phong1990/fufo-innovation/Document/04.Design/FUFO_VP/PCInterface.png

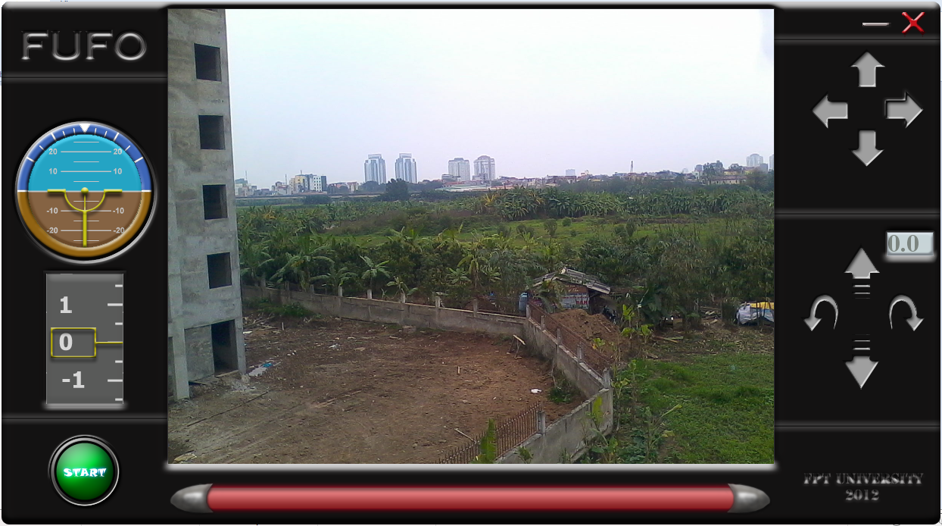
Document/04.Design/FUFO_VP/PCInterface.png
