phong1990/fufo-innovation/SourceCode/VP/AOC/pic/1009.jpg

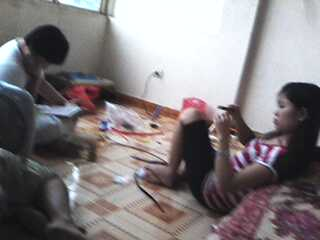
SourceCode/VP/AOC/pic/1009.jpg
