phong1990/fufo-innovation/Document/00.Other/Final_Report.pptx

## FUFO overview

Confidential document

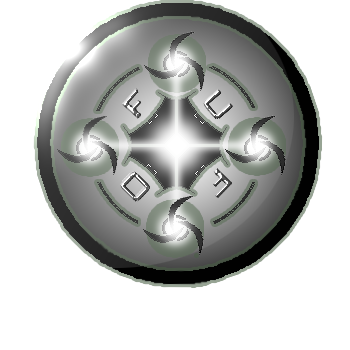
[picture p3: figure]

## Contents

1

Introduction

2

Hardware & Software

3

Algorithms

Experiments and results

4

5

Conclusion

## History

- Definition:
  - A Vertical Take-Off and Landing aircraft.
  - Has 4 rotors.

Introduction

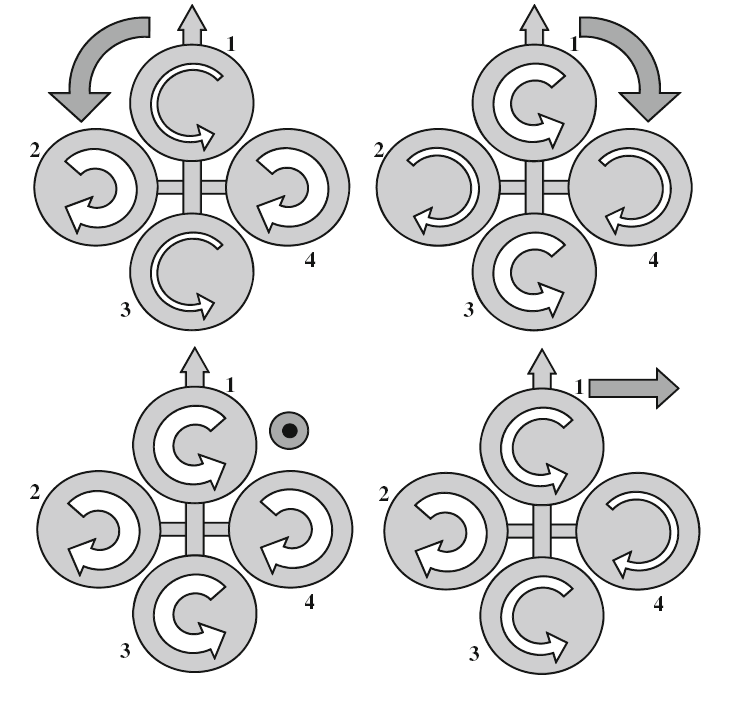
[picture p4: figure]

## History

- The first Quadrocopter was developed in 1920.
- No commercialized Quadrocopter because: Limitation of technology and science at that time.

Introduction

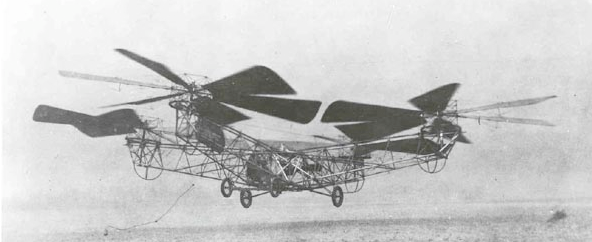
[picture p5: figure]

## History

Introduction

- 8 years before 2012, many institutes and companies began to research on this platform as a small UAV.

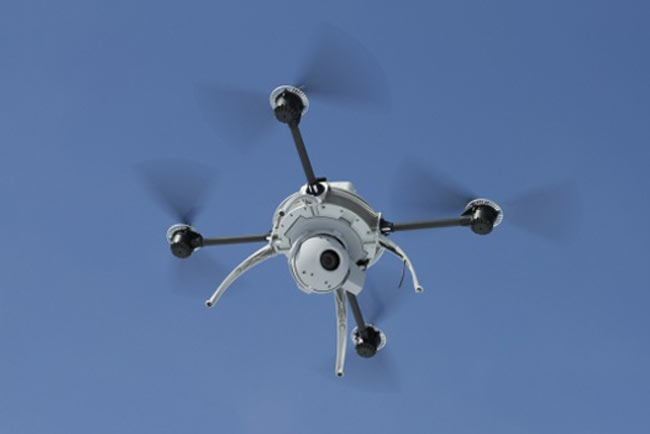
[picture p6: figure]
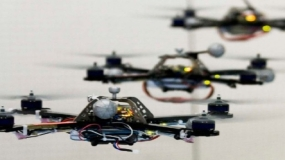
[picture p7: figure]

## Commercialized product

Introduction

- Airbot X600-BKPP (€ 34,500)
  - Radio control unit (2.4 GHz)
  - Live video stream
  - GPS waypoint navigation
- CyberQuad Maxi ($ 36,000)
  - Radio control unit
  - GPS waypoint navigation
  - Live video stream

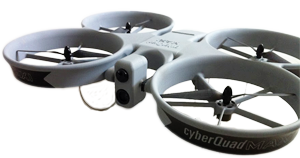
[picture p8: figure]

## Idea

Introduction

  - Develop a Quadrocopter for observation purpose.

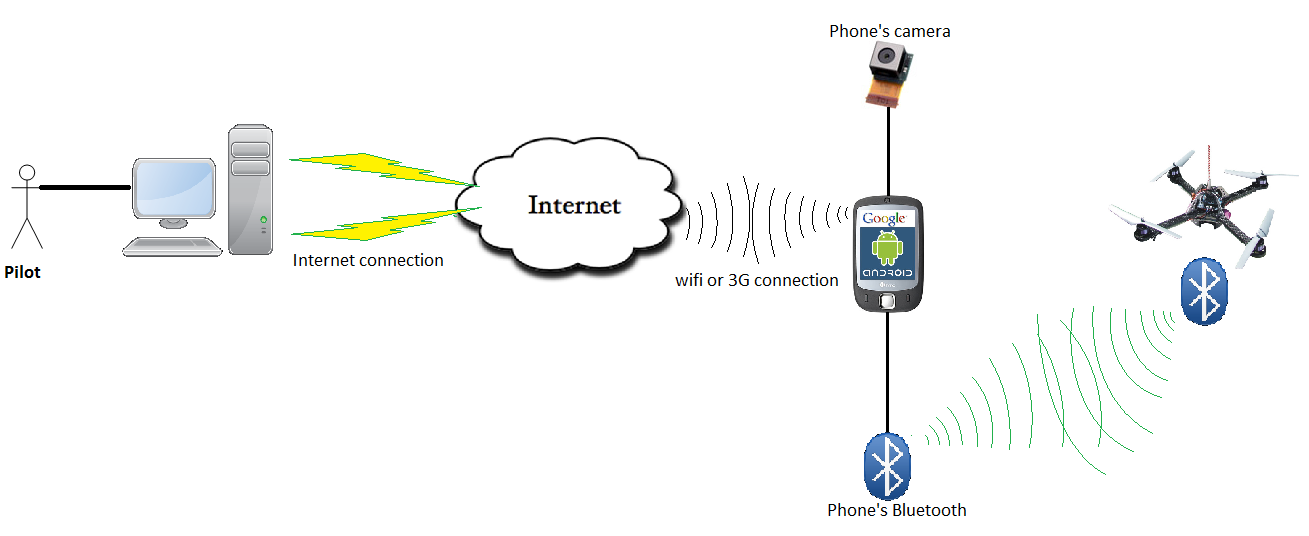
[picture p9: figure]

## Idea

Introduction

Why choosing Quadrocopter platform?

| Quadrocopter | Helicopter | Fixed-Wing aircraft
Aerodynamics mechanical design | No | Yes | Yes
Control method | Medium | Medium | Complicated
Runway | No | No | Yes

→ Quadrocopter is more suitable for embedded Engineering students who are not familiar with aerospace issue and mechanical design.

## Idea

Introduction

Why choosing Android Phone?

| Android phone | In-circuit designs
Software development | Android SDK | Linux, C30…
Evaluation of controlling by phone/tablet via Bluetooth? | Yes | No
Risk and complexity in hardware design | Low | High
Cost | Low | High

Has built-in camera, Wi-Fi, 3G module

Phone is still usable after this Capstone project

## Idea

Introduction

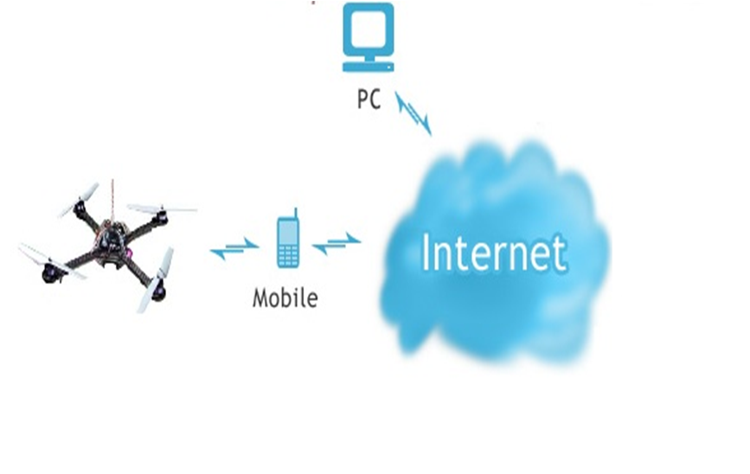
[picture p10: figure]

Command

Sensor data

Bluetooth

## Idea

Introduction

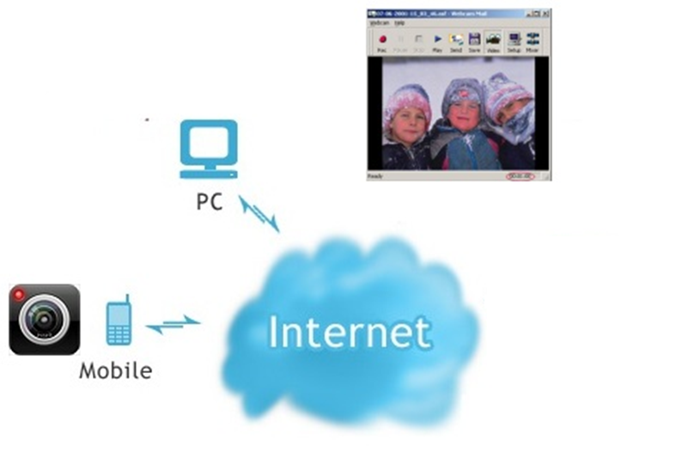
[picture p11: figure]

Picture

Picture

JPEG

JPEG

## Idea

Introduction

Control Mode

Autonomous(Dynamic Stabilization)

Manual

## Idea

Introduction

Wind

Manual mode

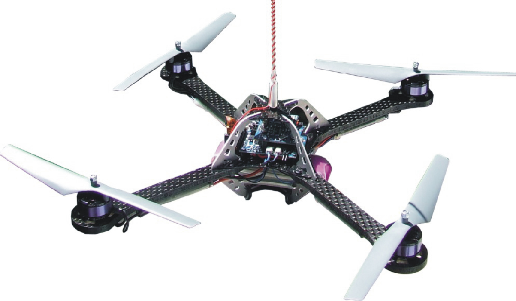
[picture p12: figure]

## Idea

Introduction

Dynamic stabilization

Wind

Dynamic Stablization

SAFE

Go to 1m

## Hardware study

Hard & Soft

No. | Components | Quantity | Description
1 | dsPIC30f4012 | 1 | Microcontroller
2 | HC-06 | 1 | Bluetooth module
3 | BMP085 | 1 | Barometer
4 | L3G4200D | 1 | Gyroscope
5 | ADXL345 | 1 | Accelerometer
6 | HW 30A ESC | 4 | Electronic speed Controller
7 | Himodel 2212 1400kv | 4 | Brushless motor
8 | Turnigy 3000mAh 11.1v 3s | 2 | Li-Po battery pack.
9 | HTC HD2 | 1 | Android 2.3 phone

## Hardware study

Hard & Soft

- dsPIC30f4012 Microcontroller
  - Max speed: 30 MIPS
  - 16x16 bit working arrays
  - 5 timers, 3 PWM generators
  - Programmable by C30.

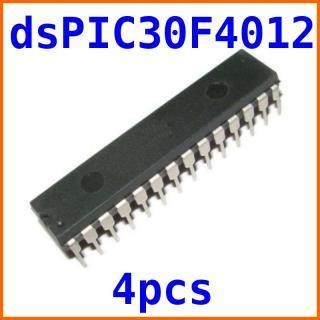
[picture p13: figure]
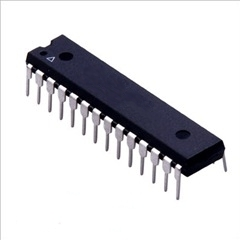
[picture p14: figure]

## Hardware study

Hard & Soft

- BMP085 + ADX345 + L3G4200D
  - All-in-one module:
    - 3-axis accelerometer.
    - 3-axis gyroscope.
    - -300m to 9000m altimeter.

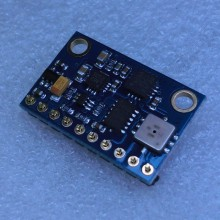
[picture p15: figure]
T1gdiIXh0bXXX2ojQ0_035736__90155_std

## Hardware study

Hard & Soft

- Turnigy 3000mAh battery pack
  - 3000mAh x 2
  - 253 grams x 2
  - 11.1v
  - Discharge rate: 20C

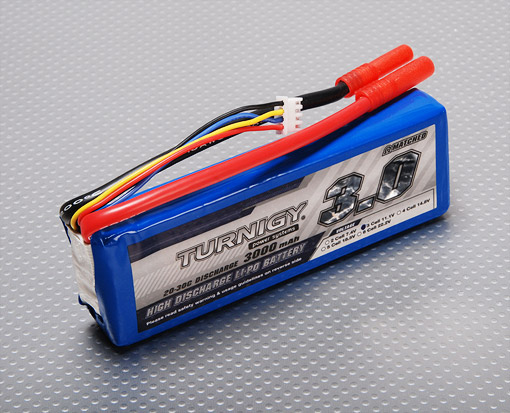
[picture p16: figure]
Turnigy 3000mAh 3S 20C Lipo Pack (USA Warehouse)

## Hardware study

Hard & Soft

- Motor and ESC
  - 1400kv Brushless motors
  - 8x4” propellers
  - ESC PWM range: 1ms – 2ms

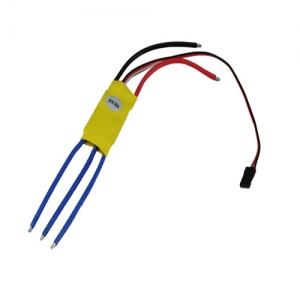
[picture p17: figure]
Brushless Motor Speed Controller
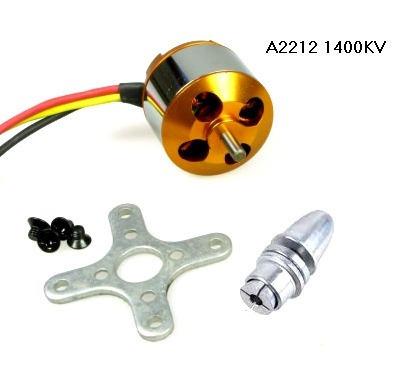
[picture p18: figure]

## Hardware study

Hard & Soft

- HTC HD2 Android 2.3
  - 320x240 camera.
  - Has Bluetooth and Wi-Fi connection
  - Run on Android 2.3

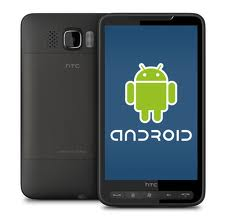
[picture p19: figure]

## Hardware design

Hard & Soft

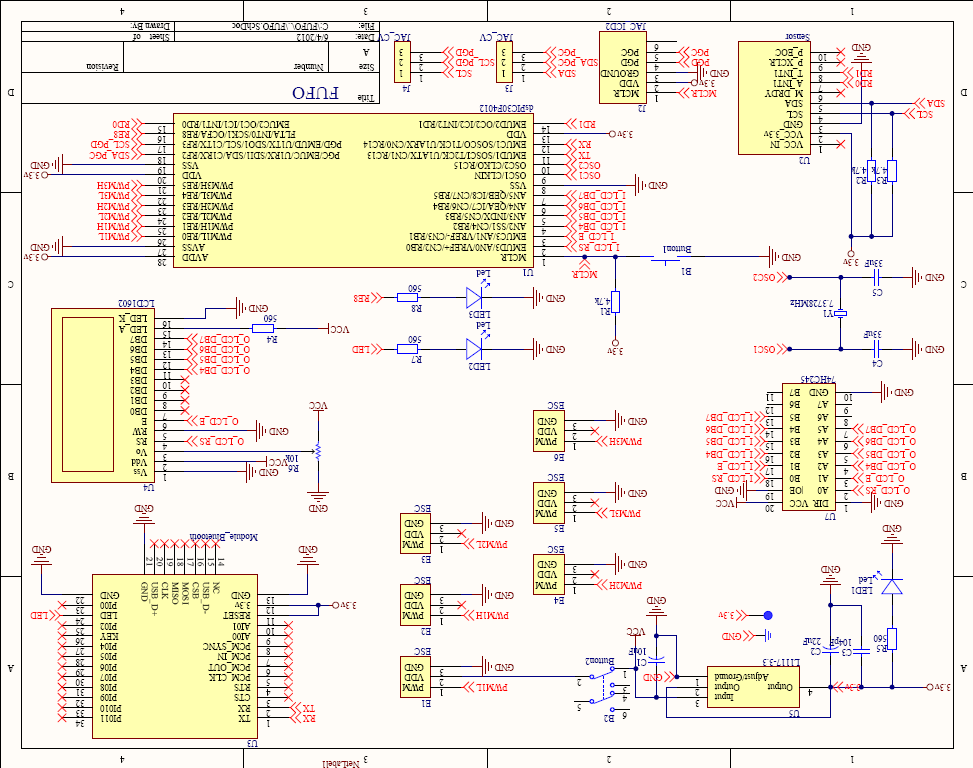
[picture p20: figure]

## Hardware design

Hard & Soft

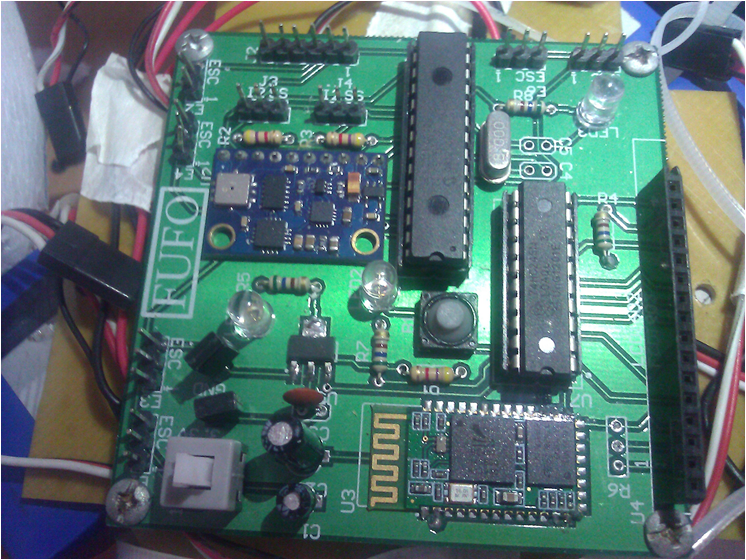
[picture p21: figure]

## Frame design

Hard & Soft

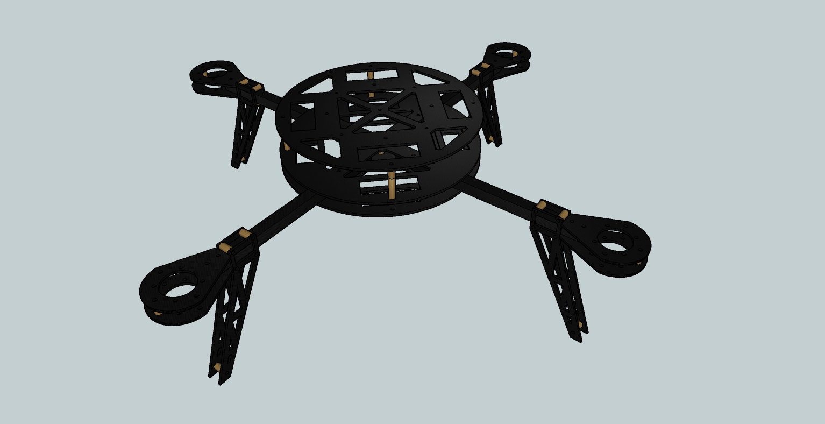
[picture p22: figure]

Circuit mount

Motor mount

440 mm

Fiber Glass & Fiber Carbon

## Software study

Hard & Soft

- Turnigy 3000mAh battery pack
  - 3000mAh x 2
  - 253 grams x 2
  - 11.1v
  - Discharge rate: 20C

## Software study

Hard & Soft

## Slide 26

www.themegallery.com

Thank You !

Confidential document

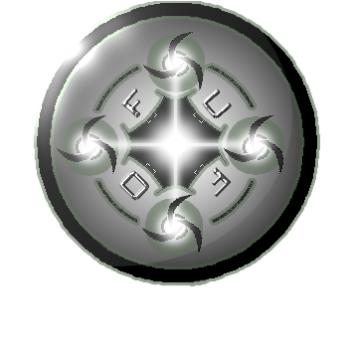
[picture p23: figure]
