phong1990/fufo-innovation/Anh/IMG_3640.JPG

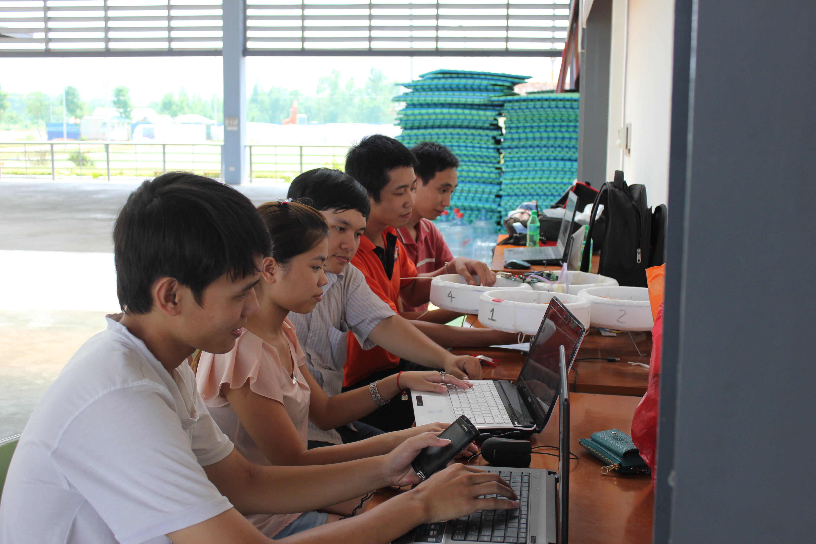
Anh/IMG_3640.JPG
