phong1990/fufo-innovation/Anh/IMG_3641.JPG

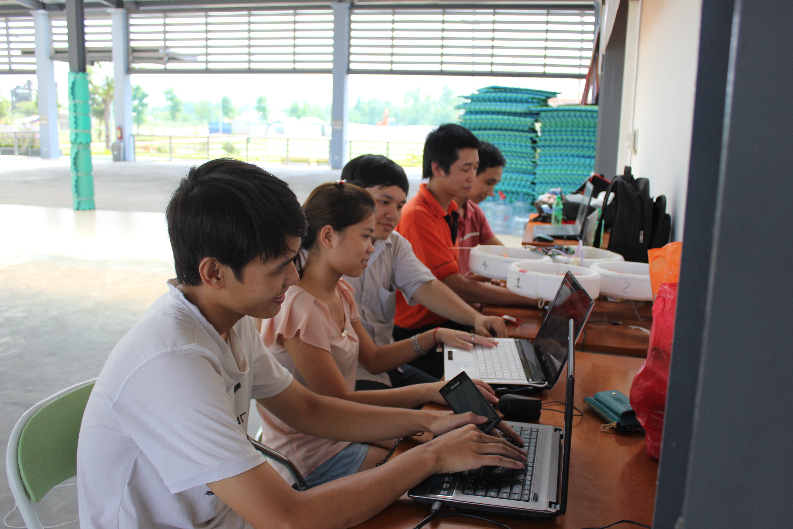
Anh/IMG_3641.JPG
