phong1990/fufo-innovation/Anh/IMG_3642.JPG

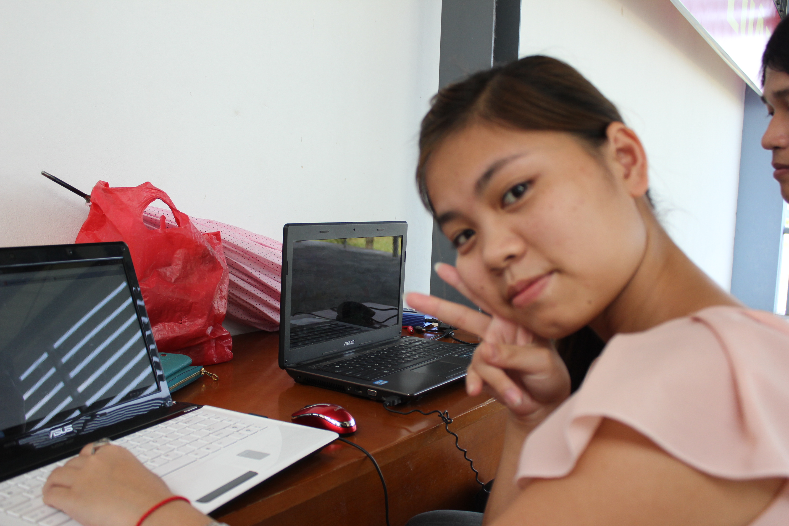
Anh/IMG_3642.JPG
