phong1990/fufo-innovation/Anh/IMG_3645.JPG

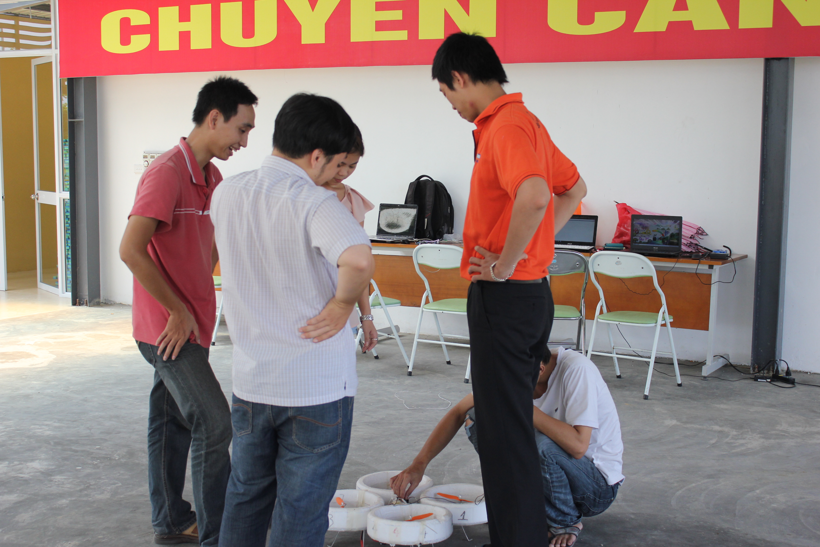
Anh/IMG_3645.JPG
