phong1990/fufo-innovation/Anh/IMG_3652.JPG

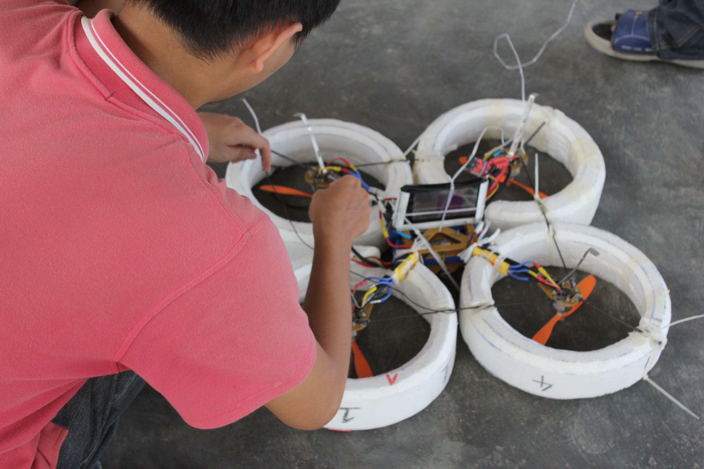
Anh/IMG_3652.JPG
