phong1990/fufo-innovation/Anh/IMG_3666.JPG

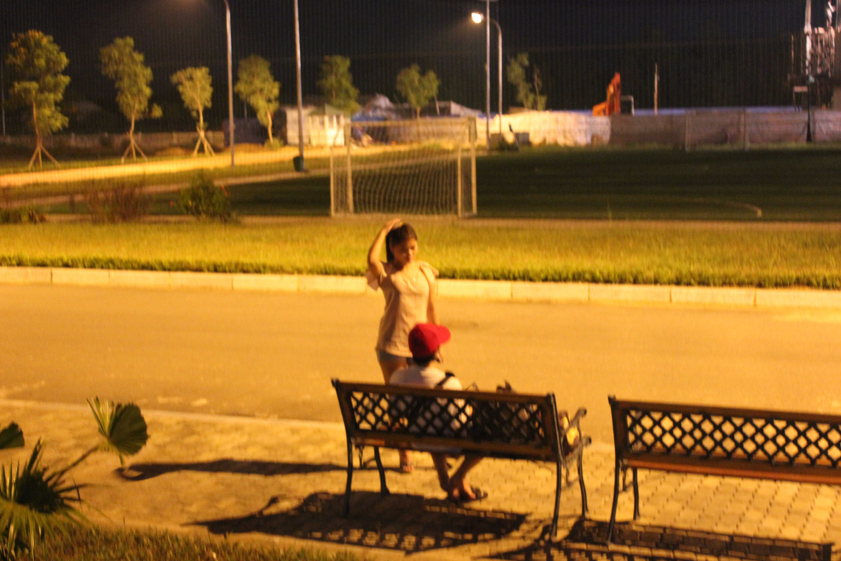
Anh/IMG_3666.JPG
