phong1990/fufo-innovation/Anh/IMG_3668.JPG

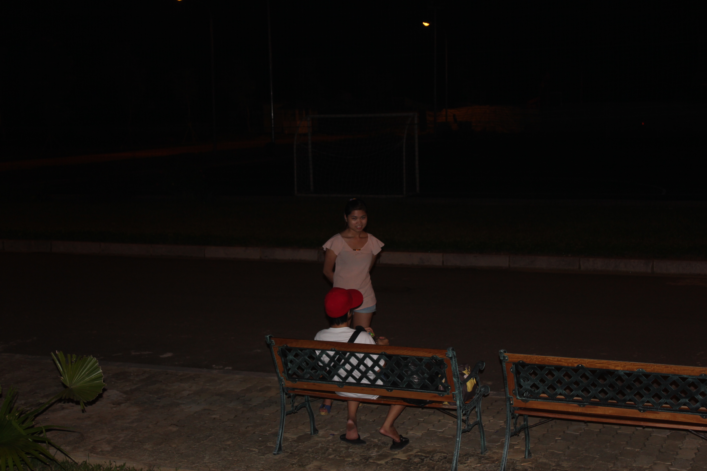
Anh/IMG_3668.JPG
