phong1990/fufo-innovation/Anh/IMG_3669.JPG

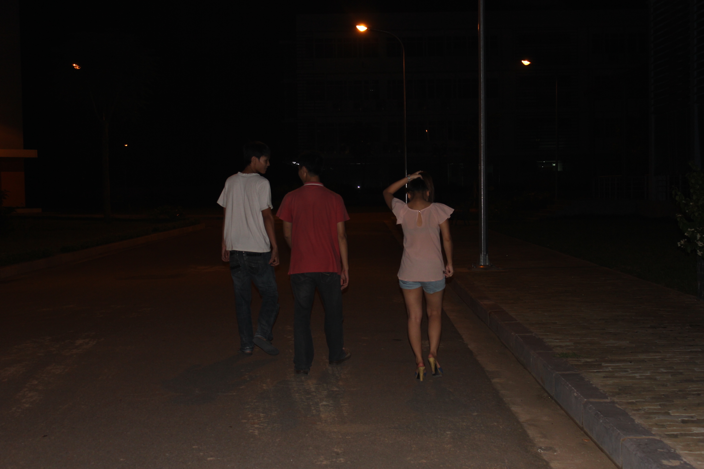
Anh/IMG_3669.JPG
