phong1990/fufo-innovation/Anh/IMG_3670.JPG

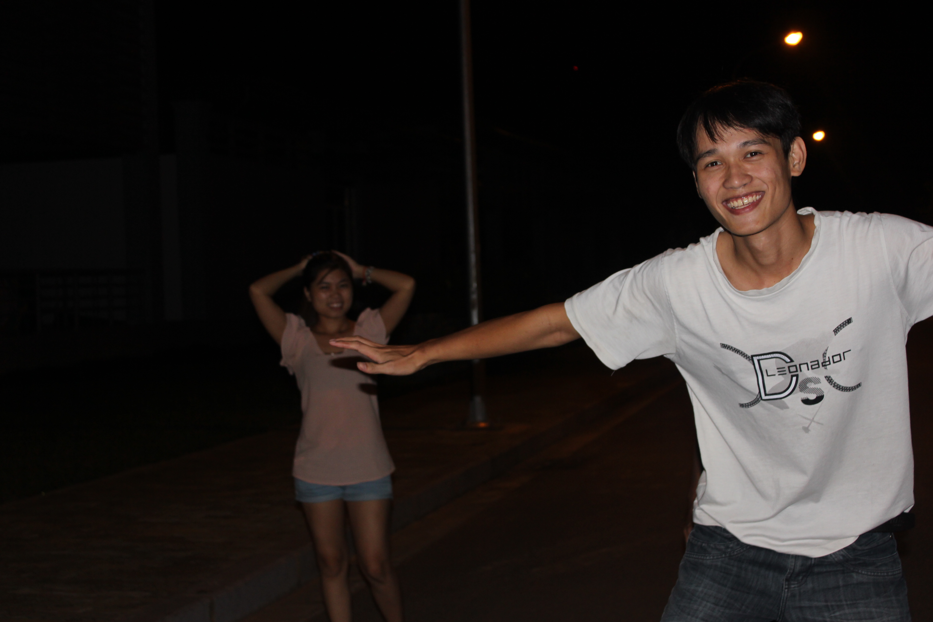
Anh/IMG_3670.JPG
