phong1990/fufo-innovation/Anh/IMG_3671.JPG

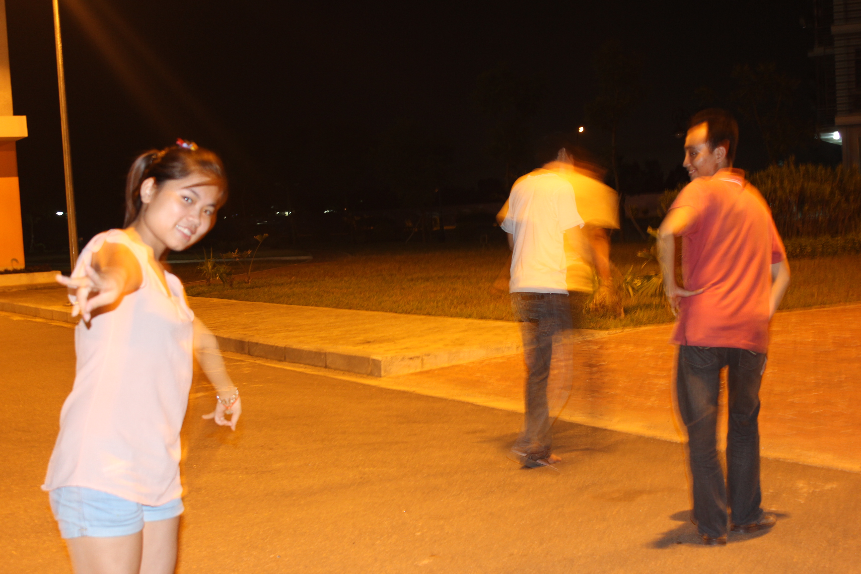
Anh/IMG_3671.JPG
