phong1990/fufo-innovation/Anh/IMG_3672.JPG

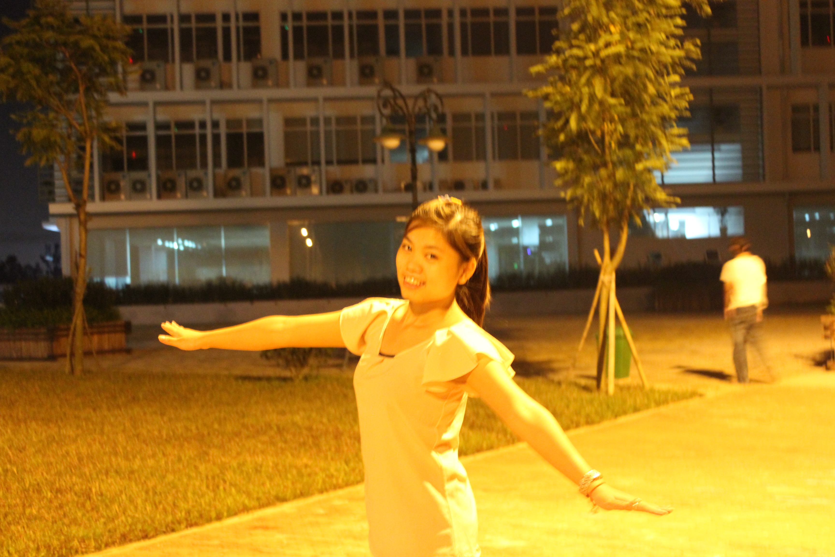
Anh/IMG_3672.JPG
