phong1990/fufo-innovation/Anh/IMG_3673.JPG

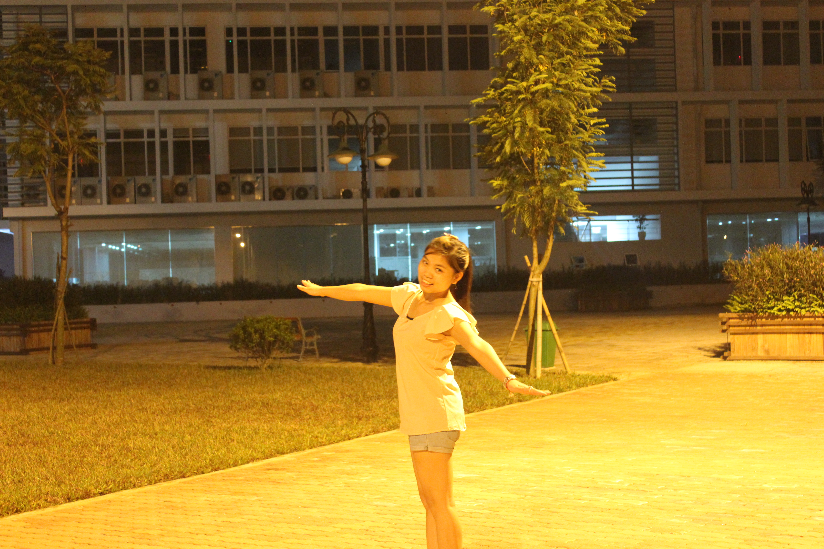
Anh/IMG_3673.JPG
