phong1990/fufo-innovation/Anh/IMG_3679.JPG

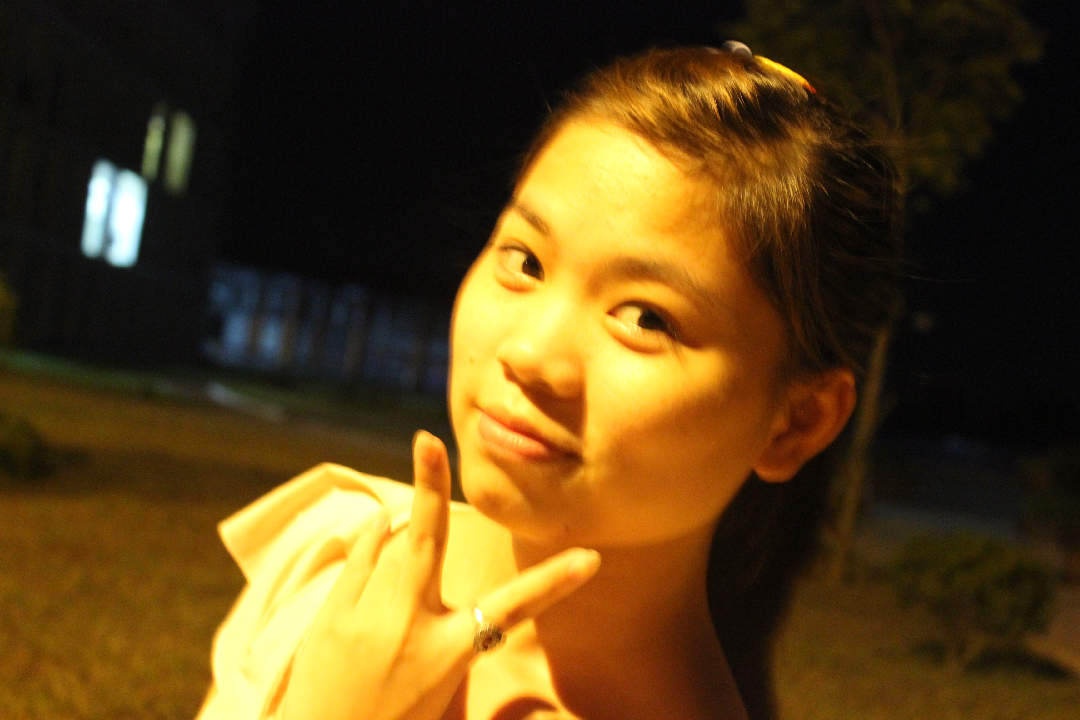
Anh/IMG_3679.JPG
