phong1990/fufo-innovation/Anh/IMG_3681.JPG

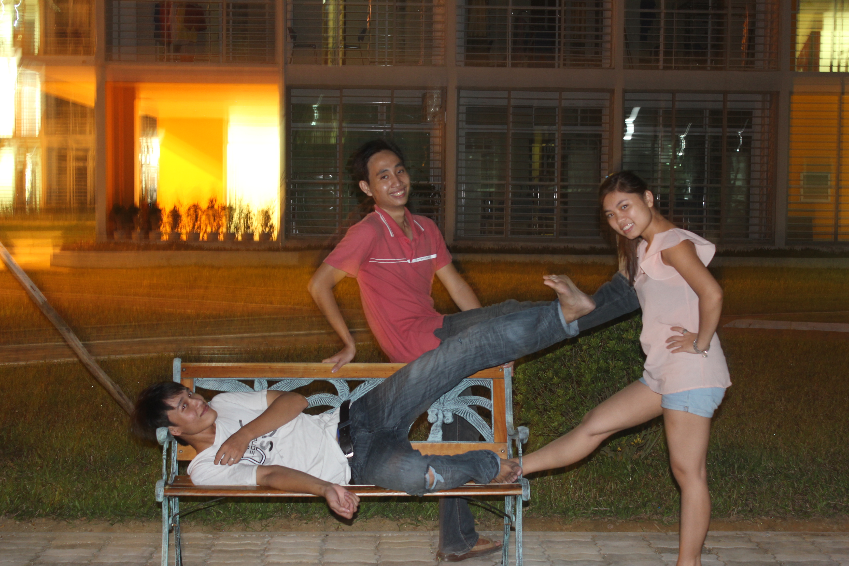
Anh/IMG_3681.JPG
