phong1990/fufo-innovation/Anh/IMG_3682.JPG

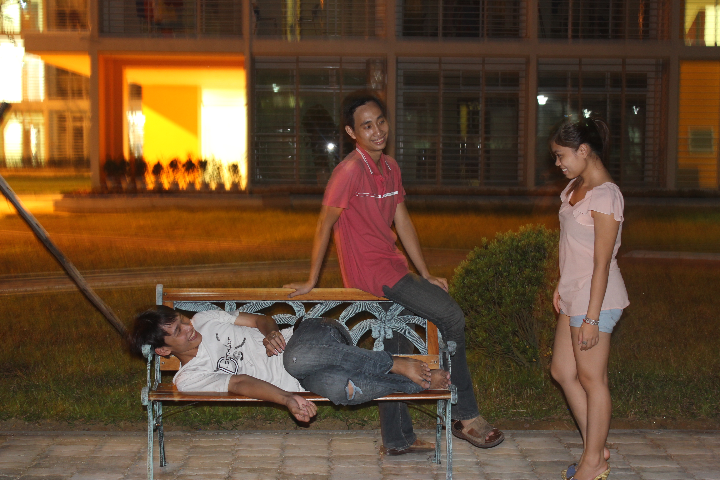
Anh/IMG_3682.JPG
