phong1990/fufo-innovation/Anh/IMG_3683.JPG

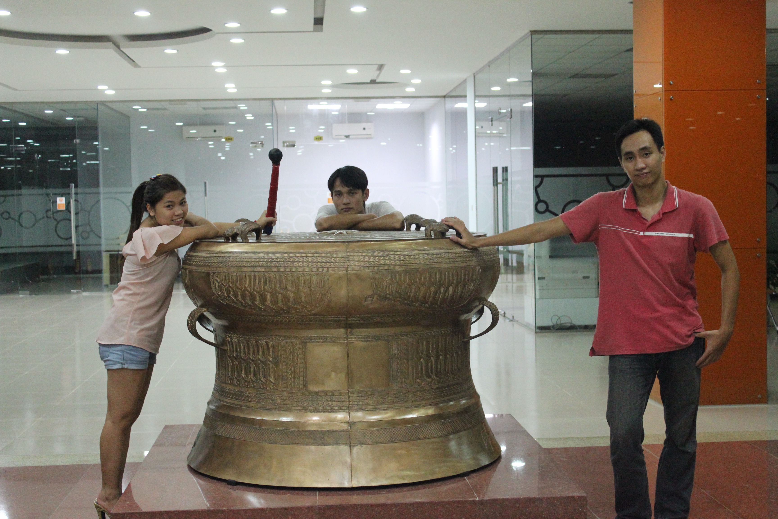
Anh/IMG_3683.JPG
