phong1990/fufo-innovation/Anh/IMG_3686.JPG

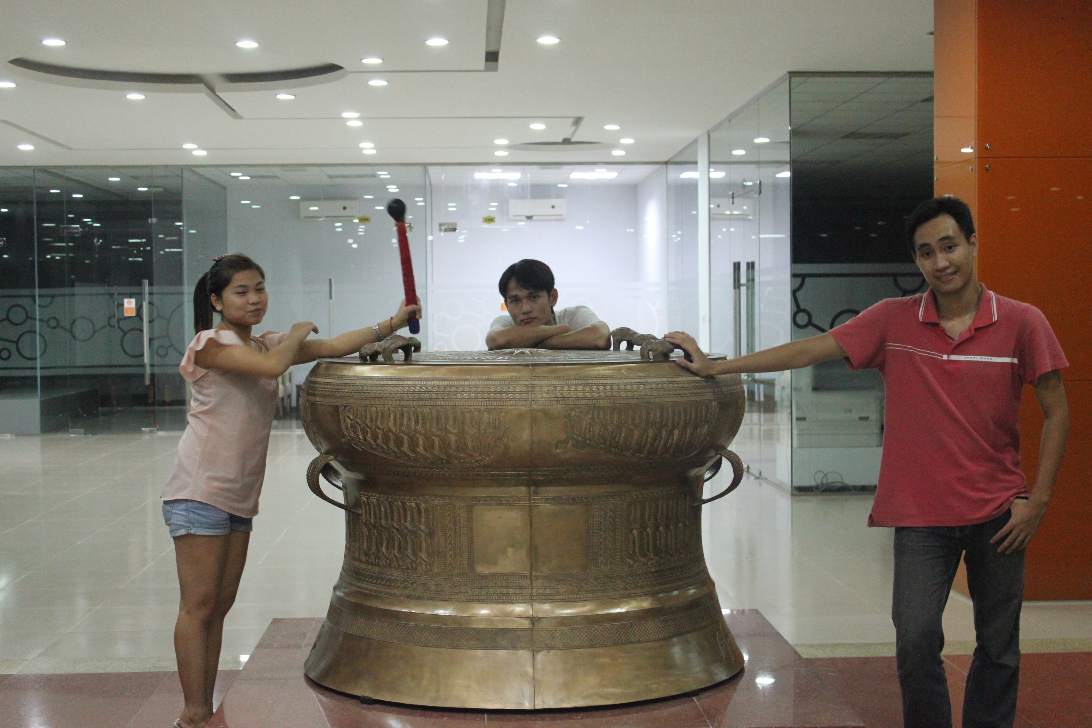
Anh/IMG_3686.JPG
