phong1990/fufo-innovation/Anh/IMG_3689.JPG

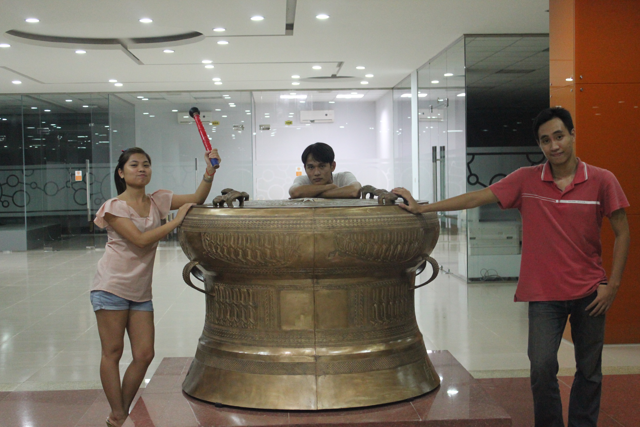
Anh/IMG_3689.JPG
