phong1990/fufo-innovation/Anh/IMG_3690.JPG

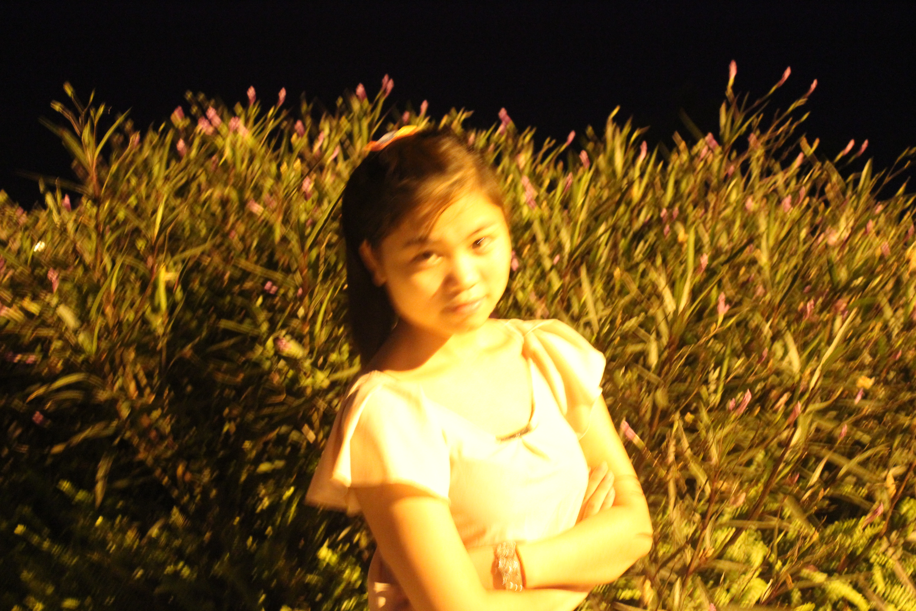
Anh/IMG_3690.JPG
