phong1990/fufo-innovation/Anh/IMG_3693.JPG

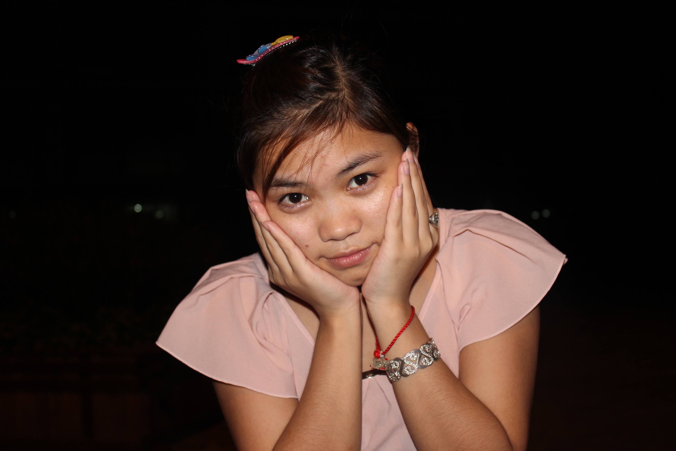
Anh/IMG_3693.JPG
