phong1990/fufo-innovation/Anh/IMG_3694.JPG

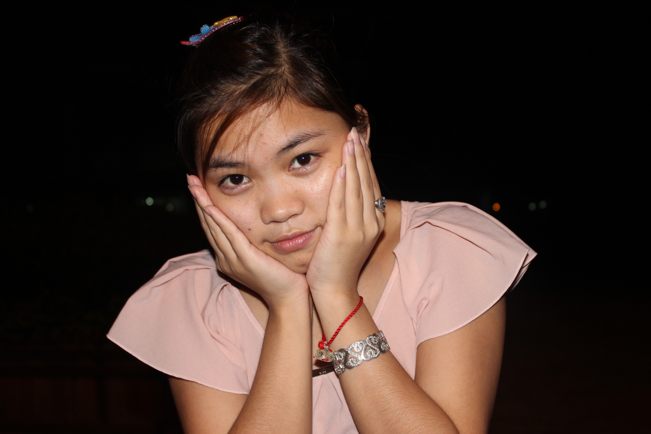
Anh/IMG_3694.JPG
