phong1990/fufo-innovation/Anh/IMG_3695.JPG

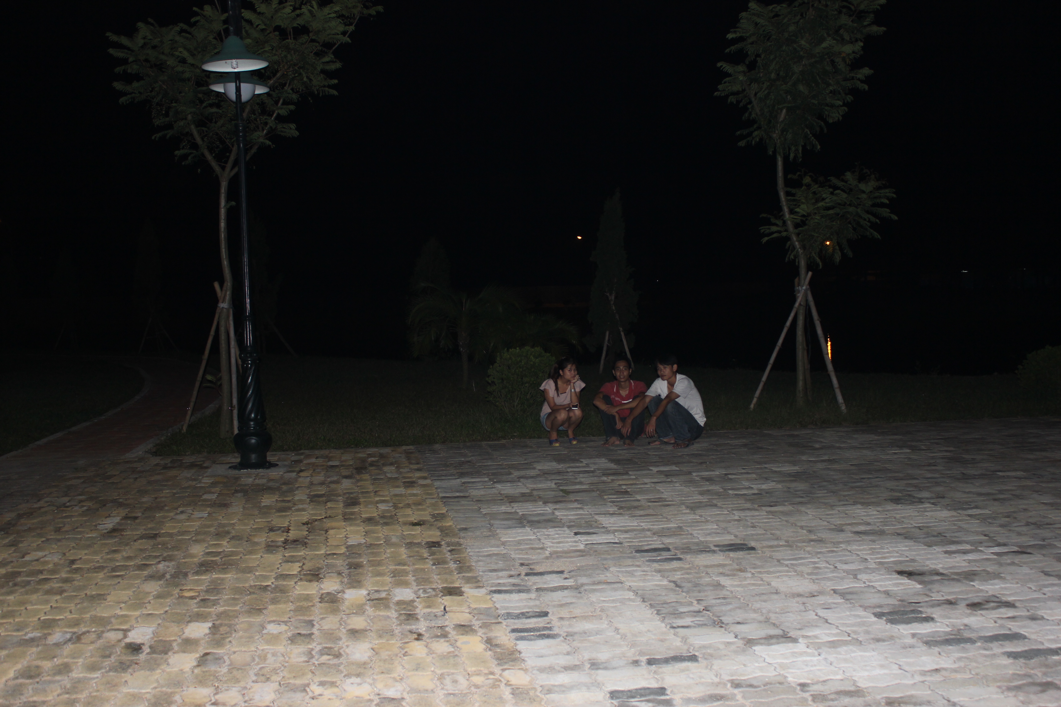
Anh/IMG_3695.JPG
