phong1990/fufo-innovation/Anh/IMG_3696.JPG

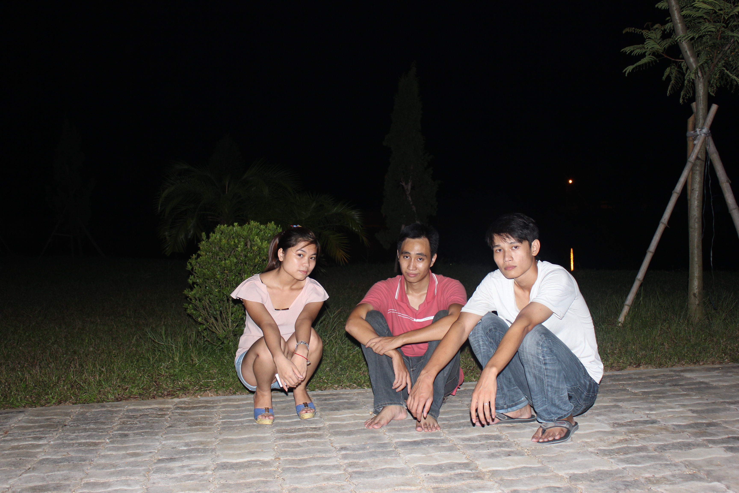
Anh/IMG_3696.JPG
