phong1990/fufo-innovation/Anh/IMG_3697.JPG

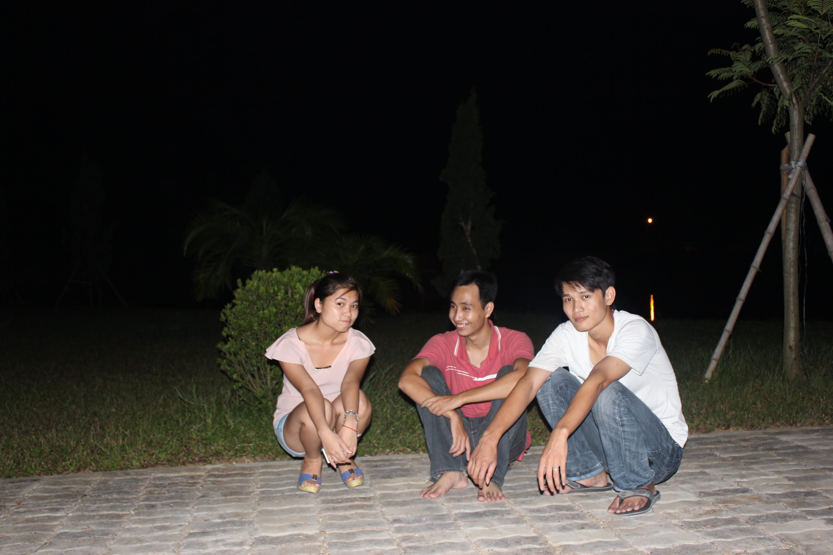
Anh/IMG_3697.JPG
