phong1990/fufo-innovation/Anh/IMG_3698.JPG

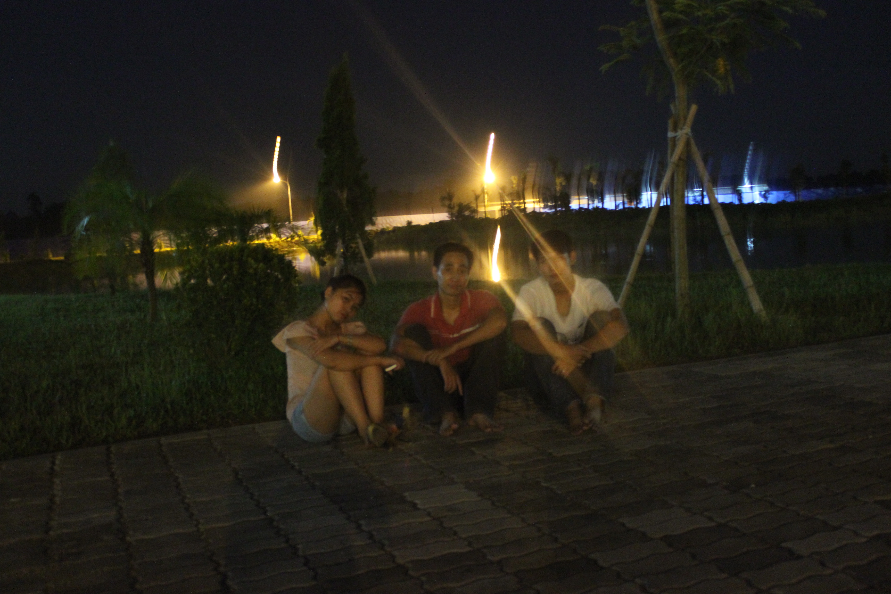
Anh/IMG_3698.JPG
