phong1990/fufo-innovation/Anh/IMG_3699.JPG

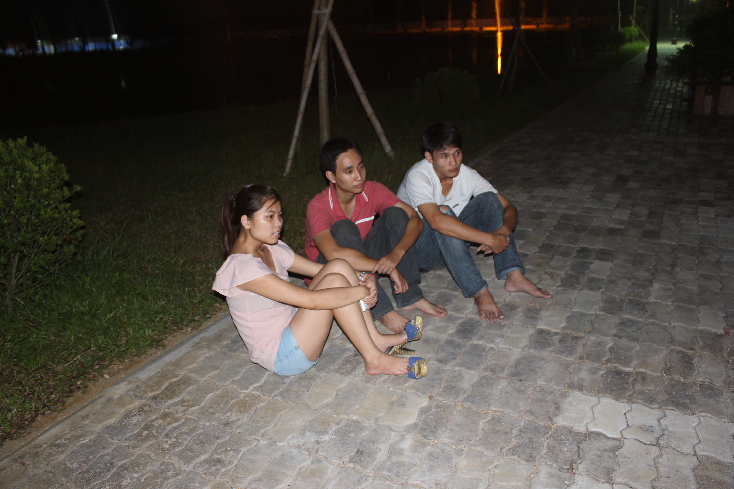
Anh/IMG_3699.JPG
