phong1990/fufo-innovation/Anh/IMG_3700.JPG

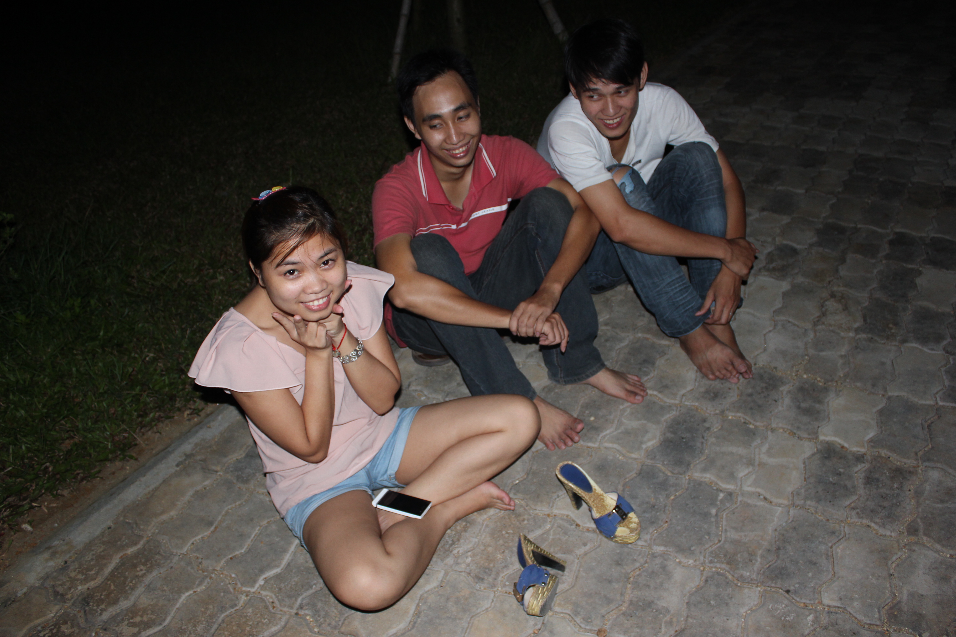
Anh/IMG_3700.JPG
