phong1990/fufo-innovation/Anh/IMG_3701.JPG

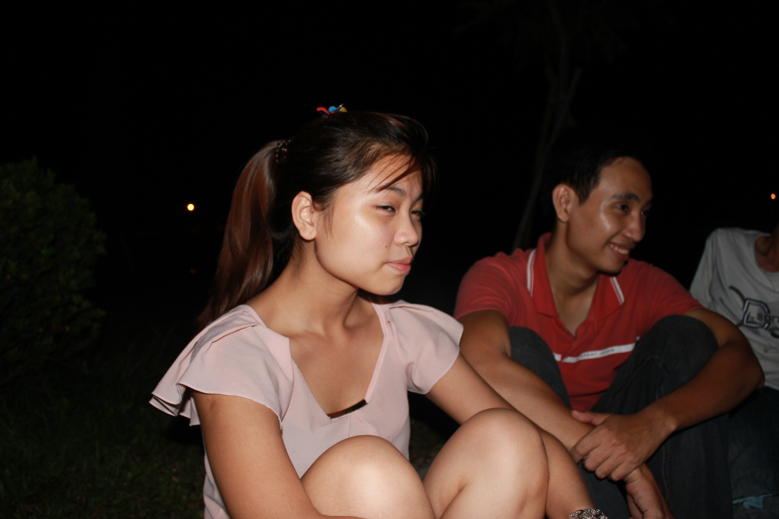
Anh/IMG_3701.JPG
