phong1990/fufo-innovation/Anh/IMG_3702.JPG

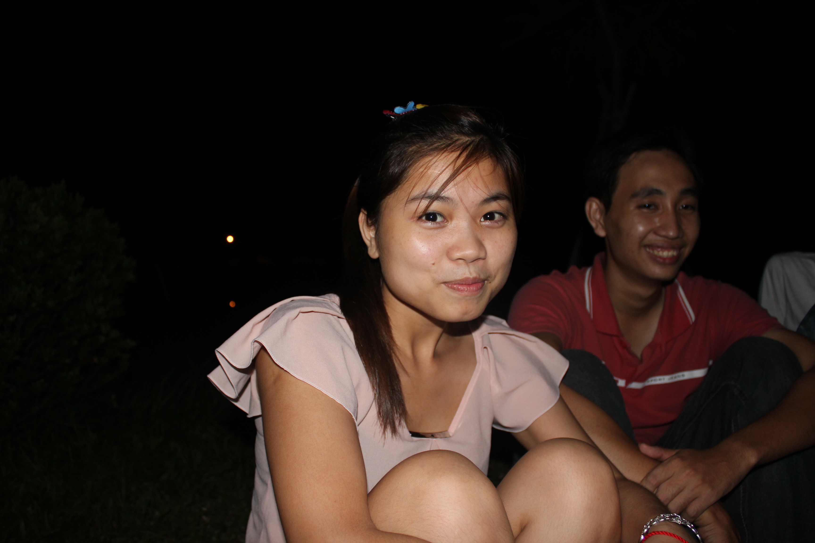
Anh/IMG_3702.JPG
