phong1990/fufo-innovation/Anh/IMG_3703.JPG

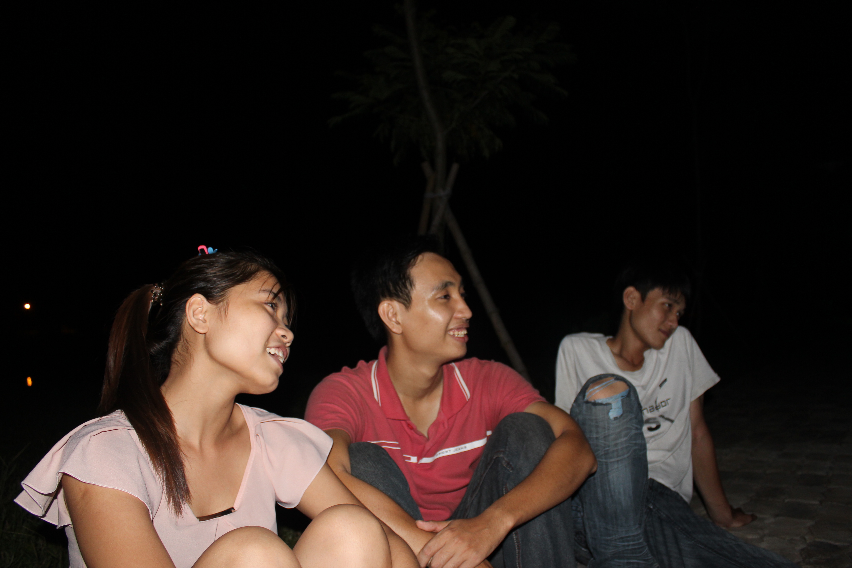
Anh/IMG_3703.JPG
