phong1990/fufo-innovation/Anh/IMG_3704.JPG

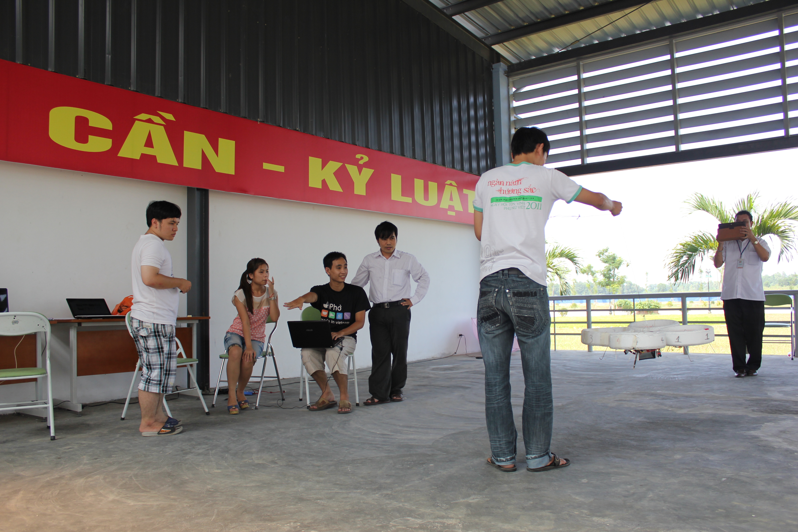
Anh/IMG_3704.JPG
