phong1990/fufo-innovation/Anh/IMG_3705.JPG

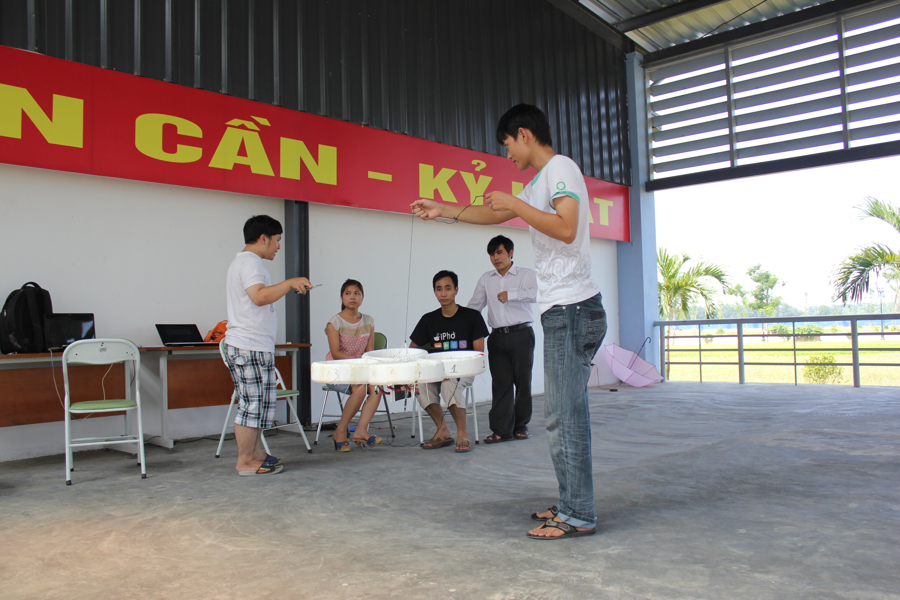
Anh/IMG_3705.JPG
