phong1990/fufo-innovation/Anh/IMG_3707.JPG

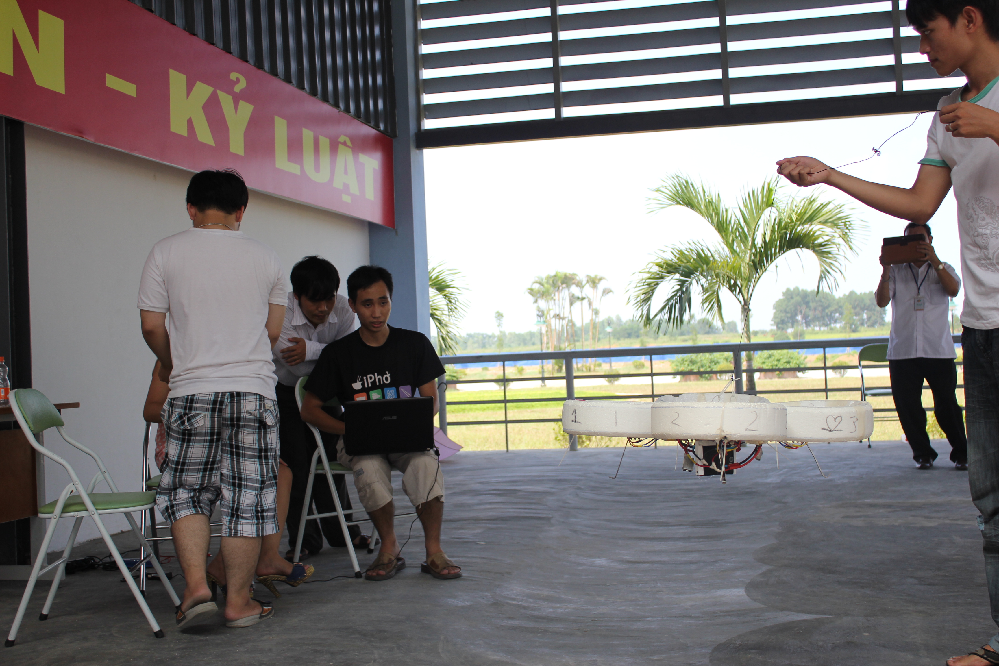
Anh/IMG_3707.JPG
