phong1990/fufo-innovation/Anh/IMG_3708.JPG

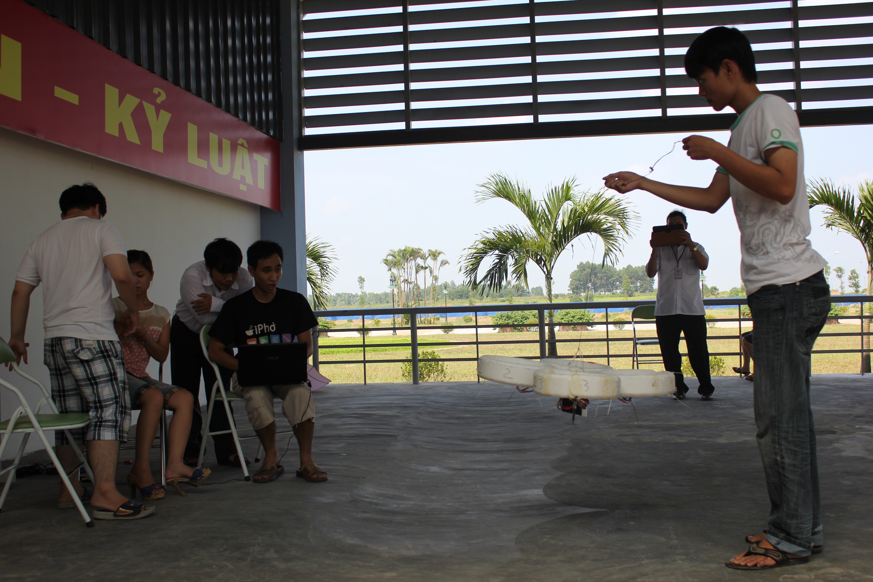
Anh/IMG_3708.JPG
