phong1990/fufo-innovation/Anh/IMG_3709.JPG

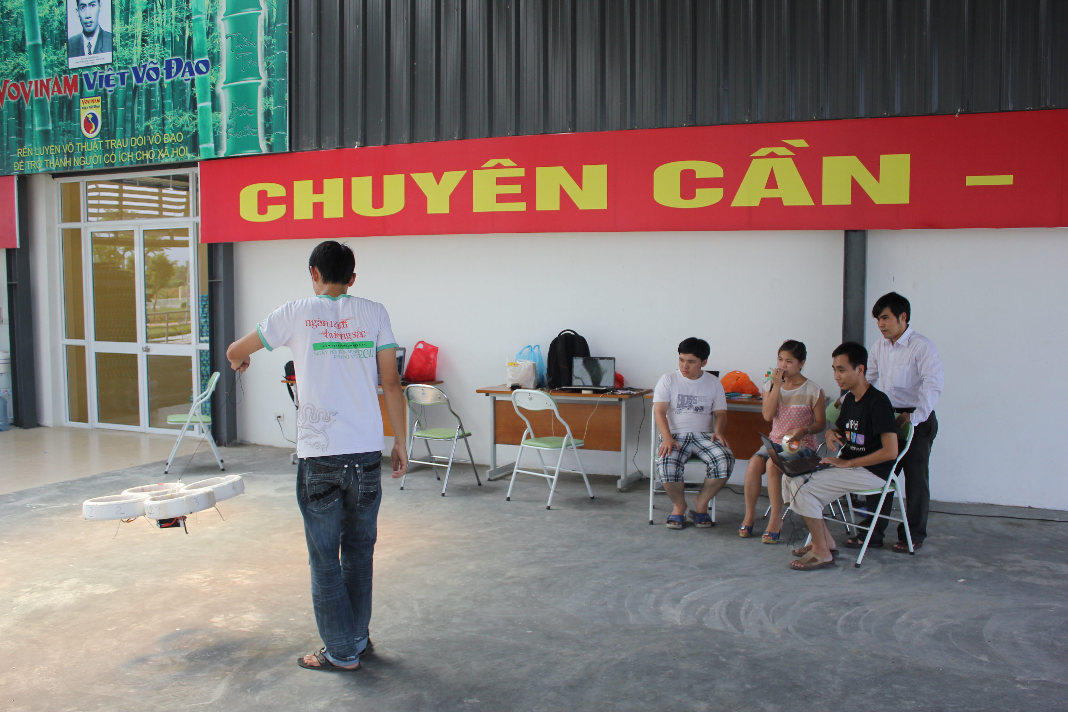
Anh/IMG_3709.JPG
