phong1990/fufo-innovation/Anh/IMG_3711.JPG

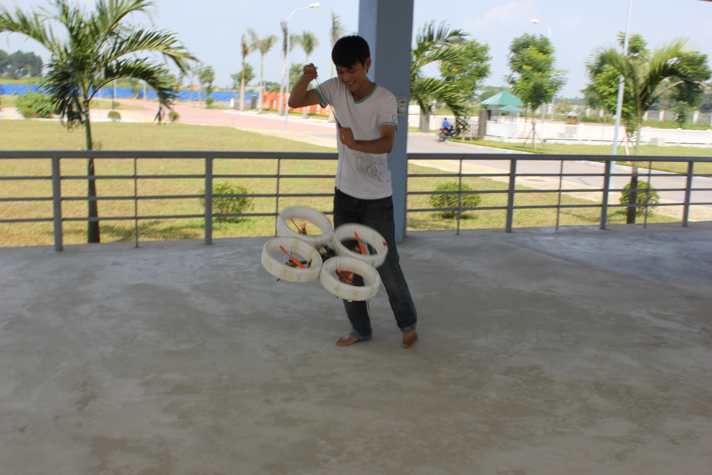
Anh/IMG_3711.JPG
