phong1990/fufo-innovation/Anh/IMG_3713.JPG

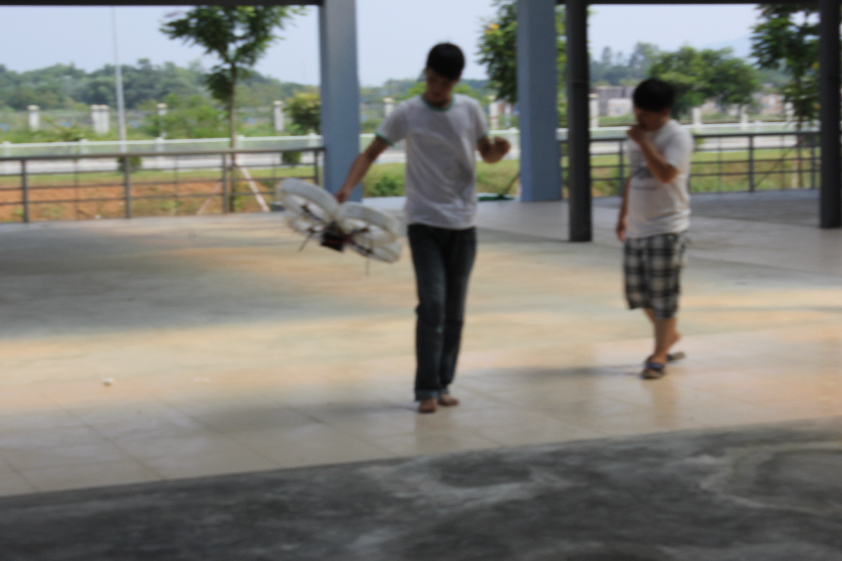
Anh/IMG_3713.JPG
