phong1990/fufo-innovation/Anh/IMG_3715.JPG

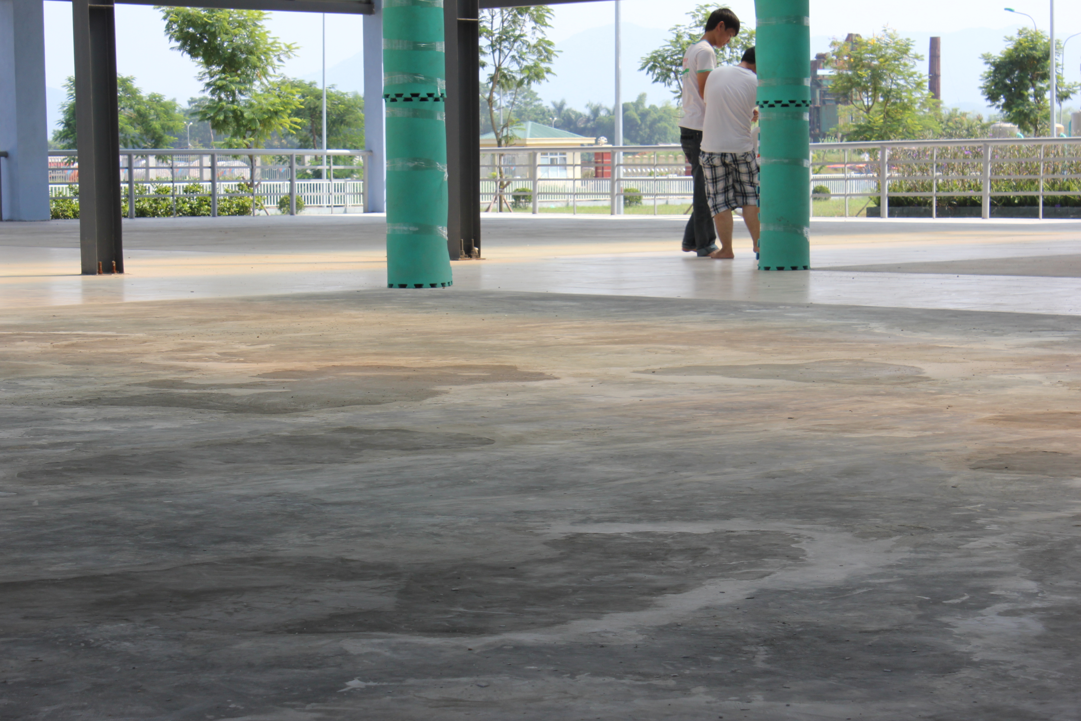
Anh/IMG_3715.JPG
