phong1990/fufo-innovation/Anh/IMG_3717.JPG

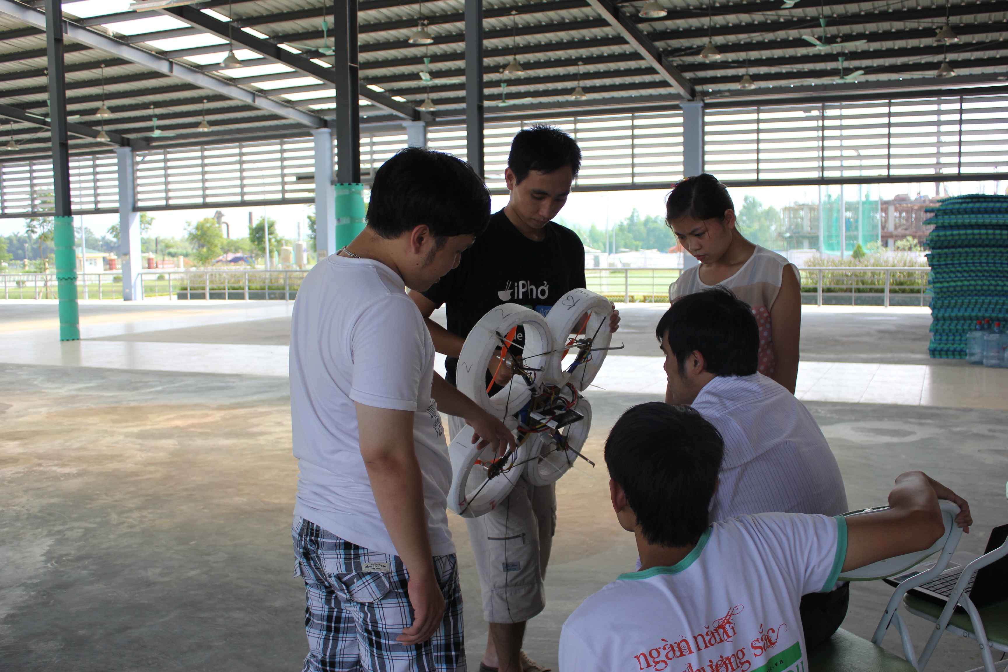
Anh/IMG_3717.JPG
