phong1990/fufo-innovation/Anh/IMG_3718.JPG

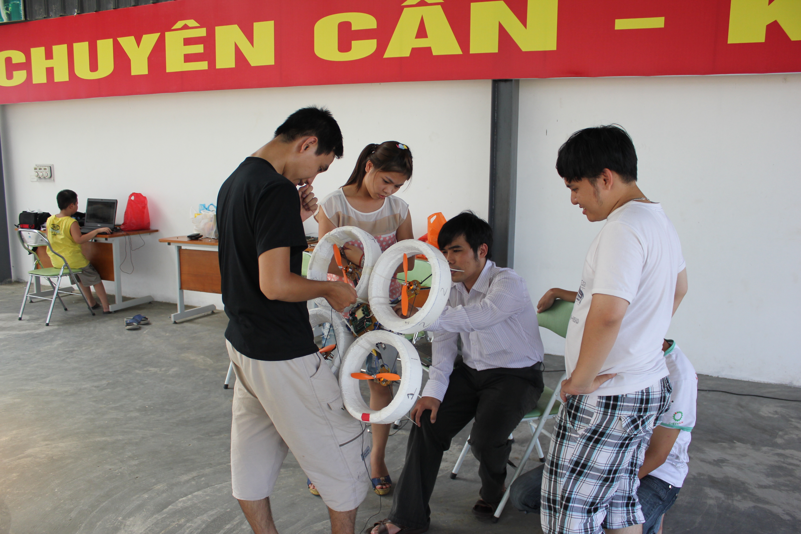
Anh/IMG_3718.JPG
