phong1990/fufo-innovation/Anh/IMG_3720.JPG

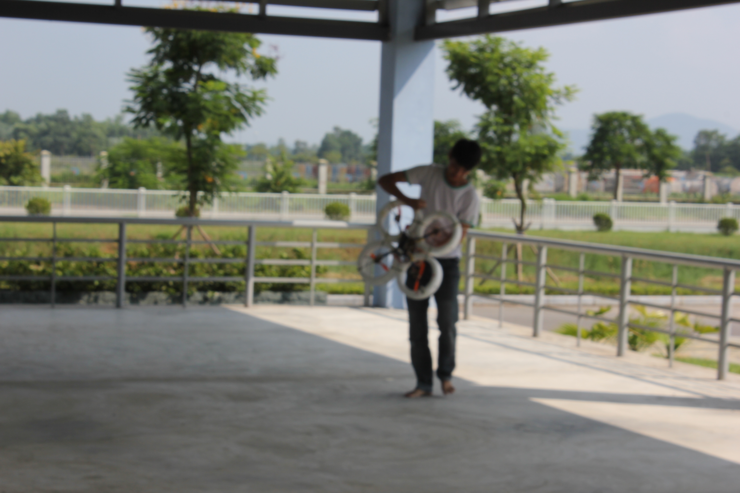
Anh/IMG_3720.JPG
