phong1990/fufo-innovation/Anh/IMG_3721.JPG

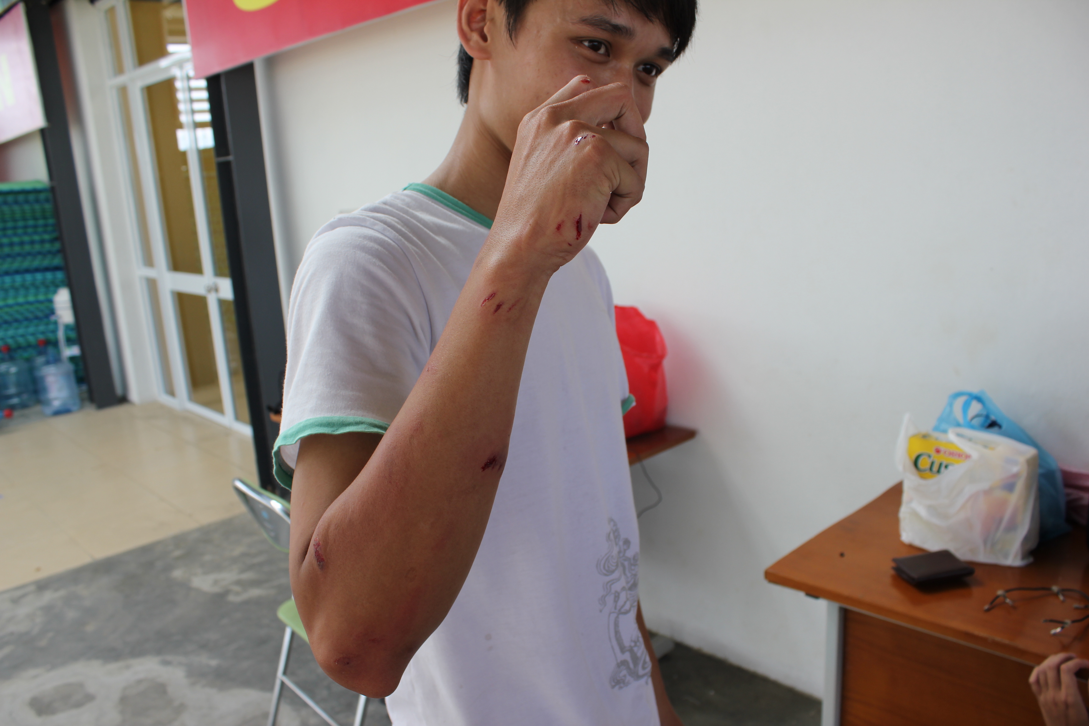
Anh/IMG_3721.JPG
