phong1990/fufo-innovation/Anh/IMG_3724.JPG

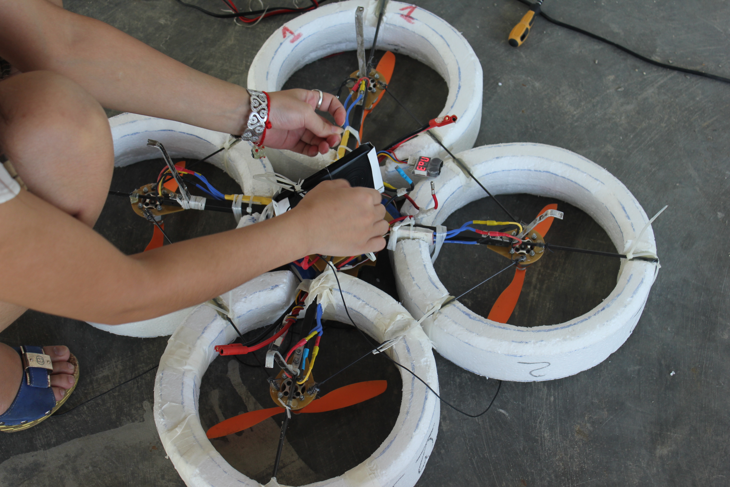
Anh/IMG_3724.JPG
