phong1990/fufo-innovation/Anh/IMG_3725.JPG

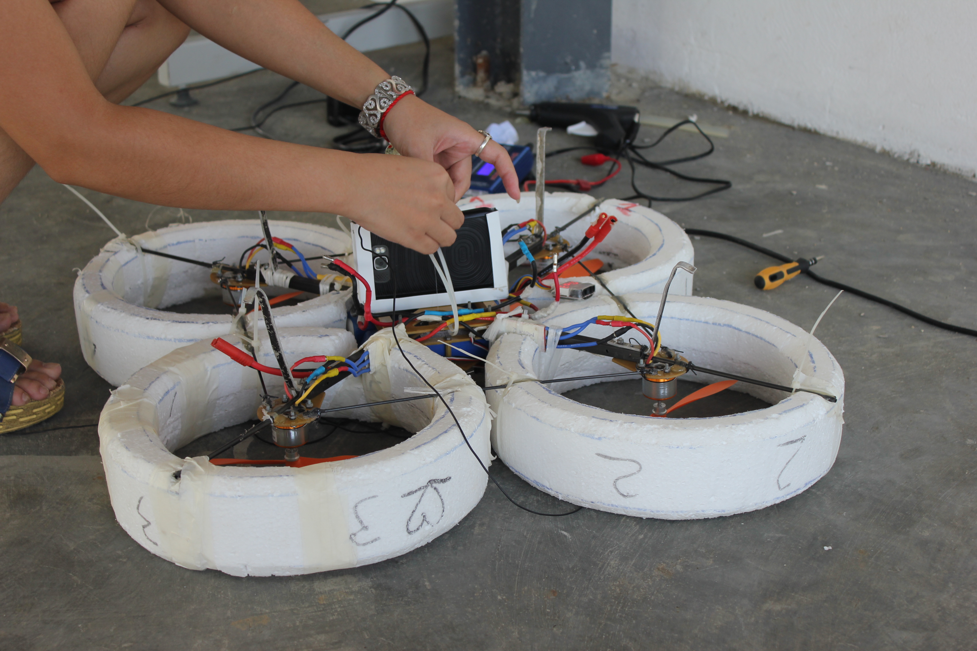
Anh/IMG_3725.JPG
