phong1990/fufo-innovation/Anh/IMG_3726.JPG

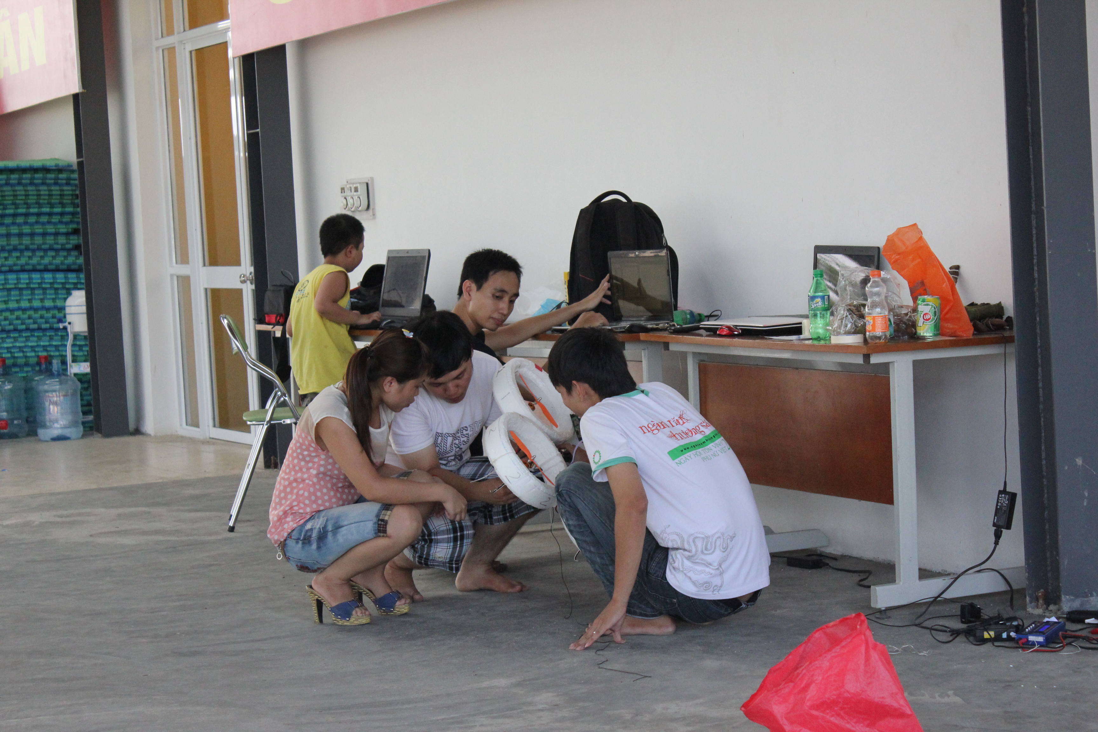
Anh/IMG_3726.JPG
