phong1990/fufo-innovation/Anh/IMG_3738.JPG

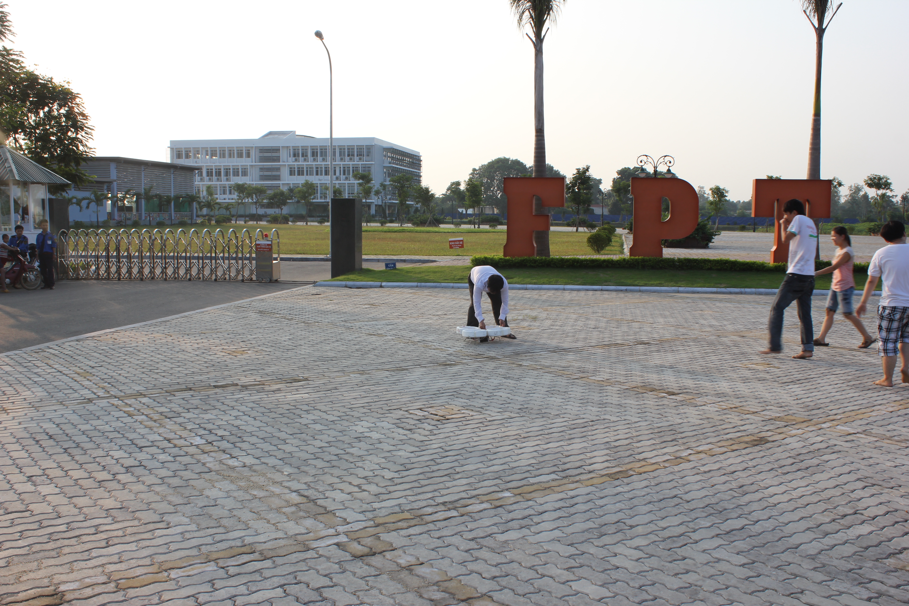
Anh/IMG_3738.JPG
