phong1990/fufo-innovation/Anh/IMG_3740.JPG

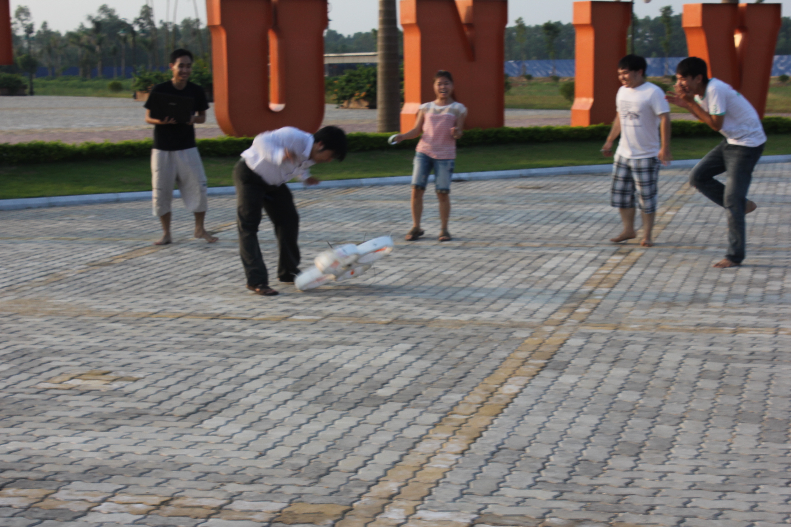
Anh/IMG_3740.JPG
