phong1990/fufo-innovation/Anh/IMG_3742.JPG

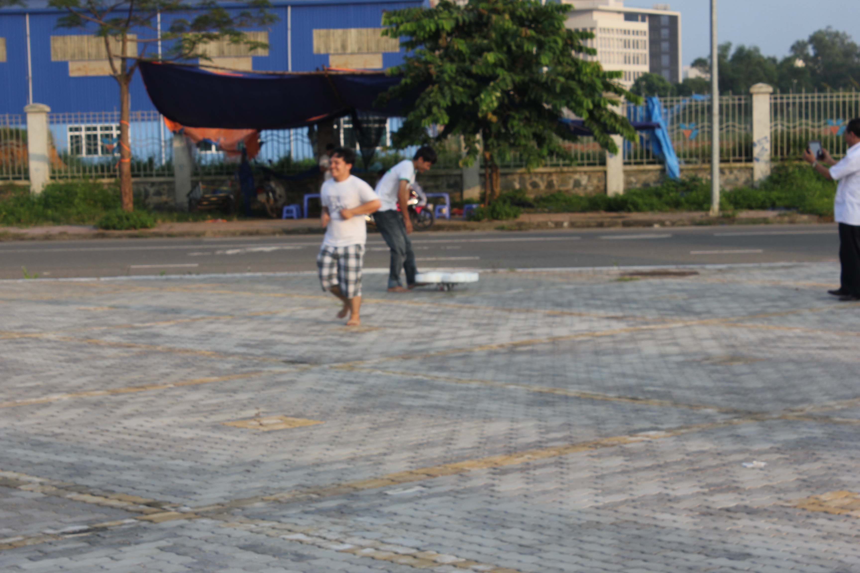
Anh/IMG_3742.JPG
