phong1990/fufo-innovation/Anh/IMG_3743.JPG

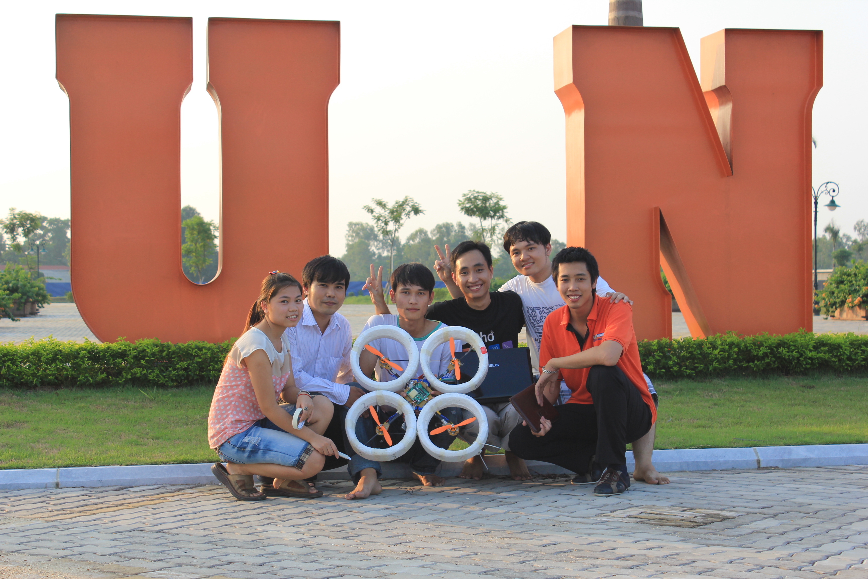
Anh/IMG_3743.JPG
