phong1990/fufo-innovation/Anh/IMG_3745.JPG

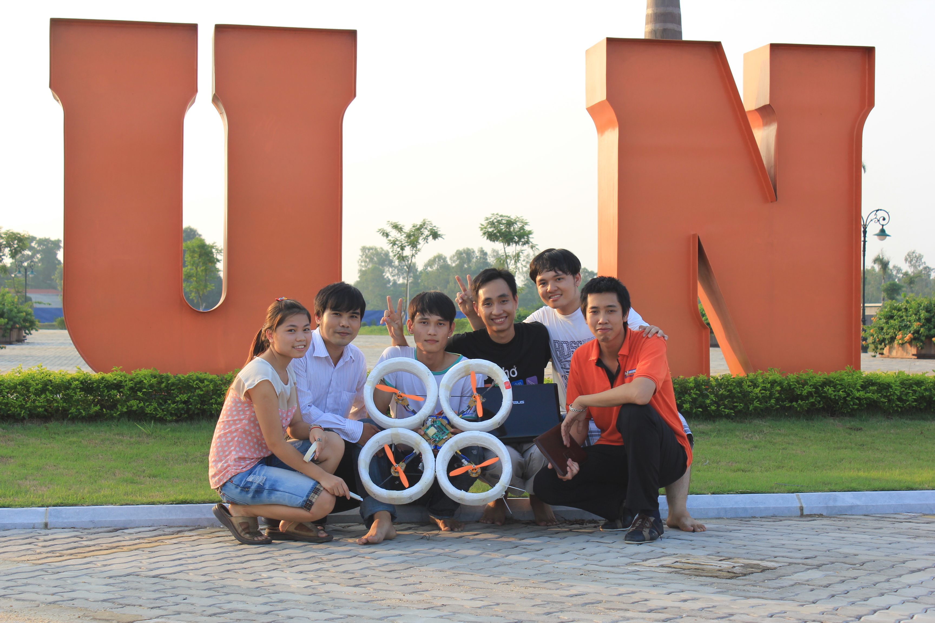
Anh/IMG_3745.JPG
