phong1990/fufo-innovation/Anh/IMG_3746.JPG

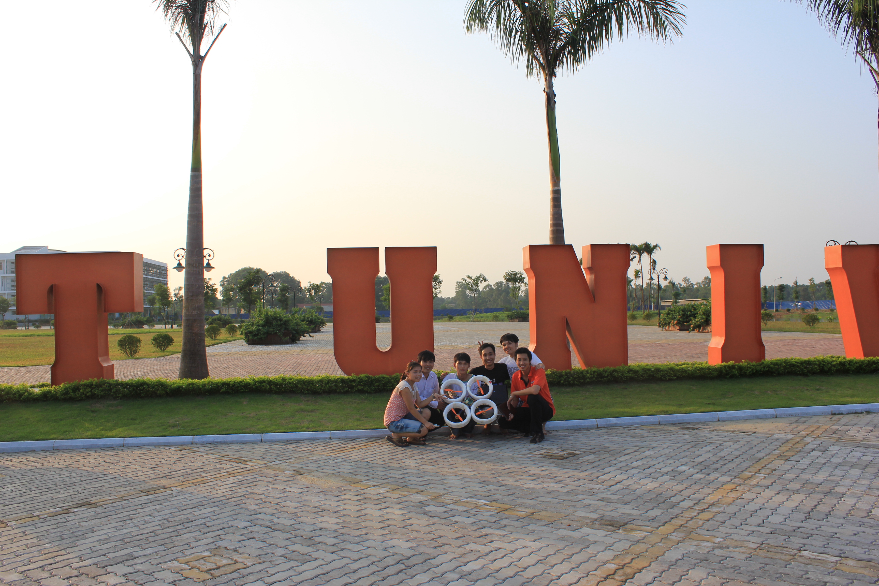
Anh/IMG_3746.JPG
