phong1990/fufo-innovation/Anh/IMG_3747.JPG

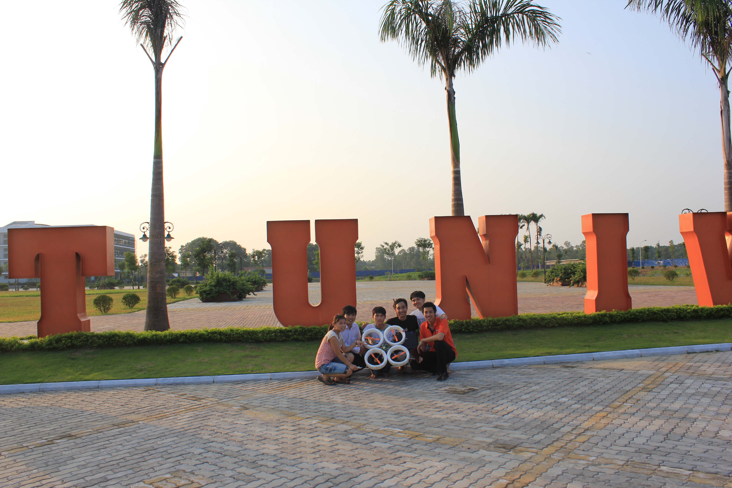
Anh/IMG_3747.JPG
