phong1990/fufo-innovation/Anh/IMG_3753.JPG

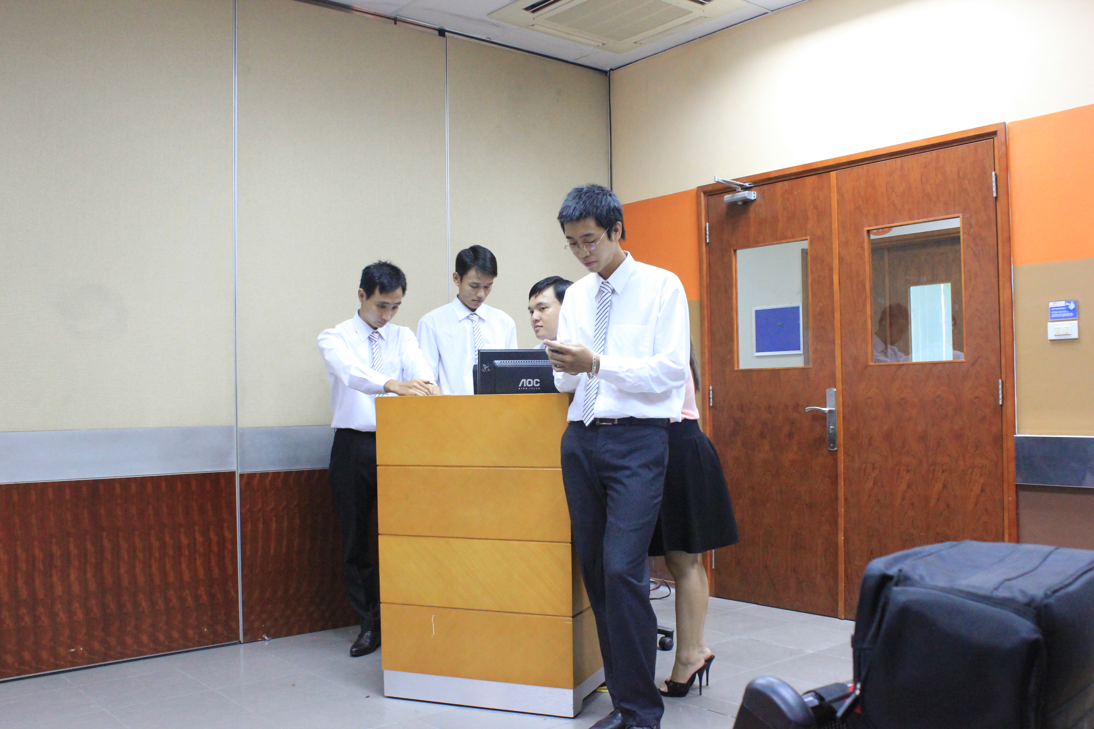
Anh/IMG_3753.JPG
