phong1990/fufo-innovation/Anh/IMG_3754.JPG

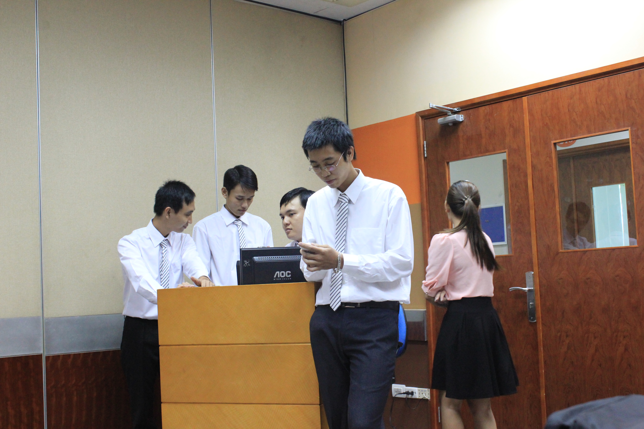
Anh/IMG_3754.JPG
