phong1990/fufo-innovation/Anh/IMG_3755.JPG

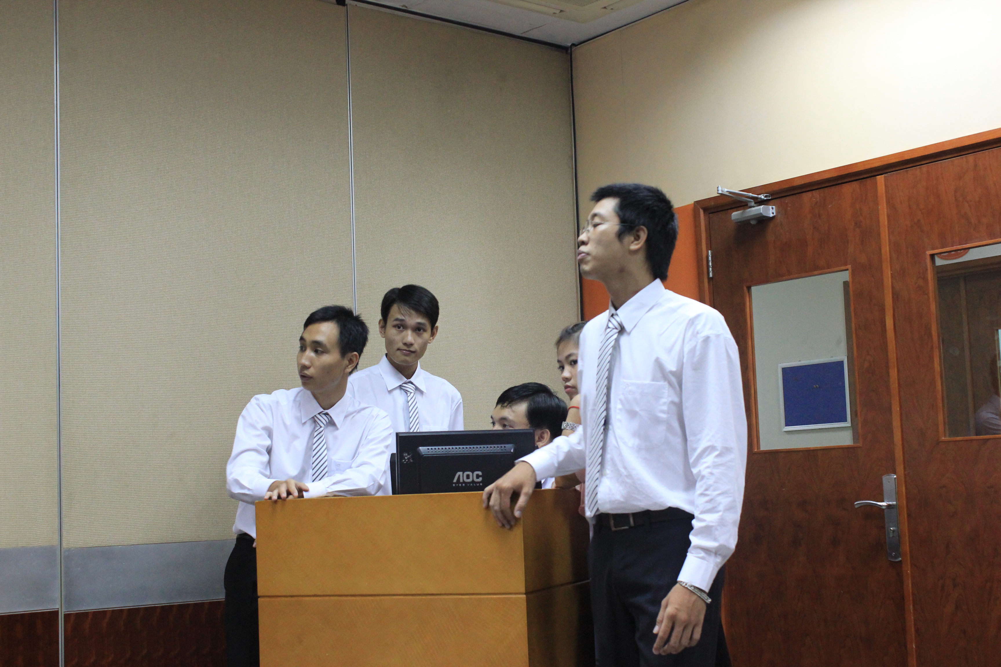
Anh/IMG_3755.JPG
