phong1990/fufo-innovation/Anh/IMG_3756.JPG

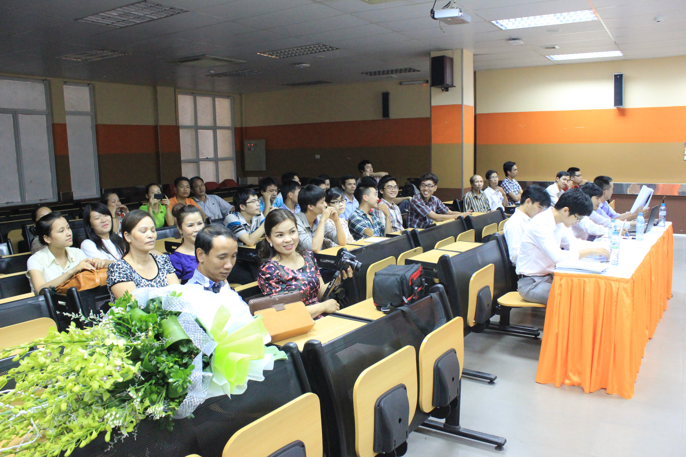
Anh/IMG_3756.JPG
