phong1990/fufo-innovation/Anh/IMG_3757.JPG

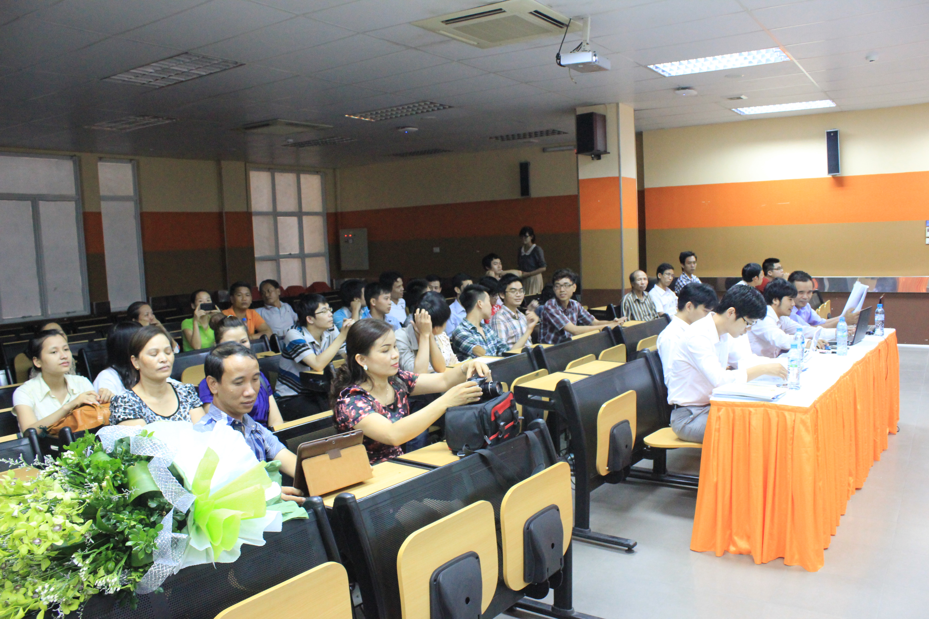
Anh/IMG_3757.JPG
