phong1990/fufo-innovation/Anh/IMG_3758.JPG

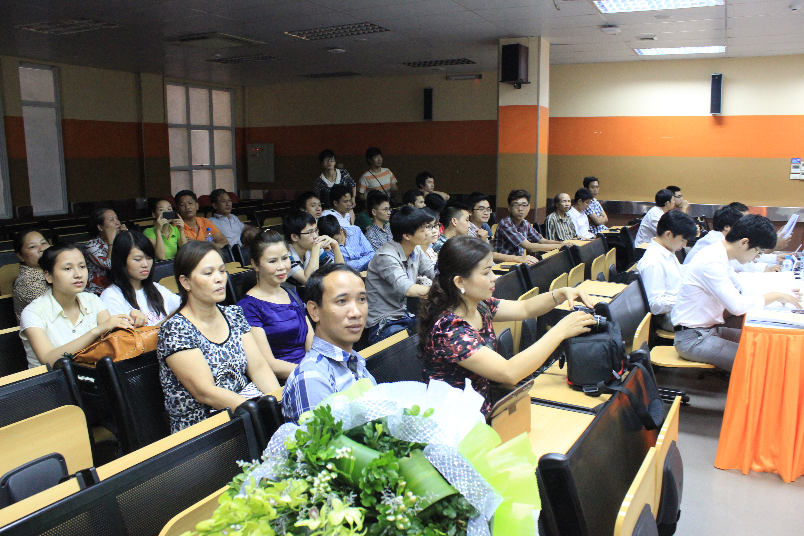
Anh/IMG_3758.JPG
