phong1990/fufo-innovation/Anh/IMG_3759.JPG

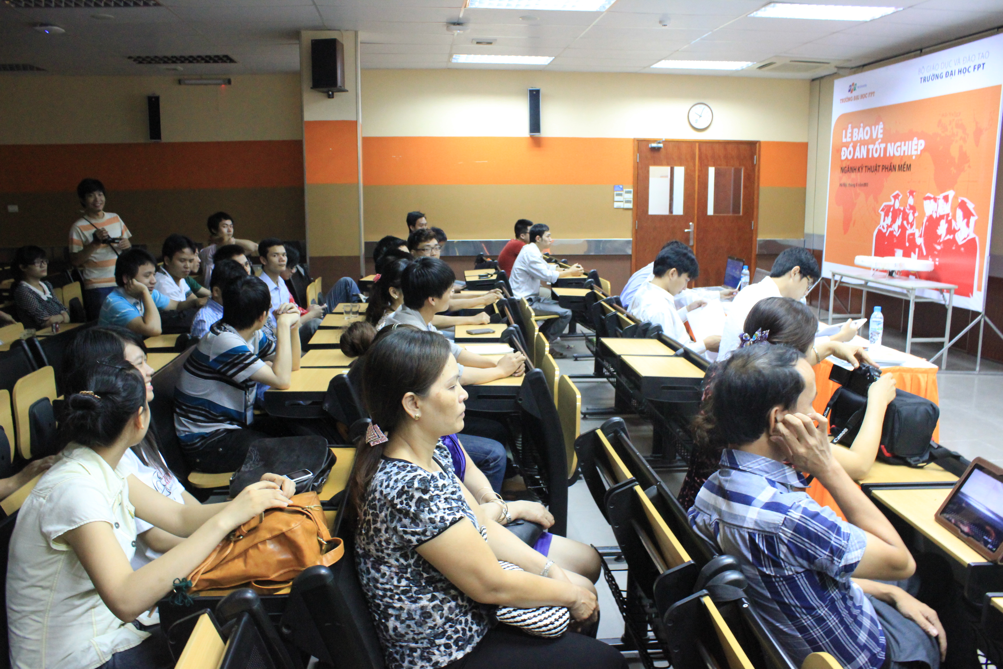
Anh/IMG_3759.JPG
