phong1990/fufo-innovation/Anh/IMG_3760.JPG

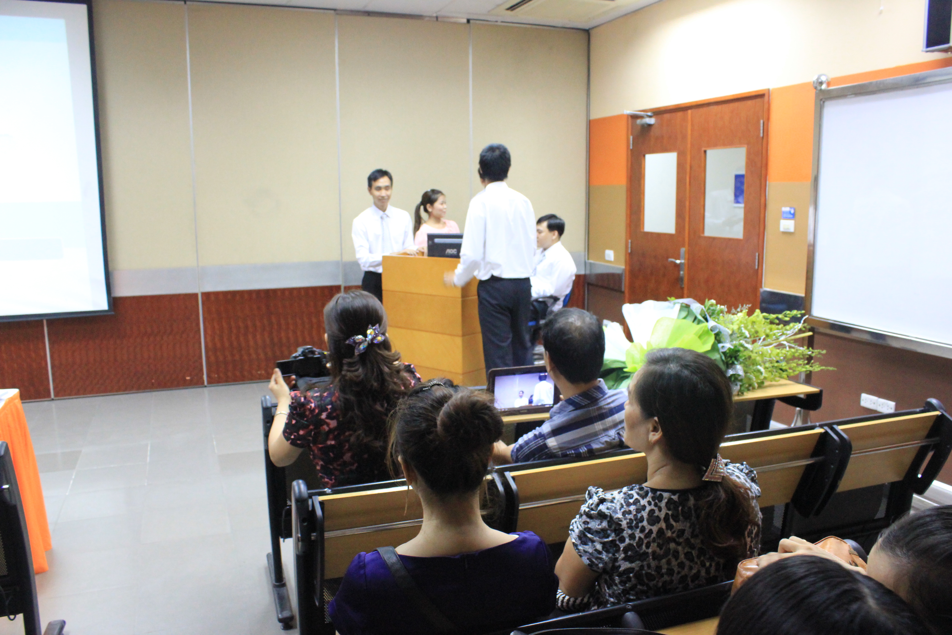
Anh/IMG_3760.JPG
