phong1990/fufo-innovation/Anh/IMG_3761.JPG

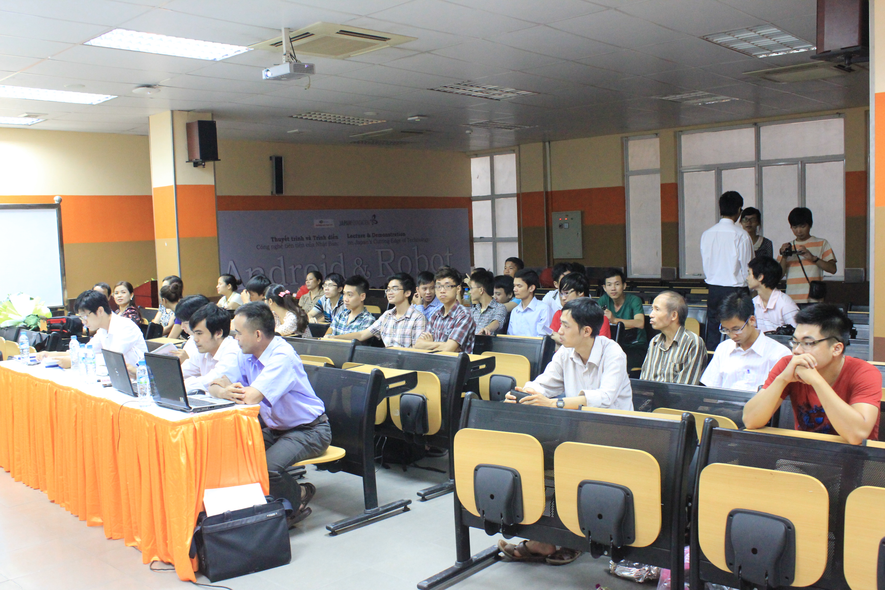
Anh/IMG_3761.JPG
