phong1990/fufo-innovation/Anh/IMG_3762.JPG

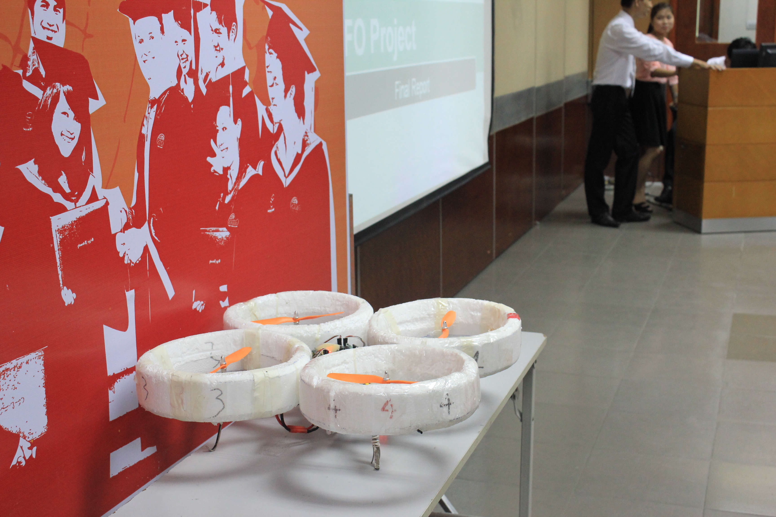
Anh/IMG_3762.JPG
