phong1990/fufo-innovation/Anh/IMG_3763.JPG

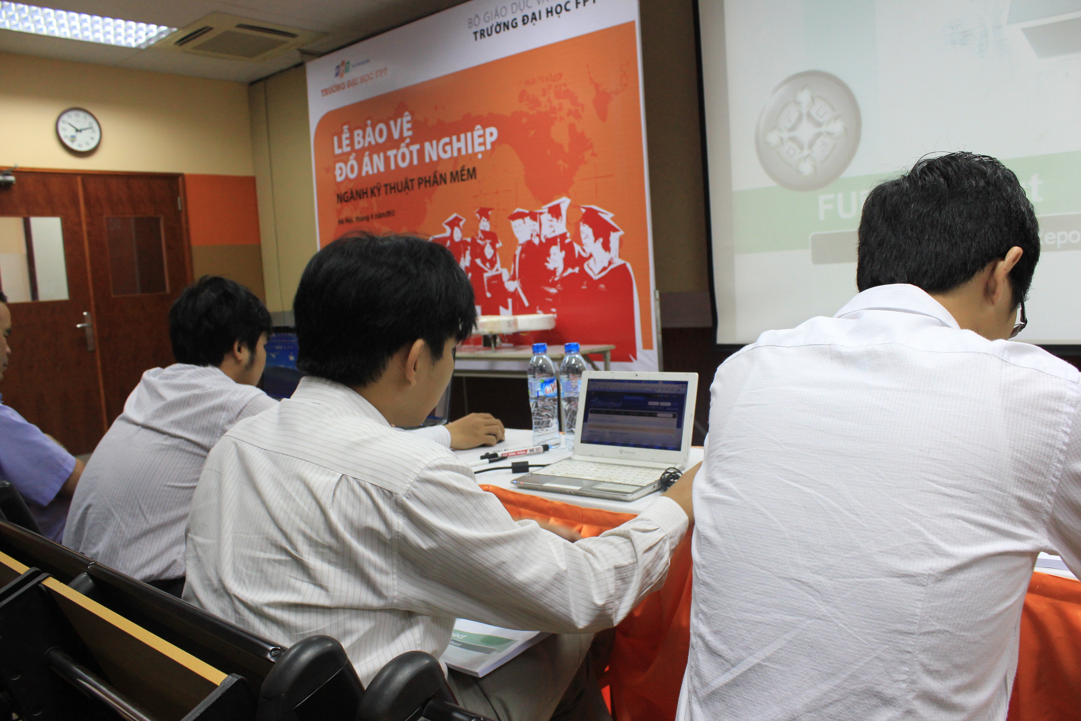
Anh/IMG_3763.JPG
