phong1990/fufo-innovation/Anh/IMG_3764.JPG

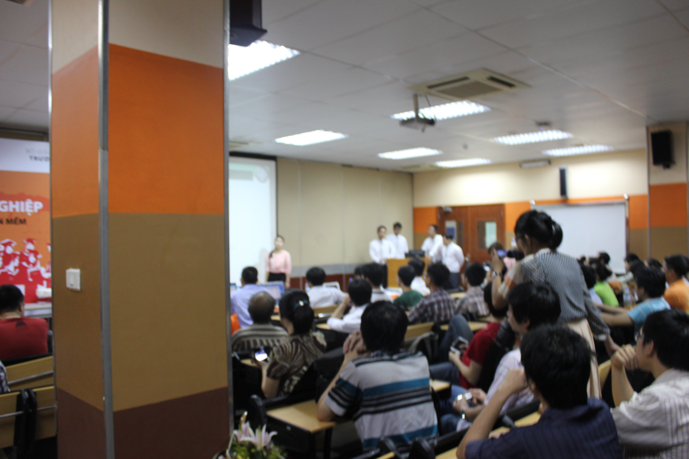
Anh/IMG_3764.JPG
