phong1990/fufo-innovation/Anh/IMG_3768.JPG

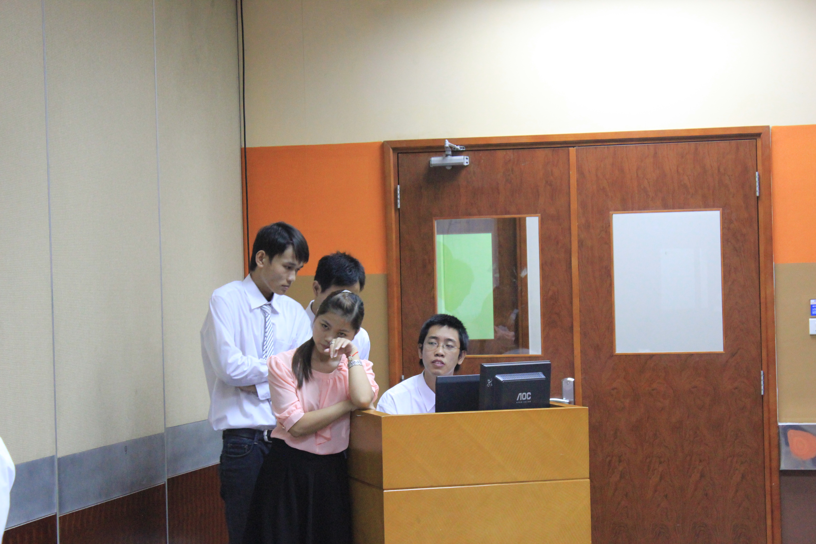
Anh/IMG_3768.JPG
