phong1990/fufo-innovation/Anh/IMG_3769.JPG

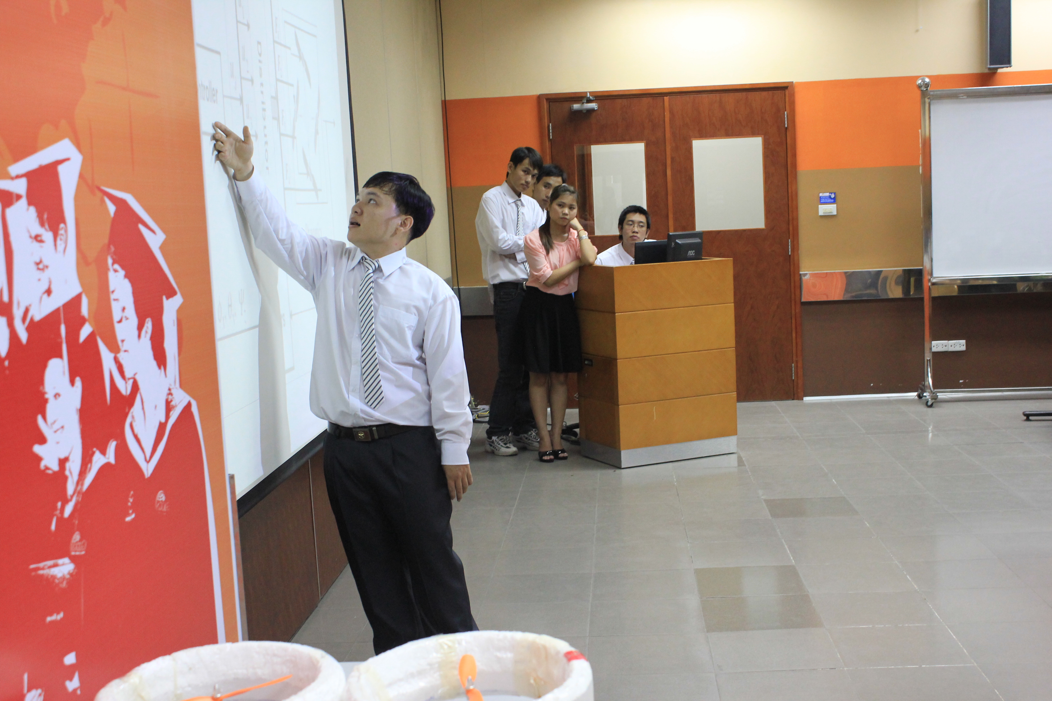
Anh/IMG_3769.JPG
