phong1990/fufo-innovation/Anh/IMG_3770.JPG

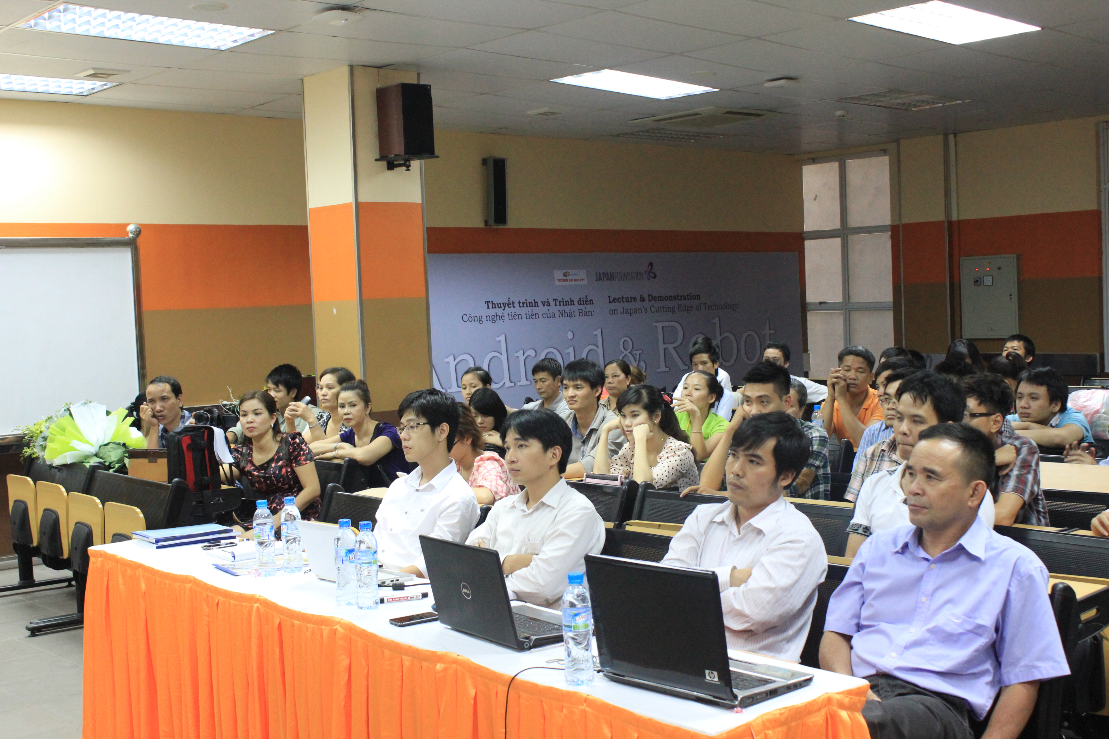
Anh/IMG_3770.JPG
