phong1990/fufo-innovation/Anh/IMG_3771.JPG

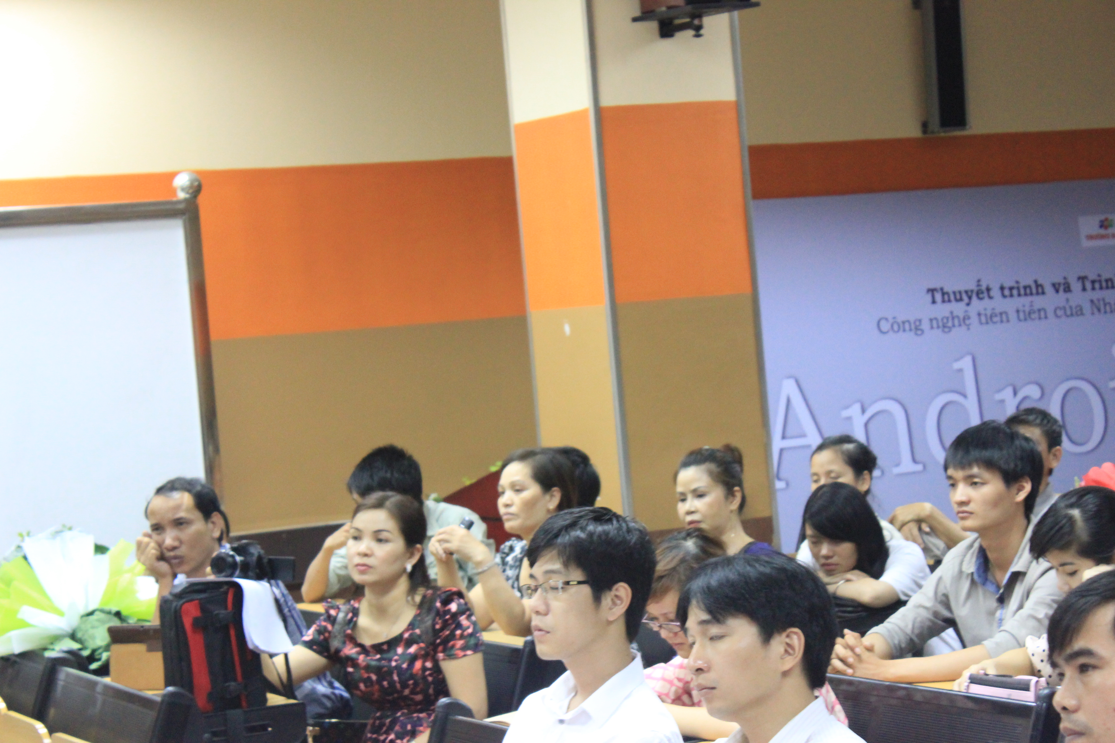
Anh/IMG_3771.JPG
