phong1990/fufo-innovation/Anh/IMG_3772.JPG

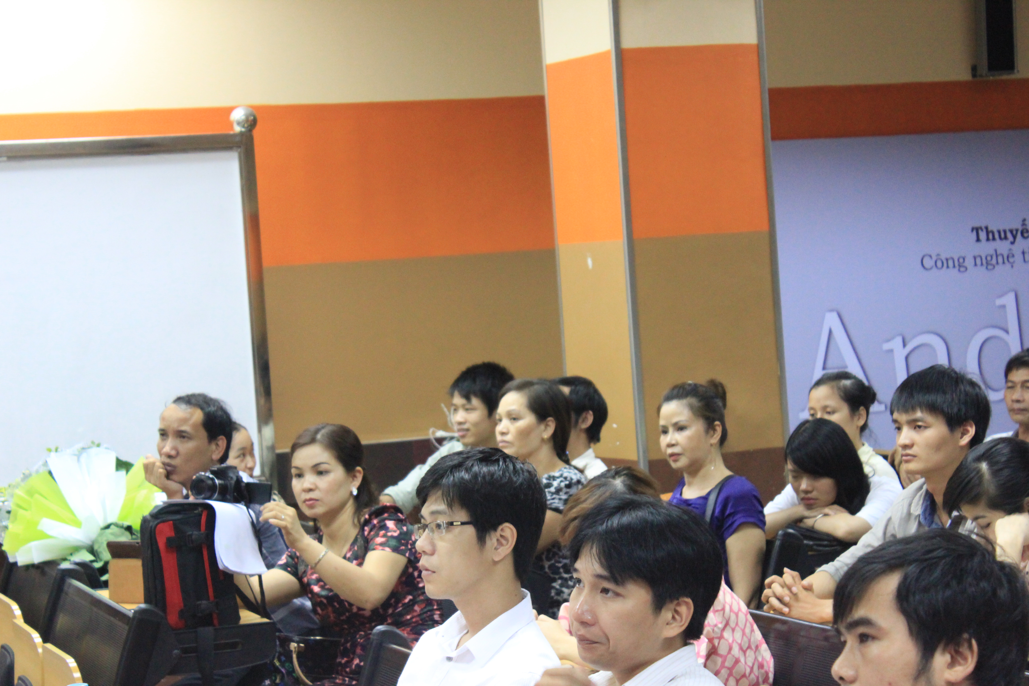
Anh/IMG_3772.JPG
