phong1990/fufo-innovation/Anh/IMG_3773.JPG

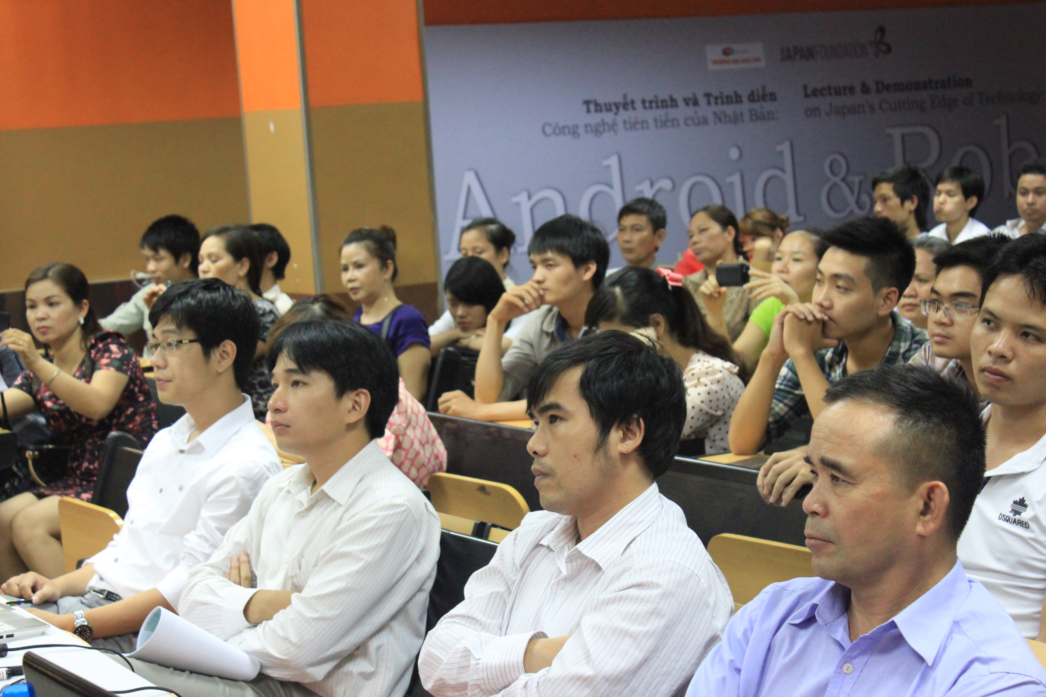
Anh/IMG_3773.JPG
