phong1990/fufo-innovation/Anh/IMG_3774.JPG

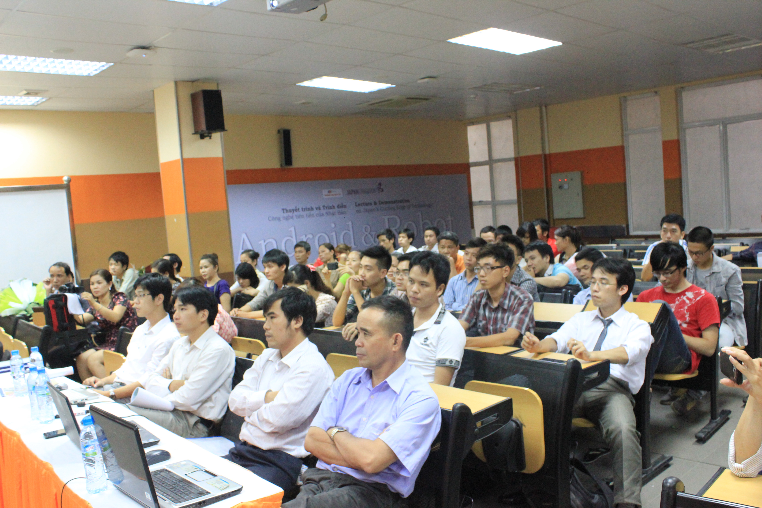
Anh/IMG_3774.JPG
