phong1990/fufo-innovation/Anh/IMG_3775.JPG

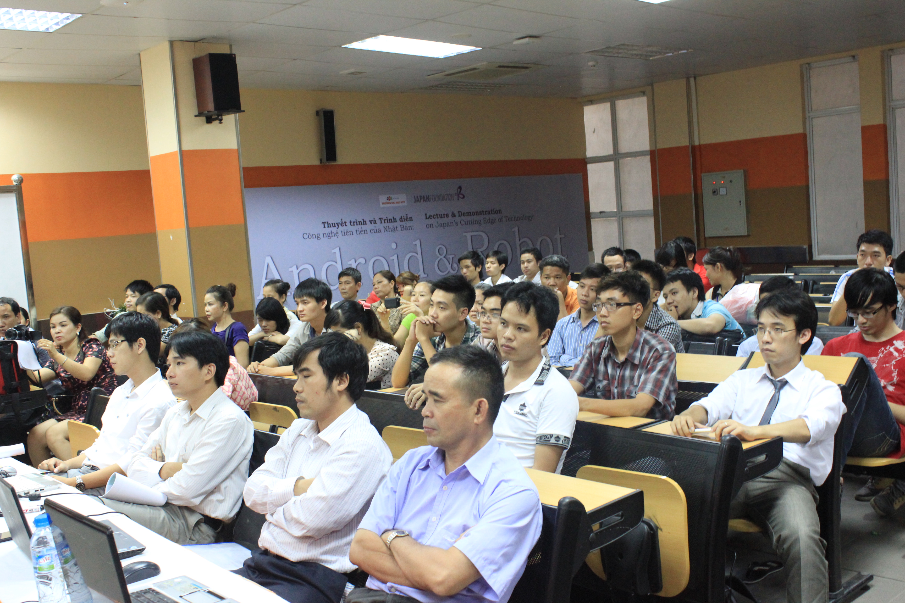
Anh/IMG_3775.JPG
