phong1990/fufo-innovation/Anh/IMG_3776.JPG

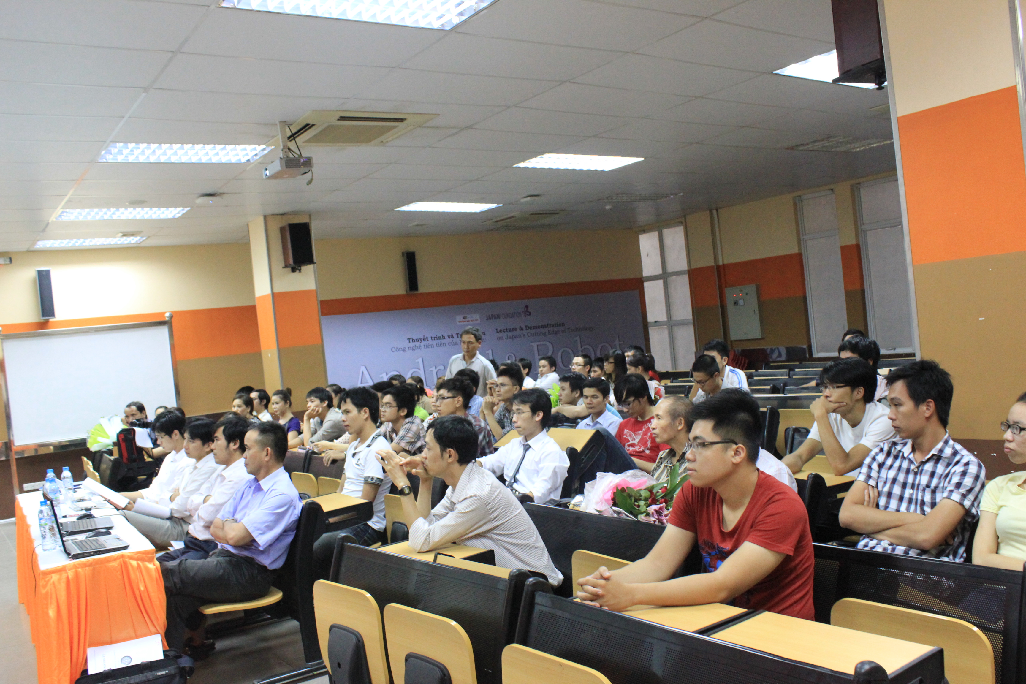
Anh/IMG_3776.JPG
