phong1990/fufo-innovation/Anh/IMG_3777.JPG

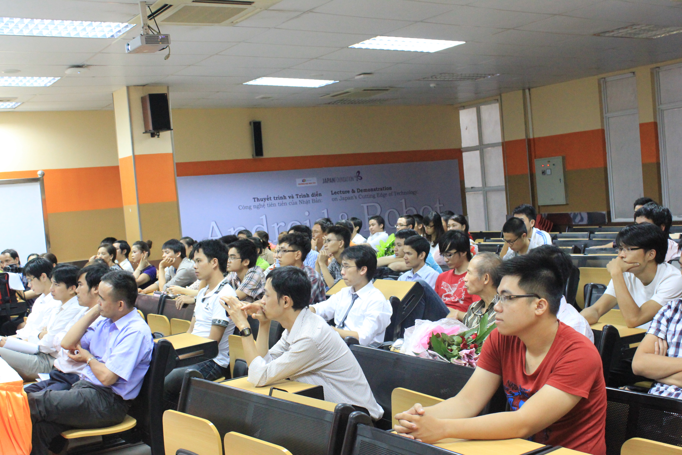
Anh/IMG_3777.JPG
