phong1990/fufo-innovation/Anh/IMG_3778.JPG

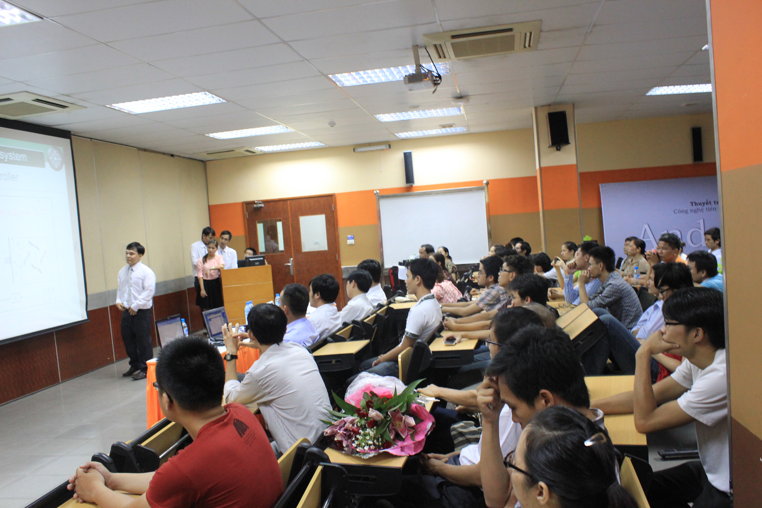
Anh/IMG_3778.JPG
