phong1990/fufo-innovation/Anh/IMG_3779.JPG

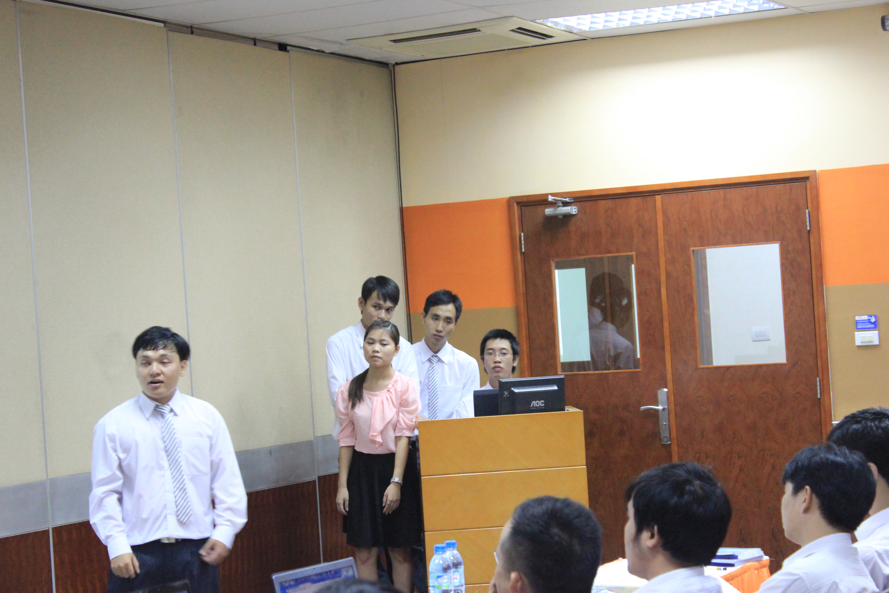
Anh/IMG_3779.JPG
