phong1990/fufo-innovation/Anh/IMG_3780.JPG

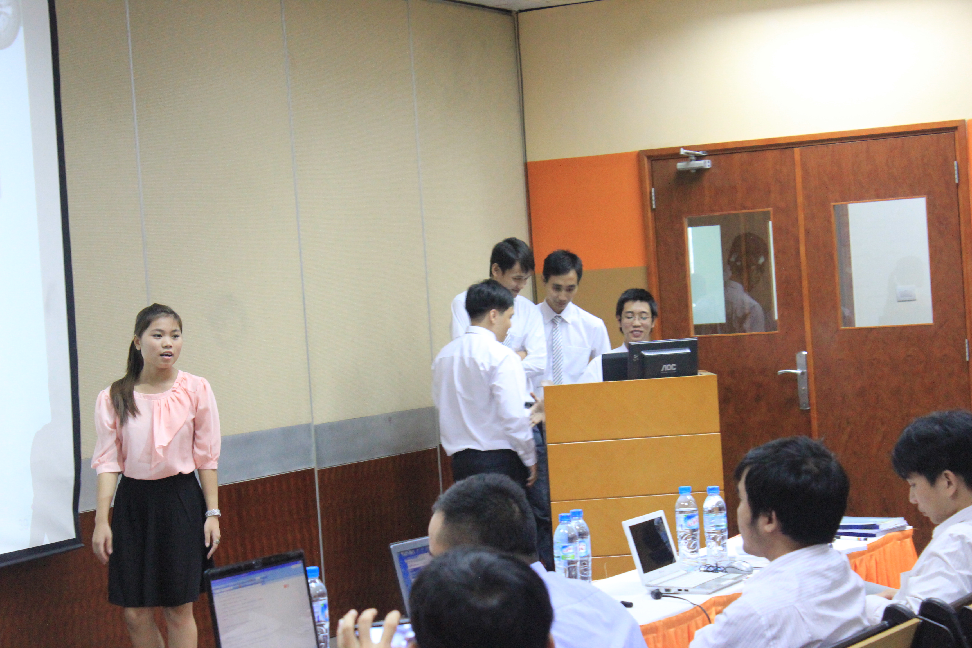
Anh/IMG_3780.JPG
