phong1990/fufo-innovation/Anh/IMG_3782.JPG

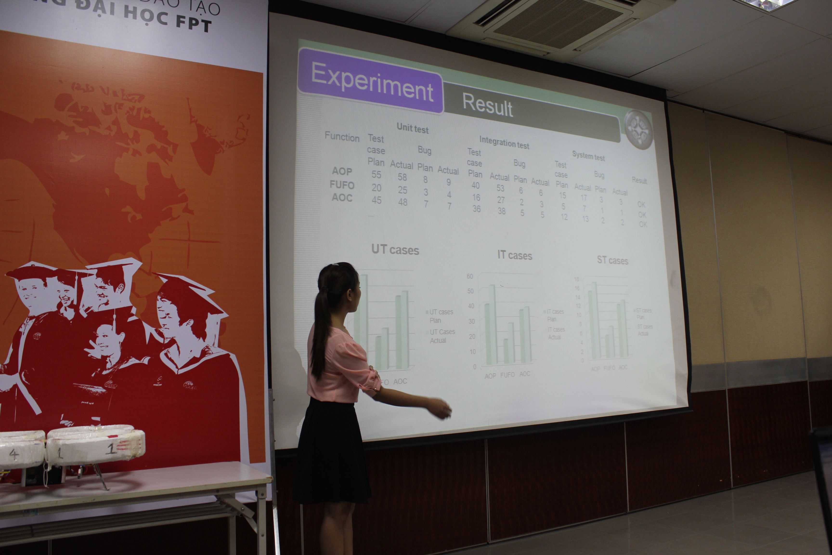
Anh/IMG_3782.JPG
