phong1990/fufo-innovation/Anh/IMG_3783.JPG

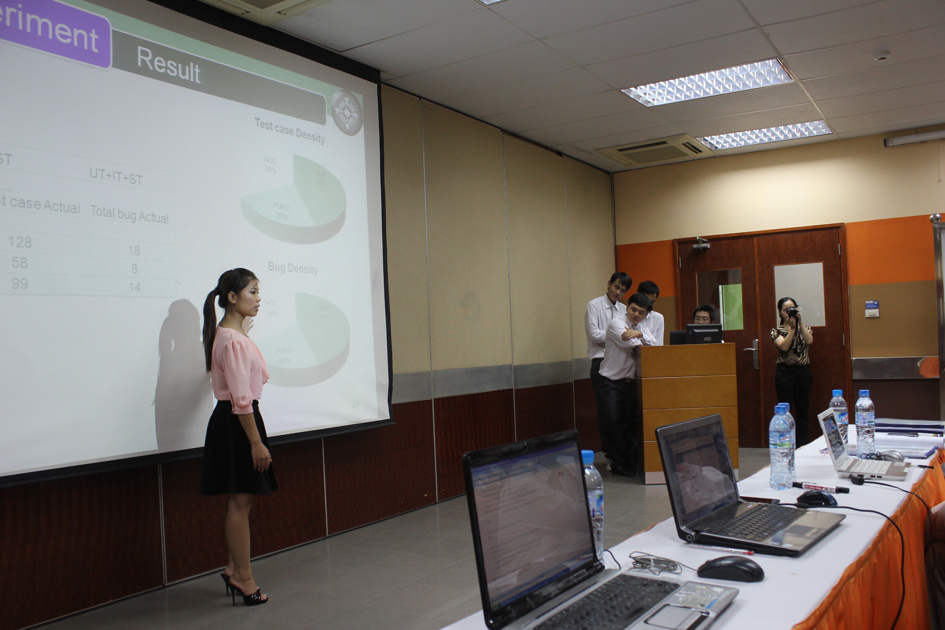
Anh/IMG_3783.JPG
