phong1990/fufo-innovation/Anh/IMG_3784.JPG

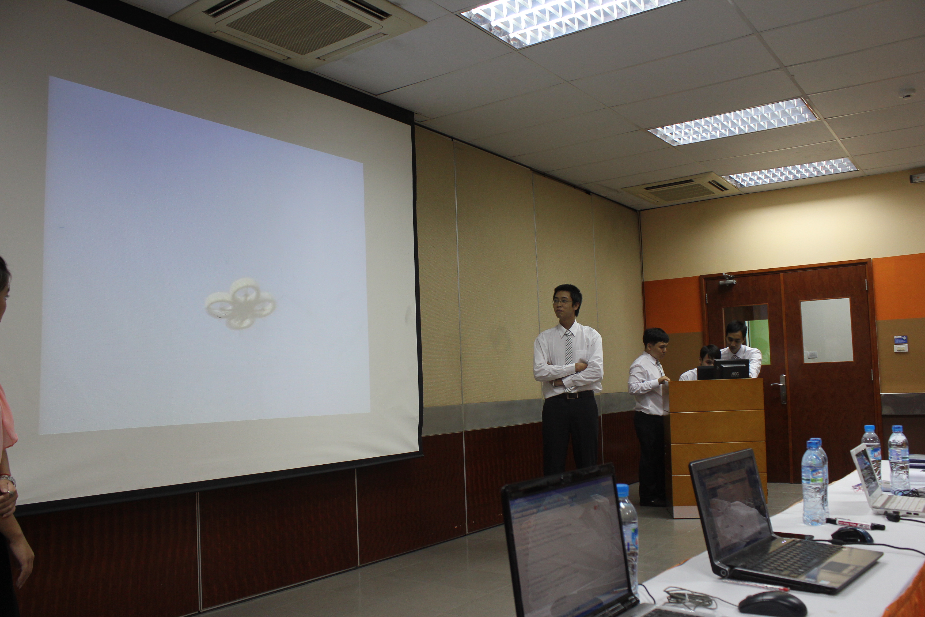
Anh/IMG_3784.JPG
