phong1990/fufo-innovation/Anh/IMG_3785.JPG

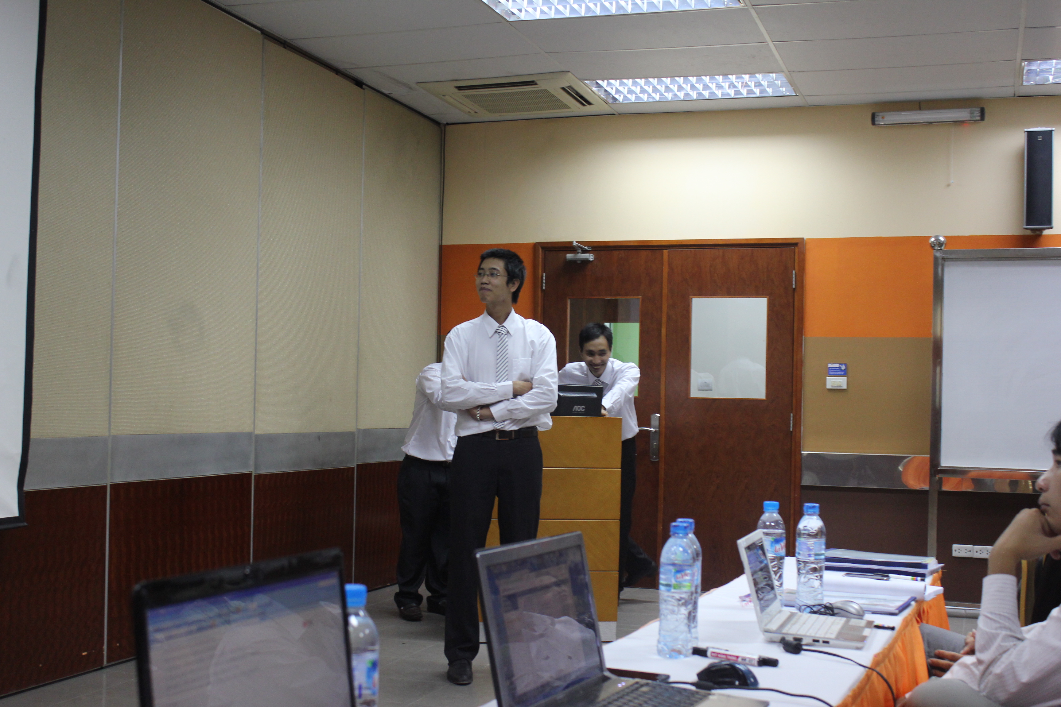
Anh/IMG_3785.JPG
