phong1990/fufo-innovation/Anh/IMG_3786.JPG

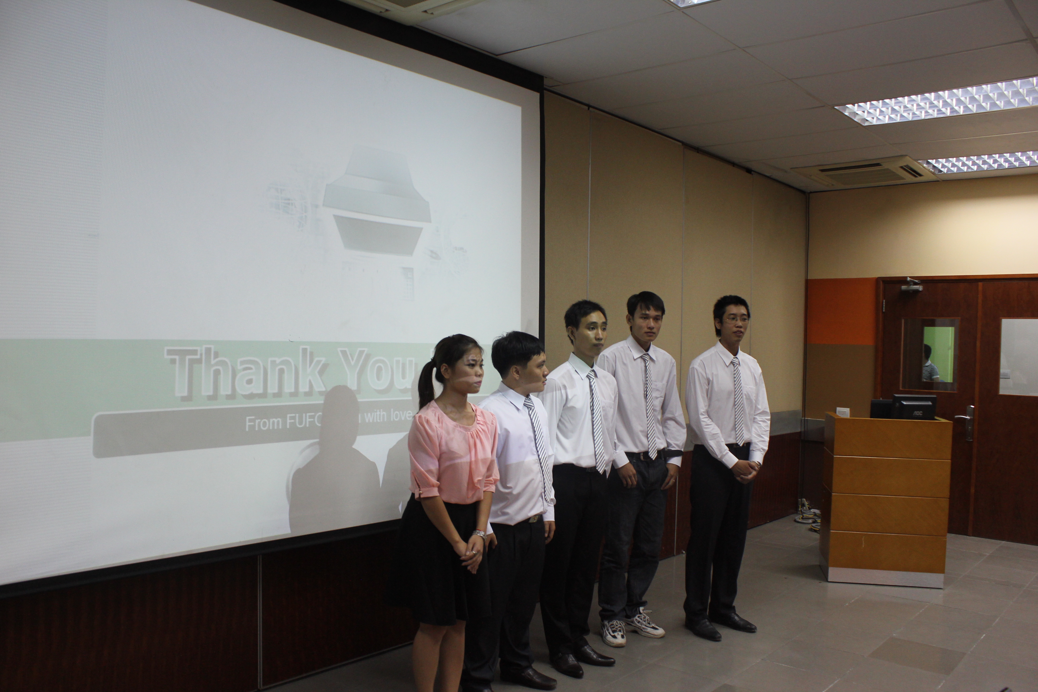
Anh/IMG_3786.JPG
