phong1990/fufo-innovation/Anh/IMG_3787.JPG

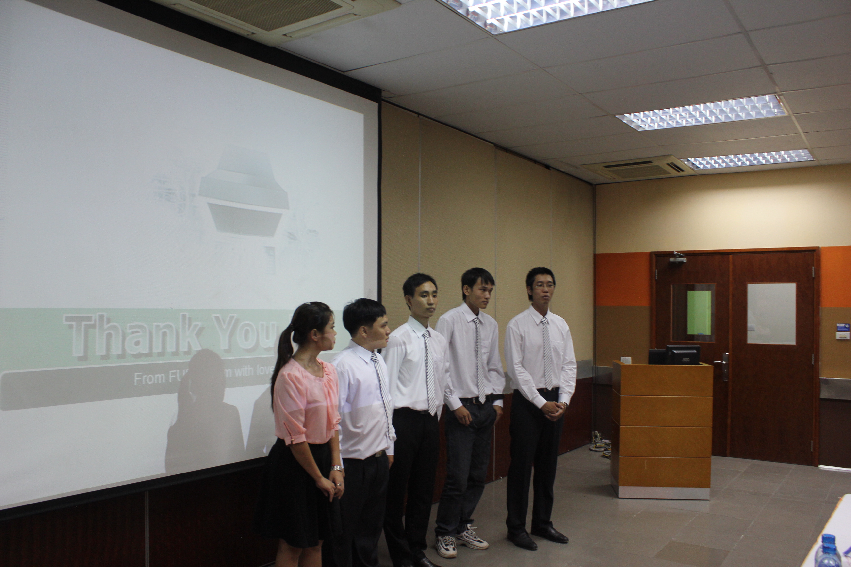
Anh/IMG_3787.JPG
