phong1990/fufo-innovation/Anh/IMG_3788.JPG

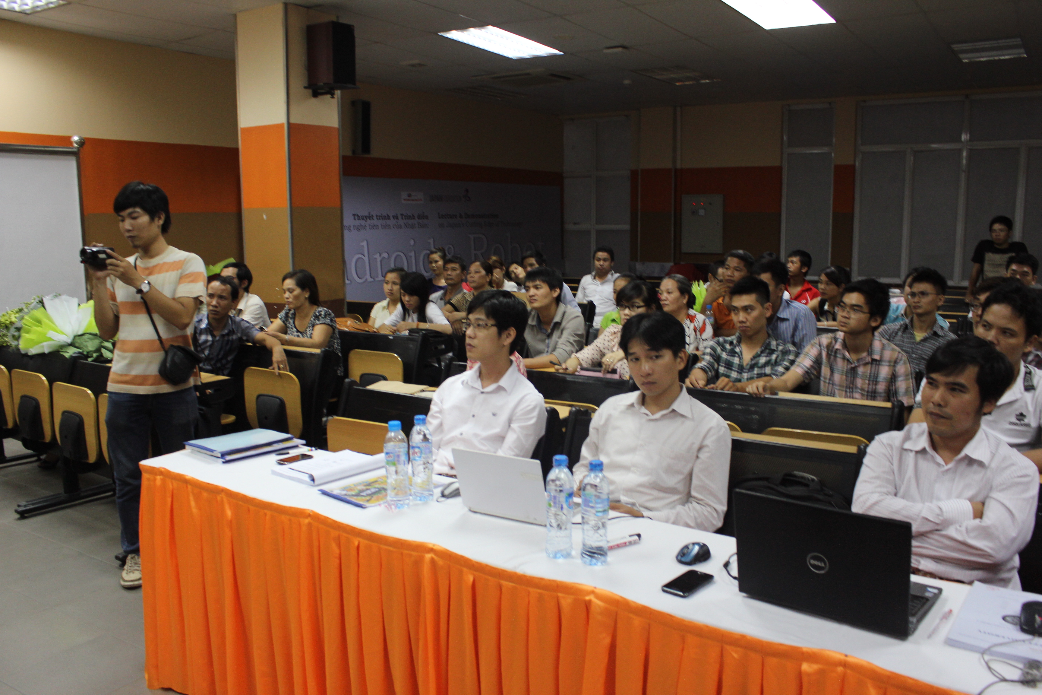
Anh/IMG_3788.JPG
