phong1990/fufo-innovation/Anh/IMG_3789.JPG

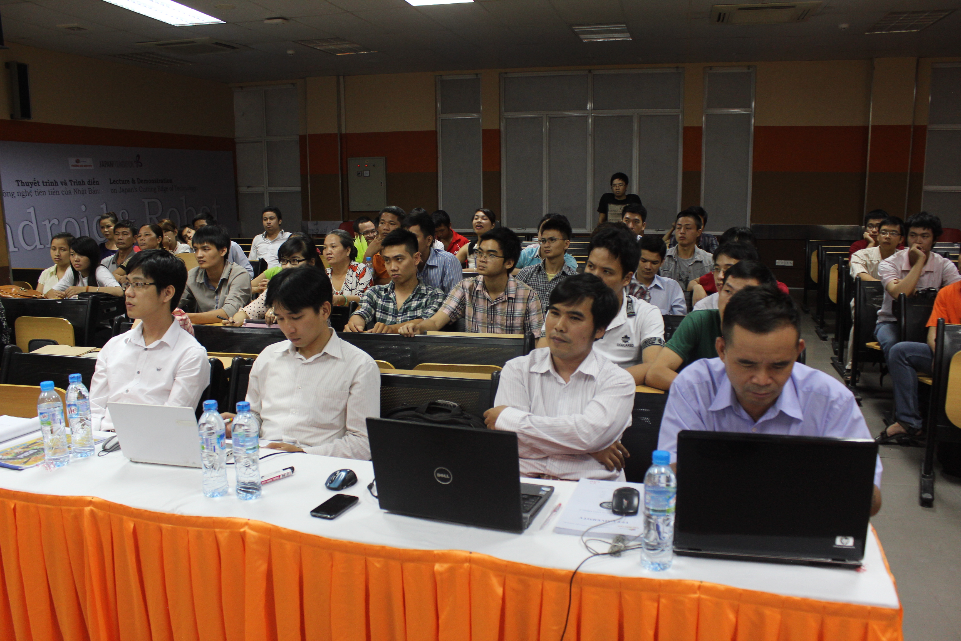
Anh/IMG_3789.JPG
