phong1990/fufo-innovation/Anh/IMG_3790.JPG

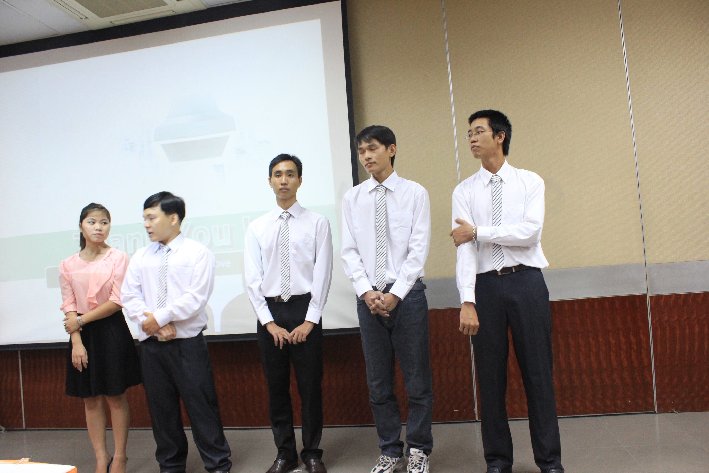
Anh/IMG_3790.JPG
