phong1990/fufo-innovation/Anh/IMG_20120629_190902.jpg

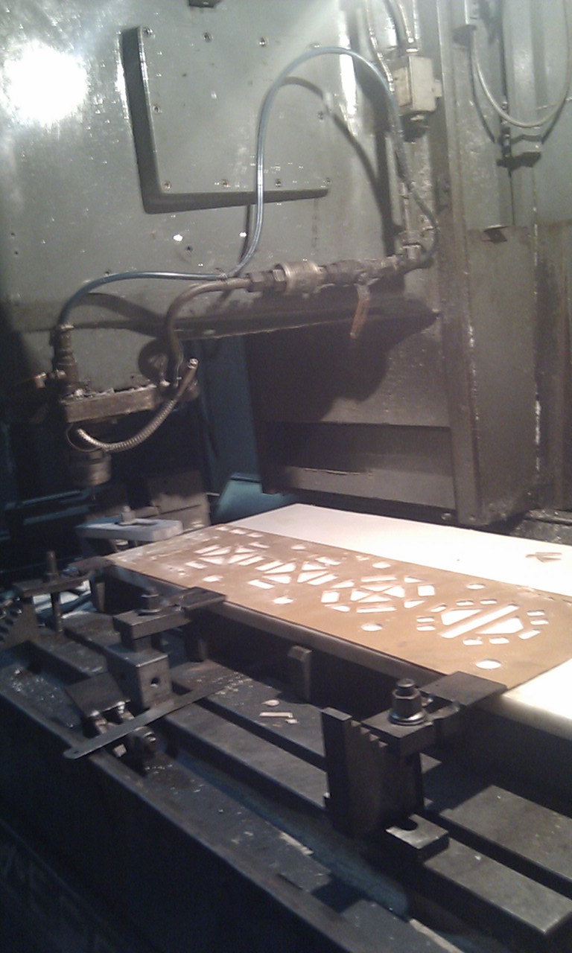
Anh/IMG_20120629_190902.jpg
