phong1990/fufo-innovation/Anh/ngon.JPG

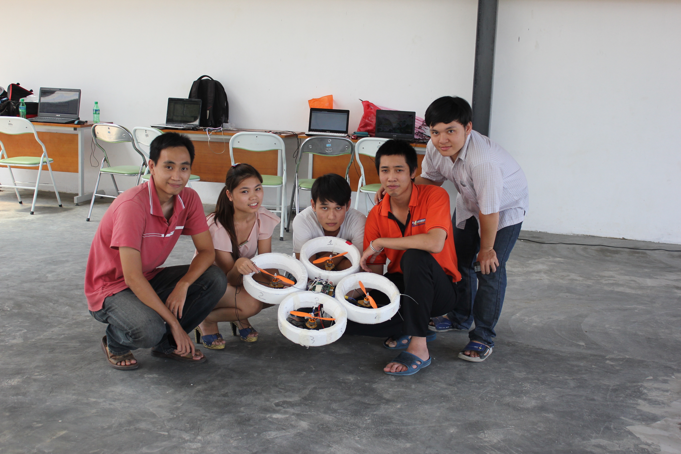
Anh/ngon.JPG
