phong1990/fufo-innovation/Document/04.Design/FUFO_FUFO/01.Software/FUFO_Controller_System.bmp

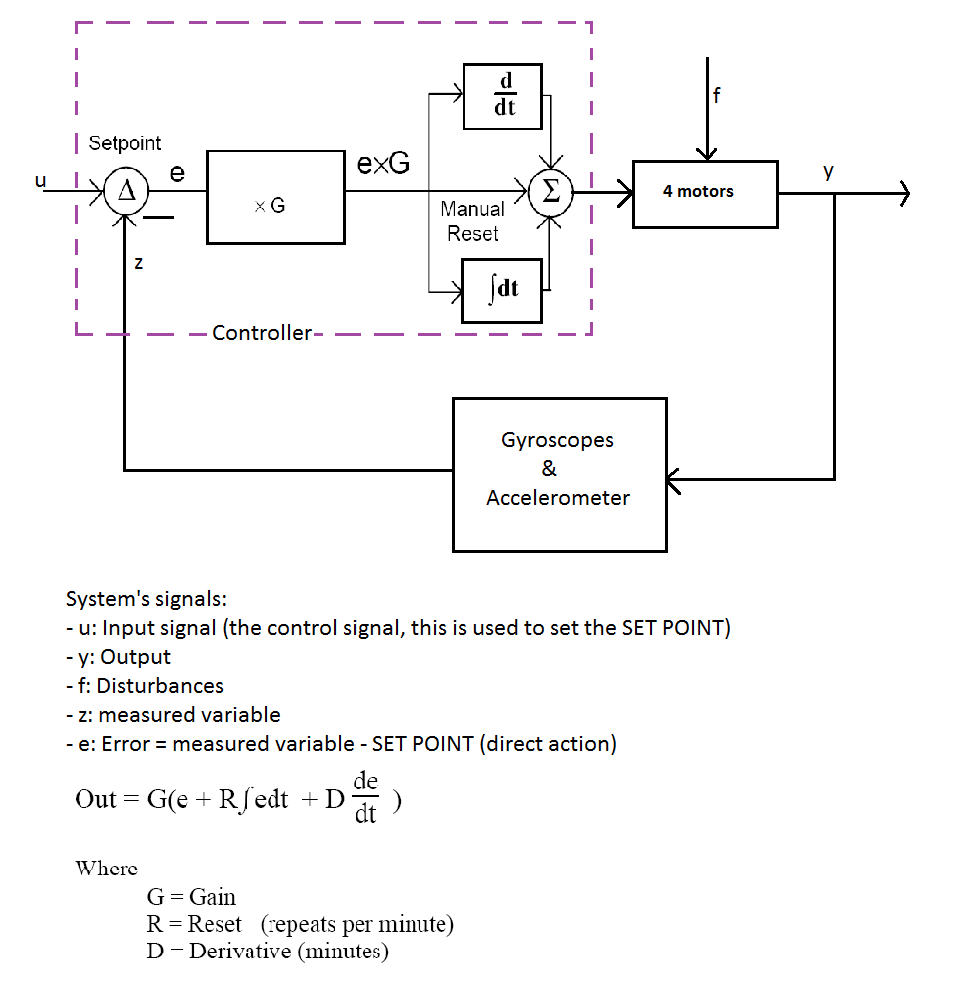
Document/04.Design/FUFO_FUFO/01.Software/FUFO_Controller_System.bmp
