phong1990/fufo-innovation/Document/04.Design/FUFO_VP/Interface/PNG/DEMO_Interface.png

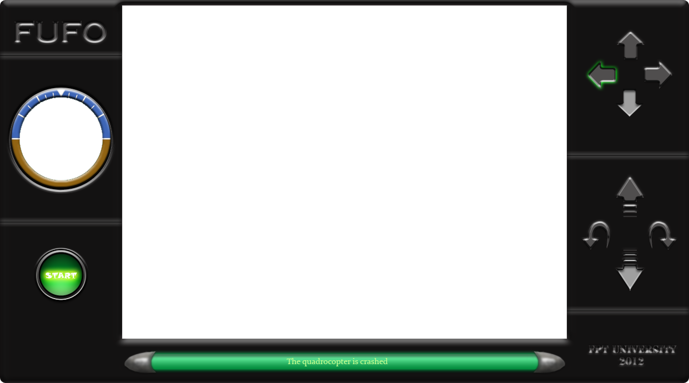
Document/04.Design/FUFO_VP/Interface/PNG/DEMO_Interface.png
