phong1990/fufo-innovation/Document/04.Design/FUFO_VP/screenshot_2012-08-13_1109.png

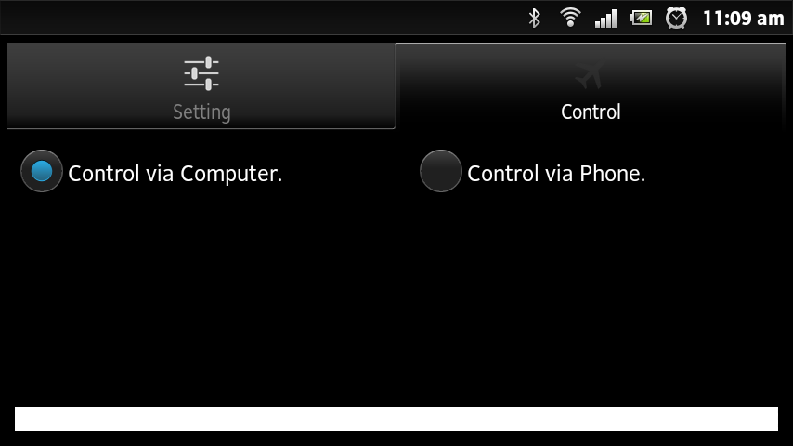
Document/04.Design/FUFO_VP/screenshot_2012-08-13_1109.png
