phong1990/fufo-innovation/Other/01.Datasheet/latex_greek_alphabet.jpg

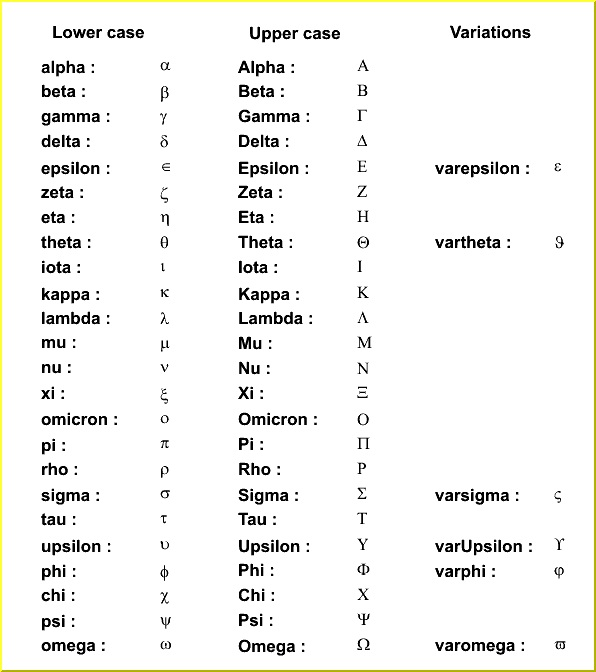
Other/01.Datasheet/latex_greek_alphabet.jpg
