phong1990/fufo-innovation/Document/00.Other/FUFO_TestCase_Final_Update.xls

Sheet: Cover
 | TEST CASE
Project Name | FPT Unidentify Flying Object |  |  | Creator | TRAN THI YEN
Project Code | FUFO- V 1.0 |  |  | Reviewer/Approver | VU MINH PHONG
Document Code | FUFO- V 1.0_TC_v1.0 |  |  | Issue Date | 2012-08-09
 |  |  |  | Version | V 1.0
Record of change
Effective Date | Version | Change Item | *A,D,M | Change description | Reference
2012-07-22 | v 0.1 | Create newly testcase | *A | Create testcase for FUFO frame
2012-07-29 | v 0.2 | Connection bluetooth | M | Update test case for the connection via phone
2012-08-02 | v 0.3 | Screen control | M | Update screen control on computer
2012-08-07 | v 0.4 | Screen control | M | Update screen control on phone
2012-08-08 | v 1.0 | Barometric function | M | Update the measurement of altitude

Sheet: VP
Module Code | VP
Test requirement | Test operation of AOC and AOP
Tester | Tran Thi Yen
Pass | NG | Untested | N/A | Number of Test cases
70 | 0 | 0 | 0 | 70
ID | Test Case Description | Test Case Procedure | Expected Output | Inter-test case Dependence | Result | Test date | Reference
 | AOP
[AOP 1] | Test viewing "AOP" form. | Turn on App's icon on smart phone | - If bluetooth of smart phone turn off: The AOP's view form is displayed with the folowing informations: "An app wants to turn ton Bluetooth. Allow?" - If bluetooth on smart phone turn: The AOP's view form is dislayed defaul screen: "Setting-Form" | The software must start-up successfully | Pass | 2012-08-03 | Setting-Form
[AOP 2] | Test "SETTING" form | 1. Turn on App's icon on smart phone 2. Choosing tab "Setting" | Main screen is displayed with the following information: - Server Setting : * IP server: available - FUFO Setting: * Bluetooth address - Status: "Disconnected" | The software must start-up successfully | Pass | 2012-08-03 | Setting-Form
[AOP 3] | Test connecting Bluetooth | - Click button "Connect" on FUFO Setting | - If successful, message will be shown: "Connected" - If unsucceful, message will be shown: "Disconnected" - Server Setting is still availble | The software must start-up successfully | Pass | 2012-08-03
[AOP 4] | Test connecting Wi-Fi | - Click button "Connect" on Server Setting | - If successful, message will be shown: "Connected" - If unsucceful, message will be shown: "Disconnected" - FUFO Setting is still availble | The software must start-up successfully | Pass | 2012-08-03
[AOP 5] | Test "Control" form | 1. Turn on App's icon on smart phone 2. Choosing tab "Control" | The "Control" view form is displayed with the folowing informations: - Control via computer - Control via phone | The software must start-up successfully | Pass | 2012-08-04 | Control-Form
[AOP 6] | Test Control via phone | - Click radio button "Control via phone" | - Control system will be shown - All 8 buttons "right", "left", "frontward", "backward", "up", "down", "right-rotate", and "left-rotate" are available to control | The connection bluetooth must be successful | Pass | 2012-08-04
[AOP 7] | Test connecting Server & FUFO | -Click "Connect" on Server Setting - Click "Connect" on FUFO Setting | - "Setting-form" will displayed: "Connected" on also Server & FUFO setting | The computer must turn on Wi-Fi The phone must turn on Bluetooth | Pass | 2012-08-04
[AOP 8] | Test connecting Server & FUFO | -Click "Connect" on Server Setting - Click "Connect" on FUFO Setting - FUFO frame presses button Turn Off | - "Setting-form" will displayed: " Please check Bluetooth connection" | The computer must turn on Wi-Fi The phone must turn on Bluetooth | Pass | 2012-08-04
[AOP 9] | Test displaying video | On "SETTING": - Click "connect" to Servet - Click "connect" to FUFO On "CONTROL": - Click "Control via Computer" | Video stream will be displayed on main screen AOC | The computer must turn on Wi-Fi The phone must turn on Bluetooth Smartphone must have camera 240x320 | Pass | 2012-08-04
[AOP 10] | Test real-time video | Open log file : "send-receive video.log" after displaying 5 frames within 1 second | Log file recorded in 1 package - UDP's tranfering: 40s - Show on screen: 10s Lost package: 10~20 packages | The computer must turn on Wi-Fi The phone must turn on Bluetooth Smartphone must have camera 240x321 | Pass | 2012-08-04
[AOP 11] | Test control system: "Control via phone" | On tab "CONTROL": - Click "Control via phone" + Click button "Up" at the firt time | FUFO will helicopter within 1 meter successfully | Only phone connected to FUFO successfully | Pass | 2012-08-04
[AOP 12] | Test control system: "Control via phone" | On tab "CONTROL": - Click "Control via phone" + Click button "Frontward" | Following order: - FUFO frame go ahead | Only phone connected to FUFO successfully FUFO is correctly running on flying status | Pass | 2012-08-04
[AOP 13] | Test control system: "Control via phone" | On tab "CONTROL": - Click "Control via phone" + Click button "Backward" | Following order: - FUFO frame go back | Only phone connected to FUFO successfully FUFO is correctly running on flying status | Pass | 2012-08-04
[AOP 14] | Test control system: "Control via phone" | On tab "CONTROL": - Click "Control via phone" + Click button "Left" | Following order: - FUFO frame go to the left | Only phone connected to FUFO successfully FUFO is correctly running on flying status | Pass | 2012-08-04
[AOP 15] | Test control system: "Control via phone" | On tab "CONTROL": - Click "Control via phone" + Click button "Right" | Following order: - FUFO frame go to the right | Only phone connected to FUFO successfully FUFO is correctly running on flying status | Pass | 2012-08-07
[AOP 16] | Test control system: "Control via phone" | On tab "CONTROL": - Click "Control via phone" + Click button "Rotate-Left" | Following order: - FUFO frame will rotate to the left | Only phone connected to FUFO successfully FUFO is correctly running on flying status | Pass | 2012-08-07
[AOP 17] | Test control system: "Control via phone" | On tab "CONTROL": - Click "Control via phone" + Click button "Rotate-Right" | Following order: - FUFO frame will rotate to the right | Only phone connected to FUFO successfully FUFO is correctly running on flying status | Pass | 2012-08-07
[AOP 18] | Test control system: "Control via phone" | On tab "CONTROL": - Click "Control via phone" + Click button "UP" after the firt time | Following order: - FUFO frame go up continously | Only phone connected to FUFO successfully FUFO is correctly running on flying status | Pass | 2012-08-07
[AOP 19] | Test control system: "Control via phone" | On tab "CONTROL": - Click "Control via phone" + Click button "DOWN" | Following order: - FUFO frame go down | Only phone connected to FUFO successfully FUFO is correctly running on flying status | Pass | 2012-08-07
[AOP 20] | Test combination control | On tab "CONTROL": - Click "Control via phone" + Click two buttons: "Frontward" & "Backward" | Following order: - FUFO frame go ahead - FUFO frame go back | Only phone connected to FUFO successfully FUFO is correctly running on flying status | Pass | 2012-08-07
[AOP 21] | Test combination control | On tab "CONTROL": - Click "Control via phone" + Click two buttons: "Left" & "Right" | Following order: - FUFO frame go to the left - FUFO frame go to the right | Only phone connected to FUFO successfully FUFO is correctly running on flying status | Pass | 2012-08-07
[AOP 22] | Test combination control | On tab "CONTROL": - Click "Control via phone" + Click two buttons: "Rotate-Left" & "Rotate-Right" | Following order: - FUFO frame will rotate to the left - FUFO frame will rotate to the right | Only phone connected to FUFO successfully FUFO is correctly running on flying status | Pass | 2012-08-07
[AOP 23] | Test combination control | On tab "CONTROL": - Click "Control via phone" + Click two buttons: "UP" & "DOWN" | Following order: - FUFO frame go up - FUFO frame go down | Only phone connected to FUFO successfully FUFO is correctly running on flying status | Pass | 2012-08-07
[AOP 24] | Test combination control | On tab "CONTROL": - Click "Control via phone" + Click two buttons: "Frontward" & "Up" | Following order: - FUFO frame go ahead and go up | Only phone connected to FUFO successfully FUFO is correctly running on flying status | Pass | 2012-08-07
[AOP 25] | Test combination control | On tab "CONTROL": - Click "Control via phone" + Click two buttons: "Left" & "Left-Rotate" | Following order: - FUFO frame go to the left and rotate to the left | Only phone connected to FUFO successfully FUFO is correctly running on flying status | Pass | 2012-08-07
[AOP 26] | Test combination control | On tab "CONTROL": - Click "Control via phone" + Click two buttons: "Right" & "Rotate-Right" | Following order: - FUFO frame will rotate to the left and go to the right | Only phone connected to FUFO successfully FUFO is correctly running on flying status | Pass | 2012-08-07
[AOP 27] | Test combination control | On tab "CONTROL": - Click "Control via phone" + Click two buttons: "Backward" & "DOWN" | Following order: - FUFO frame go back and go down | Only phone connected to FUFO successfully FUFO is correctly running on flying status | Pass | 2012-08-07
[AOP 28] | Test combination control | On tab "CONTROL": - Click "Control via phone" + Click three buttons: "Left" + "Left-Rotate" & "Up" | Following order: - FUFO frame will turn left, rotate the left and then go up | Only phone connected to FUFO successfully FUFO is correctly running on flying status | Pass | 2012-08-07
[AOP-29] | Test combination control | On tab "CONTROL": - Click "Control via phone" + Click three buttons: "Right" + "Right-Rotate" & "Up" | Following order: - FUFO frame will turn right, rotate the right and then go up | Only phone connected to FUFO successfully FUFO is correctly running on flying status | Pass | 2012-08-07
[AOP-30] | Test combination control | On tab "CONTROL": - Click "Control via phone" + Click three buttons: "Left" + "Left-Rotate" & "Down" | Following order: - FUFO frame will turn left, rotate the left and then go down | Only phone connected to FUFO successfully FUFO is correctly running on flying status | Pass | 2012-08-07
[AOP-31] | Test combination control | On tab "CONTROL": - Click "Control via phone" + Click three buttons: "Right" + "Right-Rotate" & "Down" | Following order: - FUFO frame will turn right, rotate the right and then go down | Only phone connected to FUFO successfully FUFO is correctly running on flying status | Pass | 2012-08-07
[AOP-32] | Test combination control | On tab "CONTROL": - Click "Control via phone" + Click three buttons: "Left" + "Left-Rotate" & "Forward" | Following order: - FUFO frame will turn left, rotate the left and then go ahead | Only phone connected to FUFO successfully FUFO is correctly running on flying status | Pass | 2012-08-07
[AOP-33] | Test combination control | On tab "CONTROL": - Click "Control via phone" + Click three buttons: "Right" + "Right-Rotate" & "Forward" | Following order: - FUFO frame will turn right, rotate the right and then go ahead | Only phone connected to FUFO successfully FUFO is correctly running on flying status | Pass | 2012-08-07
[AOP-34] | Test combination control | On tab "CONTROL": - Click "Control via phone" + Click three buttons: "Left" + "Left-Rotate" & "Backward" | Following order: - FUFO frame will turn left, rotate the left and then go back | Only phone connected to FUFO successfully FUFO is correctly running on flying status | Pass | 2012-08-07
[AOP-35] | Test combination control | On tab "CONTROL": - Click "Control via phone" + Click three buttons: "Right" + "Right-Rotate" & "Backward" | Following order: - FUFO frame will turn right, rotate the right and then go back | Only phone connected to FUFO successfully FUFO is correctly running on flying status | Pass | 2012-08-07
[AOP-36] | Test control system: "Control via computer" | On tab "CONTROL": -Click "Control via computer" | AOC will show the video 800x600 on main screen | Both Phone connected to FUFO and computer connected to phone successfully FUFO is correctly running on flying status | Pass | 2012-08-07
[AOP-37] | Test connection bluetooth's message | On tab "CONTROL": - Click "Control via phone" | - If successful, AOP' s screen will show message: "Please check Bluetooth connection" - If unsuccessful, Control system which includes 8 buttons controlling will be displayed | Smart Phone turned on Bluetooth Not connect "FUFO Setting" | Pass | 2012-08-05
[AOP-38] | Test connection bluetooth's message | On tab "CONTROL": - Click "Control via computer" | - If successful, AOP' s screen will show message: "Please check Bluetooth connection" - If unsuccessful, Control system which includes 8 buttons controlling will be displayed | Smart Phone turned on Bluetooth Not connect "FUFO Setting" | Pass | 2012-08-05
[AOP-39] | Test connection bluetooth's message | On tab "CONTROL": - Click "Control via computer" | - If successful, AOP' s screen will show message: "Please check Bluetooth connection" - If unsuccessful, AOP will show "Control Form" | Smart Phone turned on Bluetooth Not connect "Server Setting" | Pass | 2012-08-05
[AOP-40] | Test connection bluetooth's message | Turn on App's icon on smart phone | - If successful, AOP' s screen will show message: "Please check Bluetooth connection" - If unsuccessful, AOP will show "Setting Form" | The software must start-up successfully Phone turned off Bluetooth | Pass | 2012-08-05
 | AOC
[AOC 1] | Test viewing interface | User connect to mobile: -Turn on App's icon | Main Screen will be shown as C-001 screen: - Functions of control system are disable | JAVA runtime environment installed | Pass | 2012-08-05 | Main screen
[AOC 2] | Test showing the inclination | - Inclinating FUFO frame from 28 degree to 30 degree | - The attitude indicator show 28~30 degrees | - Computer connected to FUFO via Wi-Fi | Pass | 2012-08-05
[AOC 3] | Test showing the altitude | - Put FUFO frame in place a meter above the ground | - The altitude ruler show 0.9~1.1 meters | - Computer connected to FUFO via Wi-Fi | Pass | 2012-08-05
[AOC 4] | Test control system on AOC's screen | On the control sytem of AOC + Click button "Frontward" + Click button "Backward" | Following order: - FUFO frame go ahead - FUFO frame go back | Both Phone connected to FUFO and computer connected to phone successfully | Pass | 2012-08-07
[AOC 5] | Test control system on AOC's screen | On the control sytem of AOC + Click button "Left" + Click button "Right" | Following order: - FUFO frame go to the left - FUFO frame go to the right | Both Phone connected to FUFO and computer connected to phone successfully | Pass | 2012-08-07
[AOC 6] | Test control system on AOC's screen | On the control sytem of AOC + Click button "Rotate-Left" + Click button "Rotate-Right" | Following order: - FUFO frame will rotate to the left - FUFO frame will rotate to the right | Both Phone connected to FUFO and computer connected to phone successfully | Pass | 2012-08-07
[AOC 7] | Test control system on AOC's screen | On the control sytem of AOC + Click button "UP" + Click button "DOWN" | Following order: - FUFO frame go up - FUFO frame go down | Both Phone connected to FUFO and computer connected to phone successfully | Pass | 2012-08-07
[AOC 8] | Test control system on AOC's screen | On the control sytem of AOC + Click button "Up" at the firt time | FUFO will helicopter within 1 meter successfully | Both Phone connected to FUFO and computer connected to phone successfully 'On tab "CONTROL": chosen"Control via phone" | Pass | 2012-08-07
[AOC 9] | Test control system on AOC's screen | On the AOC's screen: + Click button "Frontward" | Following order: - FUFO frame go ahead | Both Phone connected to FUFO and computer connected to phone successfully 'On tab "CONTROL": chosen"Control via phone" | Pass | 2012-08-07
[AOC 10] | Test control system on AOC's screen | On the AOC's screen: + Click button "Backward" | Following order: - FUFO frame go back | Both Phone connected to FUFO and computer connected to phone successfully 'On tab "CONTROL": chosen"Control via phone" | Pass | 2012-08-07
[AOC 11] | Test control system on AOC's screen | On the control sytem of AOC + Click button "Left" | Following order: - FUFO frame go to the left | Both Phone connected to FUFO and computer connected to phone successfully 'On tab "CONTROL": chosen"Control via phone" | Pass | 2012-08-07
[AOC 12] | Test control system on AOC's screen | On the control sytem of AOC + Click button "Right" | Following order: - FUFO frame go to the right | Both Phone connected to FUFO and computer connected to phone successfully 'On tab "CONTROL": chosen"Control via phone" | Pass | 2012-08-07
[AOC 13] | Test control system on AOC's screen | On the AOC's screen: + Click button "Rotate-Left" | Following order: - FUFO frame will rotate to the left | Both Phone connected to FUFO and computer connected to phone successfully 'On tab "CONTROL": chosen"Control via phone" | Pass | 2012-08-07
[AOC 14] | Test control system on AOC's screen | On the AOC's screen: + Click button "Rotate-Right" | Following order: - FUFO frame will rotate to the right | Both Phone connected to FUFO and computer connected to phone successfully 'On tab "CONTROL": chosen"Control via phone" | Pass | 2012-08-07
[AOC 15] | Test control system on AOC's screen | On the AOC's screen: + Click button "UP" after the firt time | Following order: - FUFO frame go up continously | Both Phone connected to FUFO and computer connected to phone successfully 'On tab "CONTROL": chosen"Control via phone" | Pass | 2012-08-07
[AOC 16] | Test control system on AOC's screen | On the AOC's screen: + Click button "DOWN" | Following order: - FUFO frame go down | Both Phone connected to FUFO and computer connected to phone successfully 'On tab "CONTROL": chosen"Control via phone" | Pass | 2012-08-07
[AOC 17] | Test combination on AOC's control | On tab "CONTROL": - Click "Control via phone" + Click two buttons: "Frontward" & "Up" | Following order: - FUFO frame go ahead and go up | Both Phone connected to FUFO and computer connected to phone successfully 'On tab "CONTROL": chosen"Control via phone" | Pass | 2012-08-07
[AOC 18] | Test combination on AOC's control | On the control sytem of AOC + Click two buttons: "Left" & "Left-Rotate" | Following order: - FUFO frame go to the left and rotate to the left | Both Phone connected to FUFO and computer connected to phone successfully 'On tab "CONTROL": chosen"Control via phone" | Pass | 2012-08-07
[AOC 19] | Test combination on AOC's control | On tab "CONTROL": - Click "Control via phone" + Click two buttons: "Right" & "Rotate-Right" | Following order: - FUFO frame will rotate to the left and go to the right | Both Phone connected to FUFO and computer connected to phone successfully 'On tab "CONTROL": chosen"Control via phone" | Pass | 2012-08-07
[AOC 20] | Test combination on AOC's control | On the control sytem of AOC + Click two buttons: "Backward" & "DOWN" | Following order: - FUFO frame go back - FUFO frame go down | Both Phone connected to FUFO and computer connected to phone successfully 'On tab "CONTROL": chosen"Control via phone" | Pass | 2012-08-07
[AOC 21] | Test combination on AOC's control | On the control sytem of AOC + Click three buttons: "Left" + "Left-Rotate" & "Up" | Following order: - FUFO frame will turn left, rotate the left and then go up | Both Phone connected to FUFO and computer connected to phone successfully 'On tab "CONTROL": chosen"Control via phone" | Pass | 2012-08-07
[AOC 22] | Test combination on AOC's control | On the control sytem of AOC + Click three buttons: "Right" + "Right-Rotate" & "Up" | Following order: - FUFO frame will turn right, rotate the right and then go up | Both Phone connected to FUFO and computer connected to phone successfully 'On tab "CONTROL": chosen"Control via phone" | Pass | 2012-08-07
[AOC 23] | Test combination on AOC's control | On the control sytem of AOC + Click three buttons: "Left" + "Left-Rotate" & "Down" | Following order: - FUFO frame will turn left, rotate the left and then go down | Both Phone connected to FUFO and computer connected to phone successfully 'On tab "CONTROL": chosen"Control via phone" | Pass | 2012-08-07
[AOC 24] | Test combination on AOC's control | On the control sytem of AOC + Click three buttons: "Right" + "Right-Rotate" & "Down" | Following order: - FUFO frame will turn right, rotate the right and then go down | Both Phone connected to FUFO and computer connected to phone successfully 'On tab "CONTROL": chosen"Control via phone" | Pass | 2012-08-07
[AOC 25] | Test combination on AOC's control | On the control sytem of AOC + Click three buttons: "Left" + "Left-Rotate" & "Forward" | Following order: - FUFO frame will turn left, rotate the left and then go ahead | Both Phone connected to FUFO and computer connected to phone successfully 'On tab "CONTROL": chosen"Control via phone" | Pass | 2012-08-07
[AOC 26] | Test combination on AOC's control | On the control sytem of AOC + Click three buttons: "Right" + "Right-Rotate" & "Forward" | Following order: - FUFO frame will turn right, rotate the right and then go ahead | Both Phone connected to FUFO and computer connected to phone successfully 'On tab "CONTROL": chosen"Control via phone" | Pass | 2012-08-07
[AOC 27] | Test combination on AOC's control | On the control sytem of AOC + Click three buttons: "Left" + "Left-Rotate" & "Backward" | Following order: - FUFO frame will turn left, rotate the left and then go back | Both Phone connected to FUFO and computer connected to phone successfully 'On tab "CONTROL": chosen"Control via phone" | Pass | 2012-08-07
[AOC 28] | Test combination on AOC's control | On the control sytem of AOC + Click three buttons: "Right" + "Right-Rotate" & "Backward" | Following order: - FUFO frame will turn right, rotate the right and then go back | Both Phone connected to FUFO and computer connected to phone successfully 'On tab "CONTROL": chosen"Control via phone" | Pass | 2012-08-07
[AOC 29] | Test connecting Server & FUFO | -Click "Connect" on Server Setting - Click "Connect" on FUFO Setting | - "Setting-form" will displayed: "Connected" on also Server & FUFO setting | The computer must turn on Wi-Fi The phone must turn on Bluetooth | Pass | 2012-08-07
[AOC 30] | Test connecting Server & FUFO | -Click "Connect" on Server Setting - Click "Connect" on FUFO Setting - FUFO frame presses button Turn Off | - "Setting-form" will displayed: " Please check Bluetooth connection" | The computer must turn on Wi-Fi The phone must turn on Bluetooth | Pass | 2012-08-07

Sheet: FUFO
Module Code | FUFO
Test requirement | Test modules: Bluetooth, Sensors, Motors and ESCs
Tester | Tran Thi Yen
Pass | NG | Untested | N/A | Number of Test cases
7 | 2 | 0 | 0 | 9
ID | Test Case Description | Test Case Procedure | Expected Output | Inter-test case Dependence | Result | Test date | Note
 | Bluetooth: Configuration bluetooth from mainboard by UART interface
[Blue-1] | Test the configuration bluetooth module | - Power On mainboard | - If successful, the LCD shows "OK" - If unsuccessful, it shows "FAIL" | The firmware must start-up successfully and LCD runs | Pass | 2012-08-02
[Blue-2] | Test setting AT mode | - Power On mainboard - Send a string: "AT" | - Setting successfully. LCD shows "OK" - Setting unsuccessfully. LCD shows "FAIL" | The firmware must start-up successfully and LCD runs | Pass | 2012-08-02
[Blue-3] | Test setting NAME | - Power On mainboard - Send a string: "AT+ NAMEFUFO" | - Setting successfully. LCD shows "OKFUFO" - Setting unsuccessfully. LCD shows "FAIL" | The firmware must start-up successfully and LCD runs | Pass | 2012-08-02
[Blue-4] | Test setting PIN code | - Power On mainboard - Send a string: "AT+PIN1905" | - Setting successfully. LCD shows "OK1905" - Setting unsuccessfully. LCD shows "FAIL" | The firmware must start-up successfully and LCD runs | Pass | 2012-08-02
[Blue-5] | Test setting SPEED baud rate | - Power On mainboard - Send a string: "AT+BAUD1" | - Setting successfully. LCD shows "OK1200" - Setting unsuccessfully. LCD shows "FAIL" | The firmware must start-up successfully and LCD runs | Pass | 2012-08-02
 | Accelemeter: identify the inclination for the balance of FUFO frame following acceleration
[Accel-1] | Test to measure Euler's angle | - Power On mainboard - Set FUFO frame inclinate compare with plan about 5 degree | - LCD shows "4 degree to 6 degree" | The firmware must start-up successfully and LCD runs | Pass | 2012-08-04
 | Gyrosmeter: identify the inclination for the balance of FUFO frame following angular velocity
[Gyros-1] | Test to measure Euler's angle | - Power On mainboard - Set FUFO frame inclinate compare with ground about 7 degree | - LCD shows "6 degree to 8 degree" | The firmware must start-up successfully and LCD runs | Pass | 2012-08-08
 | Barometric: identify the altitude of FUFO frame
[Baro-1] | Test to measure altitude | - Power On mainboard - Set FUFO frame stand on 1 meters from ground | - LCD shows "0.8 meters to 1.2 meters" | The firmware must start-up successfully and LCD runs | Fail | 2012-08-08
 | Motors+ ESC
[Moto-1] | Test to measure altitude | - Power On mainboard - Set FUFO frame stand on 1 meters from ground | - LCD shows "0.8 meters to 1.2 meters" | The firmware must start-up successfully and LCD runs | Fail | 2012-08-08

Sheet: Test Report
TEST REPORT
Project Name | FPT Unidentified Flying Object |  | Creator |  |  | TRAN THI YEN
Project Code | FUFO |  | Reviewer/Approver |  |  | VU MINH PHONG
Document Code | FUFO_Test Report_v1.0 |  | Issue Date |  |  | 2012-08-09
No | Module code | Pass | NG | Untested | N/A | Number of test cases
1 | VP | 70 | 0 | 0 | 0 | 70
2 | FUFO | 7 | 2 | 0 | 0 | 9
 | Sub total | 77 | 2 | 0 | 0 | 79
 | Test coverage |  | 100.00 | %
 | Test successful coverage |  | 97.47 | %

Sheet: Main-Screen
C-001: Main Screen
Main Screen on AOC

Sheet: Setting-Form
Setting's Screen on AOP

Sheet: Control-Form
Control's screen on AOP
