phong1990/fufo-innovation/Document/02.Template/yen template/Template_Estimate WBS.xls

Sheet: Summary
Estimate for | <Project Code>
Note: Fill up the cells with white color only
Version | <N.x> | Date
Estimated by |  | Approved by
I. Estimates
1. Project Effort (person days) | 0.0
Note
<The estimate is broken into 2 sections:>
<UCP estimate for CTS application>
<Work Breakdown estimate for Business Object reports>
2. Project Human Resource (persons) | 0
Role | Skill & Experience required | Required number
Project Manager
Development Leader
Test Leader
Business Analyst
Designer
Developer
Tester
Communicator
3. Project Duration (months)
Note
<This duration can vary on expectation from customers>
II. Assumption
1. Out of scope
The estimate does not include the following items:
Item |  | Reason
<Pan-E CR Export with XML format MQ series to send> |  | <Need more info about what to export>
<Techline Export with the use of DECS> |  | <Need more info about what to export>
2. Input from Client
The following input are expected to be provided by <Client name>.
Item |  | Before
<Related Web applications: Customer Records, NEWS> |  | <Project start>
3. On-site resource
There are onsite resources required:
<A senior developer will work on-site to clarify requirement and study related databases and applications.
<Timeframe will be discussed later>
4. Risks
The following items need to be resolved ASAP
<Setup or simulate similar working environment at SDC>
<Connectivity from stored procedures at MS SQL to database at DB2 (i.e. LMS)>
<Refer to Risk list if needed>
5. Others

Sheet: WBS
Work Breakdown Structure
(Please select Module-based WBS or Activity-based WBS)
Module-based WBS
 | No | Task Particulars | Complexity | Size | Effort (person-day) |  |  |  |  |  |  |  |  | Total | Ratio
 |  |  |  |  | Requirement | Design | Coding | Test |  |  | Deployment | Support for Acceptance Test
 |  |  |  |  |  |  |  | Unit Test | Integration Test | System Test |  |  | Communication and Translation
 |  | Development |  |  | 19 | 0 | 0 | 0 | 8 | 4 | 0 | 0 | 0 | 31 | 81.57894737%
 |  | Module I |  |  | 12 | 0 | 0 | 0 | 0 | 4 | 0 | 0 | 0 | 16 | 42.10526316%
 | 1 | Function A |  |  |  |  |  |  |  | 4 |  |  |  | 4
 | 2 | Function B |  |  | 12 |  |  |  |  |  |  |  |  | 12
 | 3 | Function C |  |  |  |  |  |  |  |  |  |  |  | 0
 |  | Module II |  |  | 7 | 0 | 0 | 0 | 8 | 0 | 0 | 0 | 0 | 15 | 39.47368421%
 | 4 | Function D |  |  |  |  |  |  | 8 |  |  |  |  | 8
 | 5 | Function E |  |  | 7 |  |  |  |  |  |  |  |  | 7
 | 6 | Function F |  |  |  |  |  |  |  |  |  |  |  | 0
 |  | Module III |  |  | 0 | 0 | 0 | 0 | 0 | 0 | 0 | 0 | 0 | 0 | 0%
 | 7 | Function G |  |  |  |  |  |  |  |  |  |  |  | 0
 | 8 | Function H |  |  |  |  |  |  |  |  |  |  |  | 0
 |  | Management |  |  |  |  |  |  |  |  |  |  |  | 7 | 18.42105263%
 | 10 | PM |  |  |  |  |  |  |  |  |  |  |  | 2
 | 11 | CM
 | 12 | Contract Management |  |  |  |  |  |  |  |  |  |  |  | 5
 | 13 | Prevention
 | 14 | Training
 | 15 | Quality Control
 |  | Total |  |  |  |  |  |  |  |  |  |  |  | 38 | 100%
 |  | Buffer for Risk |  |  |  |  |  |  |  |  |  |  |  | 5 | 13.15789474%
 |  | Total (include "Buffer for Risk") |  |  |  |  |  |  |  |  |  |  |  | 43 | 113.1578947%
 | Note:
 | <_____Note 1_____>
 | <_____Note 2_____>
 | <_____Note 3_____>
Activity-based WBS
 | # | Activity | ID |  | Tasks |  |  |  | # people involved | Estimated Effort | Estimated Ratio | Description
 |  | Requirement |  |  | Requirement |  |  |  | 0 | 0 | 0%
 |  |  |  |  | Module I |  |  |  | 0 | 0
 | 1 |  |  |  | Function A
 | 2 |  |  |  | Function B
 | 3 |  |  |  | Function C
 |  |  |  |  | Module II |  |  |  | 0 | 0
 | 4 |  |  |  | Function D
 | 5 |  |  |  | Function E
 | 6 |  |  |  | Function F
 |  |  |  |  | Module III |  |  |  | 0 | 0
 | 7 |  |  |  | Function G
 | 8 |  |  |  | Function H
 |  | Design |  |  | Design |  |  |  | 0 | 0 | 0%
 |  |  |  |  | Module I |  |  |  | 0 | 0
 | 1 |  |  |  | Function A
 | 2 |  |  |  | Function B
 | 3 |  |  |  | Function C
 |  |  |  |  | Module II |  |  |  | 0 | 0
 | 4 |  |  |  | Function D
 | 5 |  |  |  | Function E
 | 6 |  |  |  | Function F
 |  |  |  |  | Module III |  |  |  | 0 | 0
 | 7 |  |  |  | Function G
 | 8 |  |  |  | Function H
 |  | Coding |  |  | Coding |  |  |  | 0 | 0 | 0%
 |  |  |  |  | Module I |  |  |  | 0 | 0
 | 1 |  |  |  | Function A
 | 2 |  |  |  | Function B
 | 3 |  |  |  | Function C
 |  |  |  |  | Module II |  |  |  | 0 | 0
 | 4 |  |  |  | Function D
 | 5 |  |  |  | Function E
 | 6 |  |  |  | Function F
 |  |  |  |  | Module III |  |  |  | 0 | 0
 | 7 |  |  |  | Function G
 | 8 |  |  |  | Function H
 |  | Unit Test |  |  | Unit Test |  |  |  | 0 | 0 | 0%
 |  |  |  |  | Module I |  |  |  | 0 | 0
 | 1 |  |  |  | Function A
 | 2 |  |  |  | Function B
 | 3 |  |  |  | Function C
 |  |  |  |  | Module II |  |  |  | 0 | 0
 | 4 |  |  |  | Function D
 | 5 |  |  |  | Function E
 | 6 |  |  |  | Function F
 |  |  |  |  | Module III |  |  |  | 0 | 0
 | 7 |  |  |  | Function G
 | 8 |  |  |  | Function H
 |  | Integration Test |  |  | Integration Test |  |  |  | 0 | 0 | 0%
 |  |  |  |  | Module I |  |  |  | 0 | 0
 | 1 |  |  |  | Function A
 | 2 |  |  |  | Function B
 | 3 |  |  |  | Function C
 |  |  |  |  | Module II |  |  |  | 0 | 0
 | 4 |  |  |  | Function D
 | 5 |  |  |  | Function E
 | 6 |  |  |  | Function F
 |  |  |  |  | Module III |  |  |  | 0 | 0
 | 7 |  |  |  | Function G
 | 8 |  |  |  | Function H
 |  | System Test |  |  | System Test |  |  |  | 0 | 0 | 0%
 |  |  |  |  | Module I |  |  |  | 0 | 0
 | 1 |  |  |  | Function A
 | 2 |  |  |  | Function B
 | 3 |  |  |  | Function C
 |  |  |  |  | Module II |  |  |  | 0 | 0
 | 4 |  |  |  | Function D
 | 5 |  |  |  | Function E
 | 6 |  |  |  | Function F
 |  |  |  |  | Module III |  |  |  | 0 | 0
 | 7 |  |  |  | Function G
 | 8 |  |  |  | Function H
 |  | Deployment |  |  | Deployment |  |  |  | 0 | 0 | 0%
 |  | Support |  |  | Support for Acceptance Test |  |  |  | 0 | 0 | 0%
 |  | Management |  |  | Overhead Management |  |  |  | 0 | 5 | 100%
 | 1 |  | 1 |  | PM |  |  |  |  | 5
 | 2 |  | 2 |  | CM
 | 3 |  | 3 |  | Contract Management
 | 4 |  | 4 |  | Prevention
 | 5 |  | 5 |  | Training
 | 6 |  | 6 |  | Quality Control
 |  | Others |  |  | Other |  |  |  | 0 | 0 | 0%
 | 7 |  | 7 |  | Communication and Translation
 | Total |  |  |  |  |  |  |  | 0 | 5 | 100%
 | Buffer for risk |  |  |  |  |  |  |  |  | 1 | 20%
 | Total (include "Buffer for risk") |  |  |  |  |  |  |  | 0 | 6 | 120%
 | Note:
 | <_____Note 1_____>
 | <_____Note 2_____>
 | <_____Note 3_____>

Sheet: Base of Estimation
Base of Estimation
1. Effort distribution of similar project segment in Software Project Database (project category, application type, scope, business domain, technology used, customer, etc)
(Copy all data tables of referred projects here)
Project Segment |  |  |  |  |  | Effort Distribution (category of effort distribution could be customized by projects)
Project Code | Project Type | Application type | Scope | SC | Customer | Requirement | Design | Coding | Test | Deployment | C.Support | PM | CM | Training | QA | Other
A | Development | Web application | C-Test |  |  | 0.13% | 0.00% | 86.00% | 1.84% | 0.13% | 0.00% | 4.06% | 0.20% | 3.93% | 3.55% | 0.15%
B | Development | Web application | Test |  |  | 2.05% | 0.00% | 0.00% | 66.32% | 2.06% | 0.01% | 15.62% | 4.72% | 7.32% | 0.77% | 1.15%
C | Maintenance | Web application | C-UT |  |  | 0.04% | 0.00% | 85.18% | 2.73% | 1.18% | 0.44% | 2.92% | 3.13% | 0.07% | 4.31% | 0.00%
D | Development | Back-end | D-C-Test |  |  | 5.78% | 2.89% | 31.08% | 18.92% | 4.34% | 0.00% | 28.67% | 0.96% | 0.00% | 5.42% | 1.93%
MediServe_BlackLabel | Others | Back-end | C-Test |  |  | 17.90% | 0.00% | 38.81% | 32.77% | 0.02% | 0.00% | 3.78% | 0.89% | 2.26% | 2.33% | 1.25%
NewMoon | Maintenance | Web application | S-C-UT |  |  | 35.73% | 2.72% | 32.97% | 13.13% | 0.20% | 0.94% | 3.65% | 0.83% | 6.10% | 3.11% | 0.62%
Average |  |  |  |  |  | 10.27% | 0.94% | 45.67% | 22.62% | 1.32% | 0.23% | 9.78% | 1.79% | 3.28% | 3.25% | 0.85%
STDEV |  |  |  |  |  | 14.2% | 1.5% | 33.7% | 24.3% | 1.7% | 0.4% | 10.4% | 1.8% | 3.1% | 1.6% | 0.7%
LCL |  |  |  |  |  | 0.0% | 0.0% | 0.0% | 0.0% | 0.0% | 0.0% | 0.0% | 0.0% | 0.0% | 0.0% | 0.0%
UCL |  |  |  |  |  | 52.73% | 5.29% | 146.92% | 95.41% | 6.35% | 1.40% | 41.09% | 7.04% | 12.46% | 8.08% | 3.05%
* Select projects for reference from the above list and specify reason for selection
('- We refer to project A because …
- We refer to project B because)
2. Compare Effort distribution of this project to similar project(s)
This Project | Total | Req | Design | Coding | UT Test | IT Test | ST Test | Deployment | Cust. Support | PM | CM | Training | QA | Other
Estimated effort in person-day | 100 | 10 | 8.02 | 23 | 6.2 | 22.75 | 5.97 | 1.61 | 3.53 | 9.41 | 1.49 | 3.28 | 4.74 | 0
Estimated effort in % | 100.00% | 10.00% | 8.02% | 23.00% | 6.20% | 22.75% | 5.97% | 1.61% | 3.53% | 9.41% | 1.49% | 3.28% | 4.74% | -0.0003284600515%
* Reasons for deriving at the estimation
(Specify reason is mandatory if the effort estimate for main processes is out of control limit of given by PCB for similar project segment.
Main processes are: Requirement, Design, Code Review, Unit Test, Review, Project Management and others that consume >15% of total project effort).
- The effort of requirement phase need to adjust to 10% because the requirement phase need more effort to read source code to analyze business
- The Operation effort is count with 21% of development effort. The operation effort are included efforts for Deployment, Customer support, PM , CM , Training and Other effort
3. Compare productivity with similar project(s)
Data | Sample Project (1) | Sample Project (2) | …. | This Project | Note
LOC | 75000 | 6000
Coding Productivity (LOC/Coding Effort) |  |  |  | 0 | (explanation is required if deviation between this project and sample projects >20%)
Project Productivity (LOC/Project Effort) |  |  |  | 0 | (explanation is required if deviation between this project and sample projects >20%)

Sheet: Schedule
Major Milestones
No |  | Task | No. of persons | Required days | Total efforts (PD) | Duration
 |  |  |  |  |  | Jun-08 |  | 2008-07-01 |  |  |  |  |  |  |  |  |  |  |  |  |  |  |  |  |  |  |  |  |  |  |  |  |  |  |  |  |  |  | Aug
 |  |  |  |  |  | 2005-06-29 | 2005-06-30 | 2005-07-01 | 2005-07-02 | 2005-07-03 | 2005-07-04 | 2005-07-05 | 2005-07-06 | 2005-07-07 | 2005-07-08 | 2005-07-09 | 2005-07-10 | 2005-07-11 | 2005-07-12 | 2005-07-13 | 2005-07-14 | 2005-07-15 | 2005-07-16 | 2005-07-17 | 2005-07-18 | 2005-07-19 | 2005-07-20 | 2005-07-21 | 2005-07-22 | 2005-07-23 | 2005-07-24 | 2005-07-25 | 2005-07-26 | 2005-07-27 | 2005-07-28 | 2005-07-29 | 2005-07-30 | 2005-07-31 | 2005-08-01 | 2005-08-02 | 2005-08-03 | 2005-08-04 | 2005-08-05 | 2005-08-06 | 2005-08-07 | 2005-08-08 | 2005-08-09 | 2005-08-10 | 2005-08-11 | 2005-08-12 | 2005-08-13 | 2005-08-14 | 2005-08-15 | 2005-08-16 | 2005-08-17 | 2005-08-18 | 2005-08-19 | 2005-08-20 | 2005-08-21
1 | 2 |  |  |  |  | Wed | Thu | Fri | Sat | Sun | Mon | Tue | Wed | Thu | Fri | Sat | Sun | Mon | Tue | Wed | Thu | Fri | Sat | Sun | Mon | Tue | Wed | Thu | Fri | Sat | Sun | Mon | Tue | Wed | Thu | Fri | Sat | Sun | Mon | Tue | Wed | Thu | Fri | Sat | Sun | Mon | Tue | Wed | Thu | Fri | Sat | Sun | Mon | Tue | Wed | Thu | Fri | Sat | Sun
1 |  | Requirement analysis |  |  | 0 |  |  |  | X | X |  |  |  |  |  | X | X |  |  |  |  |  | X | X |  |  |  |  |  | X | X |  |  |  |  |  | X | X |  |  |  |  |  | X | X |  |  |  |  |  | X | X |  |  |  |  |  | X | X
 | 1 | <_____Task 1_____> | 0 | 0 | 0 |  |  |  | X | X |  |  |  |  |  | X | X |  |  |  |  |  | X | X |  |  |  |  |  | X | X |  |  |  |  |  | X | X |  |  |  |  |  | X | X |  |  |  |  |  | X | X |  |  |  |  |  | X | X
 | 2 | <_____Task 2_____> | 0 | 0 | 0 |  |  |  | X | X |  |  |  |  |  | X | X |  |  |  |  |  | X | X |  |  |  |  |  | X | X |  |  |  |  |  | X | X |  |  |  |  |  | X | X |  |  |  |  |  | X | X |  |  |  |  |  | X | X
 | 3 | <_____Task 3_____> | 0 | 0 | 0 |  |  |  | X | X |  |  |  |  |  | X | X |  |  |  |  |  | X | X |  |  |  |  |  | X | X |  |  |  |  |  | X | X |  |  |  |  |  | X | X |  |  |  |  |  | X | X |  |  |  |  |  | X | X
2 |  | Design |  |  | 0 |  |  |  | X | X |  |  |  |  |  | X | X |  |  |  |  |  | X | X |  |  |  |  |  | X | X |  |  |  |  |  | X | X |  |  |  |  |  | X | X |  |  |  |  |  | X | X |  |  |  |  |  | X | X
 | 1 | <_____Task 1_____> | 0 | 0 | 0 |  |  |  | X | X |  |  |  |  |  | X | X | Design |  |  |  |  | X | X |  |  |  |  |  | X | X |  |  |  |  |  | X | X |  |  |  |  |  | X | X |  |  |  |  |  | X | X |  |  |  |  |  | X | X
 | 2 | <_____Task 2_____> | 0 | 0 | 0 |  |  |  | X | X |  |  |  |  |  | X | X |  |  |  |  |  | X | X |  |  |  |  |  | X | X |  |  |  |  |  | X | X |  |  |  |  |  | X | X |  |  |  |  |  | X | X |  |  |  |  |  | X | X
 | 3 | <_____Task 3_____> | 0 | 0 | 0 |  |  |  | X | X |  |  |  |  |  | X | X |  |  |  |  |  | X | X |  |  |  |  |  | X | X |  |  |  |  |  | X | X | ○ |  |  |  |  | X | X |  |  |  |  |  | X | X |  |  |  |  |  | X | X
3 |  | Coding & Unit Test |  |  | 0 |  |  |  | X | X |  |  |  |  |  | X | X |  |  |  |  |  | X | X |  |  |  |  |  | X | X |  |  |  |  |  | X | X |  |  |  |  |  | X | X |  |  |  |  |  | X | X |  |  |  |  |  | X | X
 | 1 | <_____Task 1_____> | 0 | 0 | 0 |  |  |  | X | X |  |  |  |  |  | X | X |  |  |  |  |  | X | X |  |  |  |  |  | X | X |  |  |  |  |  | X | X | Coding & Unit Test |  |  |  |  | X | X |  |  |  |  |  | X | X |  |  |  |  |  | X | X
 | 2 | <_____Task 2_____> | 0 | 0 | 0 |  |  |  | X | X |  |  |  |  |  | X | X |  |  |  |  |  | X | X |  |  |  |  |  | X | X |  |  |  |  |  | X | X |  |  |  |  |  | X | X |  |  |  |  |  | X | X | ○ |  |  |  |  | X | X
 | 3 | <_____Task 3_____> | 0 | 0 | 0 |  |  |  | X | X |  |  |  |  |  | X | X |  |  |  |  |  | X | X |  |  |  |  |  | X | X |  |  |  |  |  | X | X |  |  |  |  |  | X | X |  |  |  |  |  | X | X |  |  |  |  |  | X | X
4 |  | Integration Test |  |  | 0 |  |  |  | X | X |  |  |  |  |  | X | X |  |  |  |  |  | X | X |  |  |  |  |  | X | X |  |  |  |  |  | X | X |  |  |  |  |  | X | X |  |  |  |  |  | X | X |  |  |  |  |  | X | X
 | 1 | <_____Task 1_____> | 0 | 0 | 0 |  |  |  | X | X |  |  |  |  |  | X | X |  |  |  |  |  | X | X |  |  |  |  |  | X | X |  |  |  |  |  | X | X | ○ |  |  |  |  | X | X |  |  |  |  |  | X | X |  |  |  |  |  | X | X
 | 2 | <_____Task 2_____> | 0 | 0 | 0 |  |  |  | X | X |  |  |  |  |  | X | X |  |  |  |  |  | X | X |  |  |  |  |  | X | X |  |  |  |  |  | X | X |  |  |  |  |  | X | X |  |  |  |  |  | X | X |  |  |  |  |  | X | X
 | 3 | <_____Task 3_____> | 0 | 0 | 0 |  |  |  | X | X |  |  |  |  |  | X | X |  |  |  |  |  | X | X |  |  |  |  |  | X | X |  |  |  |  |  | X | X |  |  |  |  |  | X | X |  |  |  |  |  | X | X |  |  |  |  |  | X | X
5 |  | System Test |  |  | 0 |  |  |  | X | X |  |  |  |  |  | X | X |  |  |  |  |  | X | X |  |  |  |  |  | X | X |  |  |  |  |  | X | X |  |  |  |  |  | X | X |  |  |  |  |  | X | X |  |  |  |  |  | X | X
 | 1 | <_____Task 1_____> | 0 | 0 | 0 |  |  |  | X | X |  |  |  |  |  | X | X |  |  |  |  |  | X | X |  |  |  |  |  | X | X |  |  |  |  |  | X | X |  |  |  |  |  | X | X |  |  |  |  |  | X | X |  |  |  |  |  | X | X
 | 2 | <_____Task 2_____> | 0 | 0 | 0 |  |  |  | X | X |  |  |  |  |  | X | X |  |  |  |  |  | X | X |  |  |  |  |  | X | X |  |  |  |  |  | X | X |  |  |  |  |  | X | X |  |  |  |  |  | X | X |  |  |  |  | ○ | X | X
 | 3 | <_____Task 3_____> | 0 | 0 | 0 |  |  |  | X | X |  |  |  |  |  | X | X |  |  |  |  |  | X | X |  |  |  |  |  | X | X |  |  |  |  |  | X | X |  |  |  |  |  | X | X |  |  |  |  |  | X | X |  |  |  |  |  | X | X
6 |  | Deployment | 0 | 0 | 0 |  |  |  | X | X |  |  |  |  |  | X | X |  |  |  |  |  | X | X |  |  |  |  |  | X | X |  |  |  |  |  | X | X |  |  |  |  |  | X | X |  |  |  |  |  | X | X |  |  |  |  |  | X | X
7 |  | Support for Acceptance Release | 0 | 0 | 0 |  |  |  | X | X |  |  |  |  |  | X | X |  |  |  |  |  | X | X |  |  |  |  |  | X | X |  |  |  |  |  | X | X |  |  |  |  |  | X | X |  |  |  |  |  | X | X |  |  |  |  |  | X | X
8 |  | Project Management | 0 | 0 | 0 |  |  |  | X | X |  |  |  |  |  | X | X |  |  |  |  |  | X | X |  |  |  |  |  | X | X |  |  |  |  |  | X | X |  |  |  |  |  | X | X |  |  |  |  |  | X | X |  |  |  |  |  | X | X
9 |  | Configuration Management | 0 | 0 | 0
10 |  | Contract Management | 0 | 0 | 0
11 |  | Prevention | 0 | 0 | 0
12 |  | Training | 0 | 0 | 0
13 |  | Quality Control | 0 | 0 | 0 |  |  |  | X | X |  |  |  |  |  | X | X |  |  |  |  |  | X | X |  |  |  |  |  | X | X |  |  |  |  |  | X | X |  |  |  |  |  | X | X |  |  |  |  |  | X | X |  |  |  |  |  | X | X
14 |  | Communication and Translation | 0 | 0 | 0
15 |  | Others | 0 | 0 | 0 |  |  |  | X | X |  |  |  |  |  | X | X |  |  |  |  |  | X | X |  |  |  |  |  | X | X |  |  |  |  |  | X | X |  |  |  |  |  | X | X |  |  |  |  |  | X | X |  |  |  |  |  | X | X
 |  | Total |  |  | 0.00
 |  | Deliverables (○): |  |  |  |  | Project Duration:
 |  | yyyy/mm/dd: Deliver Function Specification |  |  |  |  | Starts: |  | yyyy/mm/dd
 |  | yyyy/mm/dd: Deliver Detail Design |  |  |  |  | Ends: |  | yyyy/mm/dd
 |  | yyyy/mm/dd: Deliver Interim Source I
 |  | yyyy/mm/dd: Deliver Interim PCL - Program Test |  |  |  |  | Holidays:
 |  | yyyy/mm/dd: Deliver Interim PCL - Total Test |  |  |  |  | FSOFT:
 |  | yyyy/mm/dd: Deliver Interim Source II |  |  |  |  | - Independent Day ( 2-Sep) | - <____Holidays 1____ yyyy/mm/dd>
 |  | yyyy/mm/dd: Deliver Acceptance Test Release |  |  |  |  | - FPT Foundation Day (13-Sep) | - <____Holidays 2____ yyyy/mm/dd ~ yyyy/mm/dd>
 |  | yyyy/mm/dd: Deliver Final Release |  |  |  |  | Customer:
 |  |  |  |  |  |  |  | - <____Holidays 1____ yyyy/mm/dd>
 |  |  |  |  |  |  |  | - <____Holidays 2____ yyyy/mm/dd ~ yyyy/mm/dd>
 |  | Notes: PM can establish the schedule for each phase, not for each task in some cases

Sheet: Estimated Cost
Estimation Cost
 | Note:
1
2
# | Summary | Efforts |  |  | Unit Cost | Cost
 |  | Person-Days | Person-Months | in (%) | <Currency unit>/month | <Currency>
1 | Development work | 0.00 | 0.00 | 0% |  | 0
1.1 | Requirement
1.2 | Design
1.3 | Coding&Unit test
1.4 | Integration Test
1.5 | System Test
1.6 | Deployment
1.7 | Support for Acceptance Test
1.8 | Others
2 | Overhead management | 0.00 | 0.00 | 0% |  | 0
2.1 | PM
2.2 | CM
2.3 | Contract Management
2.4 | Prevention
2.5 | Training
2.6 | Quality Control
2.7 | Communicator
2.8 | Onsite Cost
 |  |  |  |  | Total Cost: | 0
 |  | 0.00 | 0.00 | 0%
 |  | Person-Days | Person-Months |  | Final Cost: | 0

Sheet: Team
Resource Planned
# | Name | Role/Position | Contact Info | Qualification Information
1
2
3
4
5
6
7
8
9
10
 | Notes: PM do not need to fill out this sheet if there is not enough information about the team when doing estimation

Sheet: Record of change
Record of change
Effective Date | New Version | Changed Item | Change description | Reason for Change | Reference
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
