phong1990/fufo-innovation/(list of files, cad)

Other CAD files:
Document/04.Design/FUFO_FUFO/04.FUFO_Frame/Work/AutoCad/FUFO_MainFrame_Headless_NoPhoneGear.dwg
Document/04.Design/FUFO_FUFO/04.FUFO_Frame/Work/AutoCad/FUFO_MainFrame_Headless.dwg
Document/04.Design/FUFO_FUFO/04.FUFO_Frame/Work/AutoCad/FUFO_MainFrame_Headed.dwg
Document/04.Design/FUFO_FUFO/04.FUFO_Frame/Work/AutoCad/Component/FUFO_Frame_CarbonBar.dwg
Document/04.Design/FUFO_FUFO/04.FUFO_Frame/Work/AutoCad/Component/FUFO_S0.dwg
Document/04.Design/FUFO_FUFO/04.FUFO_Frame/Work/AutoCad/Component/FUFO_S2.dwg
Document/04.Design/FUFO_FUFO/04.FUFO_Frame/Work/AutoCad/Component/FUFO_S-1.dwg
Document/04.Design/FUFO_FUFO/04.FUFO_Frame/Work/AutoCad/Component/FUFO_Frame_MotorMount.dwg
Document/04.Design/FUFO_FUFO/04.FUFO_Frame/Work/AutoCad/Component/FUFO_Frame_LandingGear.dwg
Document/04.Design/FUFO_FUFO/04.FUFO_Frame/Model/FUFO_CarbonBar.skp
Document/04.Design/FUFO_FUFO/04.FUFO_Frame/Model/FUFO_LandingGear.skp
Document/04.Design/FUFO_FUFO/04.FUFO_Frame/Model/FUFO_MotorMount.skp
Document/04.Design/FUFO_FUFO/04.FUFO_Frame/Model/FUFO_OngRen1mm.skp
Document/04.Design/FUFO_FUFO/04.FUFO_Frame/Model/FUFO_OngRen2mm.skp
Document/04.Design/FUFO_FUFO/04.FUFO_Frame/Model/FUFO_OngRen3mm.skp
Document/04.Design/FUFO_FUFO/04.FUFO_Frame/Model/FUFO_OngRen5mm.skp
Document/04.Design/FUFO_FUFO/04.FUFO_Frame/Model/FUFO_S-1.skp
Document/04.Design/FUFO_FUFO/04.FUFO_Frame/Model/FUFO_S-2.skp
Document/04.Design/FUFO_FUFO/04.FUFO_Frame/Model/FUFO_S0.skp
Document/04.Design/FUFO_FUFO/04.FUFO_Frame/Model/FUFO_S1.skp
Document/04.Design/FUFO_FUFO/04.FUFO_Frame/Model/FUFO_S2.skp
Document/04.Design/FUFO_FUFO/04.FUFO_Frame/Work/AutoCad/Component/FUFO_S-2.dwg
Document/04.Design/FUFO_FUFO/04.FUFO_Frame/Work/AutoCad/Component/FUFO_S1.dwg
Document/04.Design/FUFO_FUFO/04.FUFO_Frame/Work/GoogleSketchup/Component/FUFO_Frame_CarbonBar.skp
Document/04.Design/FUFO_FUFO/04.FUFO_Frame/Work/GoogleSketchup/Component/FUFO_Frame_LandingGear.skp
Document/04.Design/FUFO_FUFO/04.FUFO_Frame/Work/GoogleSketchup/Component/FUFO_Frame_MotorMount.skp
Document/04.Design/FUFO_FUFO/04.FUFO_Frame/Work/GoogleSketchup/Component/FUFO_Frame_OngRen.skp
Document/04.Design/FUFO_FUFO/04.FUFO_Frame/Work/GoogleSketchup/Component/FUFO_Frame_S-1.skp
Document/04.Design/FUFO_FUFO/04.FUFO_Frame/Work/GoogleSketchup/Component/FUFO_Frame_S-2.skp
Document/04.Design/FUFO_FUFO/04.FUFO_Frame/Work/GoogleSketchup/Component/FUFO_Frame_S0.skp
Document/04.Design/FUFO_FUFO/04.FUFO_Frame/Work/GoogleSketchup/Component/FUFO_Frame_S1.skp
Document/04.Design/FUFO_FUFO/04.FUFO_Frame/Work/GoogleSketchup/Component/FUFO_Frame_S2.skp
Document/04.Design/FUFO_FUFO/04.FUFO_Frame/Work/GoogleSketchup/Model/FUFO_MainFrame_Headed.skp
Document/04.Design/FUFO_FUFO/04.FUFO_Frame/Work/GoogleSketchup/Model/FUFO_MainFrame_Headless.skp
Document/04.Design/FUFO_FUFO/04.FUFO_Frame/Work/GoogleSketchup/Model/FUFO_MainFrame_Headless_NoPhoneGear.skp
Document/04.Design/FUFO_FUFO/04.FUFO_Frame/Work/GoogleSketchup/Version2/Battery_Pack.skp
Document/04.Design/FUFO_FUFO/04.FUFO_Frame/Work/GoogleSketchup/Version2/Fiber_Bar.skp
Document/04.Design/FUFO_FUFO/04.FUFO_Frame/Work/GoogleSketchup/Version2/Full_Perspective.skp
Document/04.Design/FUFO_FUFO/04.FUFO_Frame/Work/GoogleSketchup/Version2/Layer1.skp
Document/04.Design/FUFO_FUFO/04.FUFO_Frame/Work/GoogleSketchup/Version2/Surface_Stabilizer.skp
