phong1990/fufo-innovation/Document/05.Test Case/FUFO_Buglist_V1.0.xlsx

Sheet: TotalBug_Report
Function | Unit test |  |  |  | Intergration test |  |  |  | System test |  |  |  | Result | UT+ST+AT | UT+ST+AT
 | Test case |  | Bug |  | Test case |  | Bug |  | Test case |  | Bug |  |  | Tong test cass Actual | Tong bug Actual
 | Plan | Actual | Plan | Actual | Plan | Actual | Plan | Actual | Plan | Actual | Plan | Actual
AOP | 55 | 58 | 8 | 9 | 40 | 53 | 6 | 6 | 15 | 17 | 3 | 3 | OK | 128 | 18
FUFO | 20 | 25 | 3 | 4 | 16 | 27 | 2 | 3 | 5 | 7 | 1 | 1 | OK | 59 | 8
AOC | 45 | 48 | 7 | 7 | 36 | 38 | 5 | 5 | 12 | 13 | 2 | 2 | OK | 99 | 14

Sheet: BugList
No | Module Name | Title bug | Type | Content of bug | Solution | Date detection | Tester | PIC | Date fix | Time fix | Status | Note
1 | AOP | Connection | IT | AOP không xác định được việc mất Connection Bluetooth của firmware | Đã thêm Thread check Connection | 2012-07-27 | YenTT | NguyenLK | 2012-07-28 | 3h | OK
2 | AOP | Connection | IT | Sang trái bị delay quá 10s | Đã fix method control | 2012-07-27 | YenTT | NguyenLK | 2012-07-28 | 2h | OK
3 | AOP | Connection | MT | Khi mất Connection với AOC, AOP không xác hiển thị mất Connection | Đã thêm textfield hiển thị bị mất Connection : "Disconnected" | 2012-08-01 | YenTT | NguyenLK | 2012-08-01 | 1h | OK
4 | AOP | Connection | MT | Khi mất Connection với bluetooth of FUFO frame, AOP không bắn message | Đã thêm textfield hiển thị bị mất Connection : "Disconnected" | 2012-08-02 | YenTT | NguyenLK | 2012-08-02 | 1h | OK
5 | AOP | Connection | MT | Sensor độ cao trả về độ cao không chính xác, lệch khoảng 20m so với thực tế | Do tác động của gió từ cánh quạt và nhiệt độ môi trường nên ảnh hướng tới sensor đo độ cao. Vì vậy đã lót 1 miếng mút mỏng lên trên sensor | 2012-08-02 | YenTT | NguyenLK | 2012-08-02 | 3h | OK
6 | AOP | System Control | MT | Sang phải bị delay quá 10s | Đã fix method control để giảm thiểu việc gửi comman bị delay | 2012-07-27 | YenTT | NguyenLK | 2012-07-27 | 2h | OK
7 | AOP | System Control | MT | Bấm nút "Up" khi FUFO frame đang ở trạng thái Landing, FUFO không hồi đáp kịp thời để cất cánh | Đã fix method control để giảm thiểu việc gửi comman bị delay | 2012-07-27 | YenTT | NguyenLK | 2012-07-27 | 3h | OK
8 | AOP | Connection | MT | Mất Connection firmware không xác định được | Đã thêm Thread check Connection | 2012-07-27 | YenTT | NguyenLK | 2012-07-27 | 3h | OK
9 | AOP | System Control | MT | Sang phải bị delay quá 10s | Đã fix method control | 2012-07-28 | YenTT | NguyenLK | 2012-07-27 | 5h | OK
10 | AOP | Connection | MT | Khi mất Connection với FUFO, AOC không xác hiển thị mất Connection | Đã thêm textfield hiển thị bị mất Connection : "Disconnected" | 2012-07-28 | YenTT | NguyenLK | 2012-07-28 | 5h | OK
11 | AOP | Connection | MT | Khi mất Connection với bluetooth of FUFO frame, AOP không bắn message | Đã thêm textfield hiển thị bị mất Connection : "Disconnected" | 2012-07-28 | YenTT | NguyenLK | 2012-07-28 | 5h | OK
12 | AOP | Connection | IT | Khi đang ở chế độ System Control qua computer, hệ thống System Control thông qua smartphone vẫn có thể click vào hệ thống System Control của phone | Đã giới hạn quyền cho bộ System Control . | 2012-07-28 | YenTT | NguyenLK | 2012-07-28 |  | OK
13 | AOP | System Control | IT | Sang phải bị delay quá 10s | Đã fix method control để giảm thiểu việc gửi comman bị delay | 2012-07-28 | YenTT | NguyenLK | 2012-07-28 |  | OK
14 | AOP | System Control | IT | Bấm nút "Up" khi FUFO frame đang ở trạng thái Landing, FUFO không hồi đáp kịp thời để cất cánh | Đã fix method control để giảm thiểu việc gửi comman bị delay | 2012-08-02 | YenTT | ThangVD | 2012-07-28 | 3h | OK
15 | AOP |  | IT | Lấy dữ liệu từ sensor gửi về chip không đúng | Lấy dữ liệu từ sensor gửi về chip không đúng | 2012-08-02 | YenTT | ThangVD | 2012-08-02 | 4h | OK
16 | AOP | Get data | ST | Lấy dữ liệu từ sensor gửi về chip không đúng | Lấy dữ liệu từ sensor gửi về chip không đúng | 2012-08-02 | YenTT | ThangVD | 2012-08-02 | 4h | OK
17 | AOP | Get data | ST | Lấy dữ liệu từ bluetooth gửi về chip không đúng | Đã sửa lại hàm fufuReadUART để lấy lại dữ liệu đúng | 2012-08-02 | YenTT | ThangVD | 2012-08-02 | 4h | OK
18 | AOP | Coding | ST | Sai kết quả gửi dữ liệu trả về cho điện thoại. Do thời gian tính toán không đủ | Do ban đầu yêu cầu PID gửi quá nhiều dữ liệu lên Application trên điện thoại nên không đủ thời gian tính toán. Vì vậy xử lý trong hàm calcPID giảm bớt các method gửi dữ liệu | 2012-08-02 | YenTT | HungHD | 2012-08-02 | 4h | OK
19 | FUFO | Coding | MT | Output của sensor về góc lệch so với trục 0x không đúng trong khoảng từ "-2048 --> +2047" | Do không khai báo hàm trong file Header. Nên đã khai báo thêm hàm tính toán lại phương hướng: fufoCalcAngleMag | 2012-08-03 | YenTT | HungHD | 2012-08-03 | 5h | OK
20 | FUFO | Coding | MT | Output của sensor về góc Theta bị sai không đúng trong khoảng "-180 --> +180 " | Do không khai báo hàm trong file Header. Nên đã khai báo thêm hàm tính toán lại phương hướng: getThetaAngle | 2012-08-03 | YenTT | HungHD | 2012-08-03 | 5h | OK
21 | FUFO | Coding | MT | Output của sensor về góc Phi bị sai không đúng trong khoảng "-180 --> +180 " | Do không khai báo hàm trong file Header. Nên đã khai báo thêm hàm tính toán lại phương hướng: getPhiAngle | 2012-08-03 | YenTT | HungHD | 2012-08-03 | 5h | OK
22 | FUFO | Coding | MT | Output của sensor về góc Psi bị sai không đúng trong khoảng "-180 --> +180 " | Do không khai báo hàm trong file Header. Nên đã khai báo thêm hàm tính toán lại phương hướng: getPsiAngle | 2012-08-03 | YenTT | HungHD | 2012-08-03 | 4h | OK
23 | FUFO | Hardware | IT | Sensor độ cao trả về độ cao không chính xác, lệch khoảng 20m so với thực tế | Do tác động của gió từ cánh quạt và nhiệt độ môi trường nên ảnh hướng tới sensor đo độ cao. Vì vậy đã lót 1 miếng mút mỏng lên trên sensor | 2012-08-04 | YenTT | ThangVD | 2012-08-04 | 4h | OK
24 | FUFO | Hardware | IT | Động cơ đột ngột ngừng hoạt động | Do các đầu dây Connection bị lỏng nên ảnh hưởng đến việc cấp điện. Vì vậy đã hàn và gắn chặt các đầu nối | 2012-08-04 | YenTT | ThangVD | 2012-08-04 | 3h | OK
25 | FUFO | Hardware | IT | Khi test 2 ESC đã bị cháy | Do xác định nhầm nguồn cho ESC . Vì vậy đã dùng ống co nhiệt màu để xác định đúng chiều cho nguồn cấp ESC | 2012-08-04 | YenTT | ThangVD | 2012-08-04 | 3h | OK
26 | FUFO | Hardware | ST | Test vi System Control không hoạt động | Do thiết kế nhầm tụ cho thạch anh . Đã bỏ tụ thiết kế sai cho thạch anh | 2012-08-04 | YenTT | ThangVD | 2012-08-04 | 3h | OK
27 | AOC | Connection | ST | AOP không xác định được việc mất Connection Bluetooth của firmware | Đã thêm Thread check Connection | 2012-08-04 | YenTT | NguyenLK | 2012-07-28 | 3h | OK
28 | AOC | Connection | IT | Sang trái bị delay quá 10s | Đã fix method control | 2012-08-04 | YenTT | NguyenLK | 2012-07-28 | 2h | OK
29 | AOC | Connection | UT | Khi mất Connection với AOC, AOP không xác hiển thị mất Connection | Đã thêm textfield hiển thị bị mất Connection : "Disconnected" | 2012-08-04 | YenTT | NguyenLK | 2012-08-01 | 1h | OK
30 | AOC | Connection | UT | Khi mất Connection với bluetooth of FUFO frame, AOP không bắn message | Đã thêm textfield hiển thị bị mất Connection : "Disconnected" | 2012-08-08 | YenTT | NguyenLK | 2012-08-02 | 1h | OK
31 | AOC | Connection | IT | Sensor độ cao trả về độ cao không chính xác, lệch khoảng 20m so với thực tế | Do tác động của gió từ cánh quạt và nhiệt độ môi trường nên ảnh hướng tới sensor đo độ cao. Vì vậy đã lót 1 miếng mút mỏng lên trên sensor | 2012-08-08 | 2012-08-08 | NguyenLK | 2012-08-08 | 4h | OK
32 | AOC | Coding | IT | Sai kết quả gửi dữ liệu trả về cho điện thoại. Do thời gian tính toán không đủ | Do ban đầu yêu cầu PID gửi quá nhiều dữ liệu lên Application trên điện thoại nên không đủ thời gian tính toán. Vì vậy xử lý trong hàm calcPID giảm bớt các method gửi dữ liệu | 2012-08-08 | 2012-08-08 | NguyenLK | 2012-08-08 | 4h | OK
33 | AOC | Coding | IT | Output của sensor về góc lệch so với trục 0x không đúng trong khoảng từ "-2048 --> +2047" | Do không khai báo hàm trong file Header. Nên đã khai báo thêm hàm tính toán lại phương hướng: fufoCalcAngleMag | 2012-08-08 | 2012-08-08 | NguyenLK | 2012-08-08 | 5h | OK
34 | AOC | Connection | UT | Mất Connection firmware không xác định được | Đã thêm Thread check Connection | 2012-08-08 | 2012-08-08 | NguyenLK | 2012-08-08 | 5h | OK
35 | AOC | System Control | UT | Sang trái bị delay quá 10s | Đã fix method control | 2012-08-10 | 2012-08-10 | NguyenLK | 2012-08-10 | 5h | OK
36 | AOC | Connection | UT | Khi mất Connection với FUFO, AOC không xác hiển thị mất Connection | Đã thêm textfield hiển thị bị mất Connection : "Disconnected" | 2012-08-10 | 2012-08-10 | NguyenLK | 2012-08-10 | 5h | OK
37 | AOC | Connection | UT | Khi mất Connection với bluetooth of FUFO frame, AOP không bắn message | Đã thêm textfield hiển thị bị mất Connection : "Disconnected" | 2012-08-10 | 2012-08-10 | NguyenLK | 2012-08-10 | 5h | OK
38 | AOC | Connection | IT | Khi đang ở chế độ System Control qua computer, hệ thống System Control thông qua smartphone vẫn có thể click vào hệ thống System Control của phone | Đã giới hạn quyền cho bộ System Control . | 2012-08-10 | 2012-08-10 | NguyenLK | 2012-08-10 | 3h | OK
39 | AOC | System Control | UT | Sang phải bị delay quá 10s | Đã fix method control để giảm thiểu việc gửi comman bị delay | 2012-08-10 | 2012-08-10 | NguyenLK | 2012-08-10 | 4h | OK
40 | AOC | System Control | ST | Bấm nút "Up" khi FUFO frame đang ở trạng thái Landing, FUFO không hồi đáp kịp thời để cất cánh | Đã fix method control để giảm thiểu việc gửi comman bị delay | 2012-08-10 | 2012-08-10 | NguyenLK | 2012-08-10 | 4h | OK
