phong1990/fufo-innovation/Document/05.Test Case/UT/FUFO_Project_UnitTest_AOC_v1.0.xls

Sheet: For summary
Number of pages | 4
Total | 48 | 48 | 0 | 0 | 48 | 100%
 | Number of checkitems
Sheet name |  | Normal | Abnormal | Boundary | Number of tested checkitems | Tested rate
KeyListener()-AOC | 11 | 11 | 0 | 0 | 11 | 100%
MouseListener()-AOC | 11 | 11 | 0 | 0 | 11 | 100%
RotateAndTranslate()-AOC | 10 | 10 | 0 | 0 | 10 | 100%
onClick()-ControlActivity-AOC | 16 | 16 | 0 | 0 | 16 | 100%

Sheet: KeyListener()-AOC
Matrix checklist |  |  | Title |  |  |  |  | int main(void)
Check condition/Confirmation content |  | Check ID | UT01-001 | UT01-002 | UT01-003 | UT01-004 | UT01-005 | UT01-006 | UT01-007 | UT01-008 | UT01-009 | UT01-010 | UT01-011
Check condition | Press keyboard :
 |  | a | o
 |  | s |  | o
 |  | w |  |  | o
 |  | d |  |  |  | o
 |  | up |  |  |  |  | o
 |  | down |  |  |  |  |  | o
 |  | right |  |  |  |  |  |  | o
 |  | left |  |  |  |  |  |  |  | o
 |  | enter |  |  |  |  |  |  |  |  | o
 |  | exit |  |  |  |  |  |  |  |  |  | o
 |  | minimize |  |  |  |  |  |  |  |  |  |  | o
Confirmation content | Button action | button left | o
 |  | button backward |  | o
 |  | button forward |  |  | o
 |  | button right |  |  |  | o
 |  | button up |  |  |  |  | o
 |  | button down |  |  |  |  |  | o
 |  | button rotate left |  |  |  |  |  |  | o
 |  | button rotateright |  |  |  |  |  |  |  | o
 |  | button start |  |  |  |  |  |  |  |  | o
 |  | button exit |  |  |  |  |  |  |  |  |  | o
 |  | button minimize |  |  |  |  |  |  |  |  |  |  | o
 | Finish method |  | o | o | o | o | o | o | o | o | o | o | o
Normal(N) / Abnormal(E) / Boundary(L) |  |  | N | N | N | N | N | N | N | N | N | N | N
Confirmation date |  | On desk | 2012-08-10 | 2012-08-10 | 2012-08-10 | 2012-08-10 | 2012-08-10 | 2012-08-10 | 2012-08-10 | 2012-08-10 | 2012-08-10 | 2012-08-10 | 2012-08-10
 |  | Machine
Note |  |  | Creator |  |  |  |  | YenTT |  |  |  |  | Approver | PhongVM
 |  |  | Create date |  |  |  |  | 2012-08-05 |  |  |  |  | Approval date | 2012-08-10
 |  |  |  |  |  |  |  |  |  |  |  |  | Sheet number | 1 | 4

Sheet: MouseListener()-AOC
Matrix checklist |  |  | Title |  |  |  |  | int main(void)
Check condition/Confirmation content |  | Check ID | UT01-001 | UT01-002 | UT01-003 | UT01-004 | UT01-005 | UT01-006 | UT01-007 | UT01-008 | UT01-009
Check condition | Press mouse to the button :
 |  | button left | o
 |  | button backward |  | o
 |  | button forward |  |  | o
 |  | button right |  |  |  | o
 |  | button up |  |  |  |  | o
 |  | button down |  |  |  |  |  | o
 |  | button rotate left |  |  |  |  |  |  | o
 |  | button rotateright |  |  |  |  |  |  |  | o
 |  | button start |  |  |  |  |  |  |  |  | o
Confirmation content | Button action | button left | o
 |  | button backward |  | o
 |  | button forward |  |  | o
 |  | button right |  |  |  | o
 |  | button up |  |  |  |  | o
 |  | button down |  |  |  |  |  | o
 |  | button rotate left |  |  |  |  |  |  | o
 |  | button rotateright |  |  |  |  |  |  |  | o
 |  | button start |  |  |  |  |  |  |  |  | o
 | Finish method |  | o | o | o | o | o | o | o | o | o
Normal(N) / Abnormal(E) / Boundary(L) |  |  | N | N | N | N | N | N | N | N | N
Confirmation date |  | On desk | 2012-08-10 | 2012-08-10 | 2012-08-10 | 2012-08-10 | 2012-08-10 | 2012-08-10 | 2012-08-10 | 2012-08-10 | 2012-08-10
 |  | Machine
Note |  |  | Creator |  |  |  |  | YenTT |  |  |  | Approver | PhongVM
 |  |  | Create date |  |  |  |  | 2012-08-05 |  |  |  | Approval date | 2012-08-10
 |  |  |  |  |  |  |  |  |  |  |  | Sheet number | 1 | 4

Sheet: RotateAndTranslate()-AOC
Matrix checklist |  |  | Title |  |  |  |  | int main(void)
Check condition/Confirmation content |  | Check ID | UT01-001 | UT01-002 | UT01-003 | UT01-004 | UT01-005 | UT01-006 | UT01-007 | UT01-008 | UT01-009 | UT01-010 | UT01-011 | UT01-012 | UT01-013 | UT01-014 | UT01-015 | UT01-016 | UT01-017 | UT01-018 | UT01-019 | UT01-020
Check condition | Set pitch angle:
 |  | 0 | o
 |  | 30 |  | o
 |  | 60 |  |  | o
 |  | 90 |  |  |  | o
 |  | -30 |  |  |  |  | o
 |  | -60 |  |  |  |  |  | o
 |  | -90 |  |  |  |  |  |  | o
 |  | -100 |  |  |  |  |  |  |  | o
 |  | 100 |  |  |  |  |  |  |  |  | o
 | Set roll angle: | 0 |  |  |  |  |  |  |  |  |  | o
 |  | 30 |  |  |  |  |  |  |  |  |  |  | o
 |  | 60 |  |  |  |  |  |  |  |  |  |  |  | o
 |  | 90 |  |  |  |  |  |  |  |  |  |  |  |  | o
 |  | -30 |  |  |  |  |  |  |  |  |  |  |  |  |  | o
 |  | -60 |  |  |  |  |  |  |  |  |  |  |  |  |  |  | o
 |  | -90 |  |  |  |  |  |  |  |  |  |  |  |  |  |  |  | o
 |  | -100 |  |  |  |  |  |  |  |  |  |  |  |  |  |  |  |  | o
 | Set pitch and roll angle: | 0 0 |  |  |  |  |  |  |  |  |  |  |  |  |  |  |  |  |  | o
 |  | 30 60 |  |  |  |  |  |  |  |  |  |  |  |  |  |  |  |  |  |  | o
 |  | -30 60 |  |  |  |  |  |  |  |  |  |  |  |  |  |  |  |  |  |  |  | o
Confirmation content | Button action | show base on the angles | o
 |  | show base on the angles |  | o
 |  | show base on the angles |  |  | o
 |  | show base on the angles |  |  |  | o
 |  | show base on the angles |  |  |  |  | o
 |  | show base on the angles |  |  |  |  |  | o
 |  | show base on the angles |  |  |  |  |  |  | o
 |  | show base on the angles |  |  |  |  |  |  |  | o
 |  | show base on the angles |  |  |  |  |  |  |  |  | o
 |  | show base on the angles |  |  |  |  |  |  |  |  |  | o
 |  | show base on the angles |  |  |  |  |  |  |  |  |  |  | o
 |  | show base on the angles |  |  |  |  |  |  |  |  |  |  |  | o
 |  | show base on the angles |  |  |  |  |  |  |  |  |  |  |  |  | o
 |  | show base on the angles |  |  |  |  |  |  |  |  |  |  |  |  |  | o
 |  | show base on the angles |  |  |  |  |  |  |  |  |  |  |  |  |  |  | o
 |  | show base on the angles |  |  |  |  |  |  |  |  |  |  |  |  |  |  |  | o
 |  | show base on the angles |  |  |  |  |  |  |  |  |  |  |  |  |  |  |  |  | o
 |  | show base on the angles |  |  |  |  |  |  |  |  |  |  |  |  |  |  |  |  |  | o
 |  | show base on the angles |  |  |  |  |  |  |  |  |  |  |  |  |  |  |  |  |  |  | o
 |  | show base on the angles |  |  |  |  |  |  |  |  |  |  |  |  |  |  |  |  |  |  |  | o
 | Finish method |  | o | o | o | o | o | o | o | o | o | o | o | o | o | o | o | o | o | o | o | o
Normal(N) / Abnormal(E) / Boundary(L) |  |  | N | N | N | N | N | N | N | N | N | N | N | N | N | N | N | N | N | N | N | N
Confirmation date |  | On desk | 2012-08-10 | 2012-08-10 | 2012-08-10 | 2012-08-10 | 2012-08-10 | 2012-08-10 | 2012-08-10 | 2012-08-10 | 2012-08-10 | 2012-08-10 | 2012-08-10 | 2012-08-10 | 2012-08-10 | 2012-08-10 | 2012-08-10 | 2012-08-10 | 2012-08-10 | 2012-08-10 | 2012-08-10 | 2012-08-10
 |  | Machine
Note |  |  | Creator |  |  |  |  | YenTT |  |  |  |  | Approver |  |  |  |  | PhongVM
 |  |  | Create date |  |  |  |  | 2012-08-05 |  |  |  |  | Approval date |  |  |  |  | 2012-08-10
 |  |  |  |  |  |  |  |  |  |  |  |  | Sheet number |  |  |  |  | 1 |  |  |  | 4

Sheet: onClick()-ControlActivity-AOC
Matrix checklist |  |  | Title |  |  |  |  | int main(void)
Check condition/Confirmation content |  | Check ID | UT01-001 | UT01-002 | UT01-003 | UT01-004 | UT01-005 | UT01-006 | UT01-007 | UT01-008 | UT01-009
Check condition | Press to the button :
 |  | button left | o
 |  | button backward |  | o
 |  | button forward |  |  | o
 |  | button right |  |  |  | o
 |  | button up |  |  |  |  | o
 |  | button down |  |  |  |  |  | o
 |  | button rotate left |  |  |  |  |  |  | o
 |  | button rotateright |  |  |  |  |  |  |  | o
 |  | button start |  |  |  |  |  |  |  |  | o
Confirmation content | Button action | button left | o
 |  | button backward |  | o
 |  | button forward |  |  | o
 |  | button right |  |  |  | o
 |  | button up |  |  |  |  | o
 |  | button down |  |  |  |  |  | o
 |  | button rotate left |  |  |  |  |  |  | o
 |  | button rotateright |  |  |  |  |  |  |  | o
 |  | button start |  |  |  |  |  |  |  |  | o
 | Finish method |  | o | o | o | o | o | o | o | o | o
Normal(N) / Abnormal(E) / Boundary(L) |  |  | N | N | N | N | N | N | N | N | N
Confirmation date |  | On desk | 2012-08-10 | 2012-08-10 | 2012-08-10 | 2012-08-10 | 2012-08-10 | 2012-08-10 | 2012-08-10 | 2012-08-10 | 2012-08-10
 |  | Machine
Note |  |  | Creator |  |  |  |  | YenTT |  |  |  | Approver | PhongVM
 |  |  | Create date |  |  |  |  | 2012-08-05 |  |  |  | Approval date | 2012-08-10
 |  |  |  |  |  |  |  |  |  |  |  | Sheet number | 1 | 4
