phong1990/fufo-innovation/Document/04.Design/FUFO_FUFO/Filter/Sample_Data/TestAltitude-08-17-2012/TestAltitude14h52.txt

000.300	000.150	000.000	000.000	000.040	
000.300	000.150	000.000	000.000	000.040	
000.300	000.150	000.000	000.000	000.040	
000.300	000.150	000.000	000.037	000.040	
000.300	000.150	000.000	000.037	000.040	
000.300	000.150	000.000	000.037	000.040	
000.300	000.150	000.051	006.806	000.040	
000.300	000.150	000.051	006.806	000.040	
000.300	000.150	000.051	006.806	000.040	
000.300	000.150	000.139	006.806	000.040	
000.300	000.150	000.139	006.806	000.040	
000.300	000.150	000.139	006.806	000.040	
000.300	000.150	000.253	006.806	000.040	
000.300	000.150	000.253	006.806	000.040	
000.300	000.150	000.253	006.806	000.040	
000.300	000.150	000.329	-000.723	000.040	
000.300	000.150	000.329	-000.723	000.040	
000.300	000.150	000.329	-000.723	000.040	
000.300	000.150	000.378	-000.470	000.040	
000.300	000.150	000.378	-000.470	000.040	
000.300	000.150	000.378	-000.470	000.040	
000.300	000.150	000.407	-000.470	000.040	
000.300	000.150	000.407	-000.470	000.040	
000.300	000.150	000.407	-000.470	000.040	
000.300	000.150	000.423	-000.301	000.040	
000.300	000.150	000.423	-000.301	000.040	
000.300	000.150	000.423	-000.301	000.040	
000.300	000.150	000.429	-000.301	000.040	
000.300	000.150	000.429	-000.301	000.040	
000.300	000.150	000.429	-000.301	000.040	
000.300	000.150	000.428	-000.301	000.040	
000.300	000.150	000.428	-000.301	000.040	
000.300	000.150	000.428	-000.301	000.040	
000.300	000.150	000.417	-000.892	000.040	
000.300	000.150	000.417	-000.892	000.040	
000.300	000.150	000.417	-000.892	000.040	
000.300	000.150	000.400	-000.892	000.040	
000.300	000.150	000.400	-000.892	000.040	
000.300	000.150	000.400	-000.892	000.040	
000.300	000.150	000.381	-000.470	000.040	
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
