phong1990/fufo-innovation/Document/04.Design/FUFO_FUFO/Filter/Sample_Data/TestAltitude-08-17-2012/TestAltitude 12h18.txt

000.200	000.150	000.000	000.000	000.040	
000.200	000.150	000.000	000.000	000.040	
000.200	000.150	000.000	000.000	000.040	
000.200	000.150	-000.000	-000.287	000.040	
000.200	000.150	-000.000	-000.287	000.040	
000.200	000.150	-000.000	-000.287	000.040	
000.200	000.150	000.009	004.352	000.040	
000.200	000.150	000.009	004.352	000.040	
000.200	000.150	000.009	004.352	000.040	
000.200	000.150	000.029	004.944	000.040	
000.200	000.150	000.029	004.944	000.040	
000.200	000.150	000.029	004.944	000.040	
000.200	000.150	000.056	004.944	000.040	
000.200	000.150	000.056	004.944	000.040	
000.200	000.150	000.056	004.944	000.040	
000.200	000.150	000.076	-000.118	000.040	
000.200	000.150	000.076	-000.118	000.040	
000.200	000.150	000.076	-000.118	000.040	
000.200	000.150	000.091	000.219	000.040	
000.200	000.150	000.091	000.219	000.040	
000.200	000.150	000.091	000.219	000.040	
000.200	000.150	000.102	-000.033	000.040	
000.200	000.150	000.102	-000.033	000.040	
000.200	000.150	000.102	-000.033	000.040	
000.200	000.150	000.110	000.304	000.040	
000.200	000.150	000.110	000.304	000.040	
000.200	000.150	000.110	000.304	000.040	
000.200	000.150	000.118	000.724	000.040	
000.200	000.150	000.118	000.724	000.040	
000.200	000.150	000.118	000.724	000.040	
000.200	000.150	000.126	000.724	000.040	
000.200	000.150	000.126	000.724	000.040	
000.200	000.150	000.126	000.724	000.040	
000.200	000.150	000.131	-000.033	000.040	
000.200	000.150	000.131	-000.033	000.040	
000.200	000.150	000.131	-000.033	000.040	
000.200	000.150	000.134	-000.118	000.040	
000.200	000.150	000.134	-000.118	000.040	
000.200	000.150	000.134	-000.118	000.040	
000.200	000.150	000.136	000.135	000.040	
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
