phong1990/fufo-innovation/Document/04.Design/FUFO_FUFO/Filter/Sample_Data/TestAltitude-08-17-2012/TestAltitude 11h49.txt

000.000	000.000	000.000	000.000	-001.126	
000.000	000.000	000.000	000.000	-001.588	
000.000	000.000	000.000	000.000	-002.230	
000.000	000.000	-000.000	-000.351	-002.713	
000.000	000.000	-000.000	-000.351	-002.717	
000.000	000.000	-000.000	-000.351	-003.293	
000.000	000.000	000.007	003.696	-003.405	
000.000	000.000	000.007	003.696	-002.601	
000.000	000.000	000.007	003.696	-002.184	
000.000	000.000	000.024	004.285	-002.026	
000.000	000.000	000.024	004.285	-001.912	
000.000	000.000	000.024	004.285	-001.813	
000.000	000.000	000.048	004.285	-001.869	
000.000	000.000	000.048	004.285	-002.126	
000.000	000.000	000.048	004.285	-001.923	
000.000	000.000	000.064	-000.182	-001.669	
000.000	000.000	000.064	-000.182	-001.963	
000.000	000.000	000.064	-000.182	-002.217	
000.000	000.000	000.077	000.155	-002.724	
000.000	000.000	000.077	000.155	-002.345	
000.000	000.000	000.077	000.155	-002.768	
000.000	000.000	000.087	000.406	-002.288	
000.000	000.000	000.087	000.406	-002.075	
000.000	000.000	000.087	000.406	-001.800	
000.000	000.000	000.096	000.745	-001.566	
000.000	000.000	000.096	000.745	-001.490	
000.000	000.000	000.096	000.745	-001.075	
000.000	000.000	000.105	000.829	-001.053	
000.000	000.000	000.105	000.829	-001.003	
000.000	000.000	000.105	000.829	-001.131	
000.000	000.000	000.113	000.829	-000.974	
000.000	000.000	000.113	000.829	-001.087	
000.000	000.000	000.113	000.829	-000.986	
000.000	000.000	000.120	000.324	-000.933	
000.000	000.000	000.120	000.324	-000.716	
000.000	000.000	000.120	000.324	-000.729	
000.000	000.000	000.127	000.745	-000.685	
000.000	000.000	000.127	000.745	-000.871	
000.000	000.000	000.127	000.745	-000.566	
000.000	000.000	000.132	000.406	-000.184	
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
