phong1990/fufo-innovation/Document/04.Design/FUFO_FUFO/Filter/Sample_Data/TestAltitude-08-17-2012/TestAltitude 11h03.txt

-001.639	-000.041	000.000	000.000	-001.181	
-001.639	-000.041	000.000	000.000	-001.491	
-001.639	-000.041	000.000	000.000	-001.846	
-001.639	-000.041	-000.091	-000.366	-002.415	
-001.639	-000.041	-000.091	-000.366	-002.849	
-001.639	-000.041	-000.091	-000.366	-003.174	
-001.639	-000.041	-000.160	-000.366	-003.209	
-001.639	-000.041	-000.160	-002.726	-003.264	
-001.639	-000.041	-000.160	-002.726	-002.992	
-001.639	-000.041	-000.160	-002.726	-003.227	
-001.639	-000.041	-000.759	-002.557	-002.492	
-001.639	-000.041	-000.759	-002.557	-002.834	
-001.639	-000.041	-000.759	-002.557	-002.931	
-001.639	-000.041	-001.209	-002.557	-003.220	
-001.639	-000.041	-001.209	-002.557	-003.409	
-001.639	-000.041	-001.209	-002.557	-003.609	
-001.639	-000.041	-001.546	-002.557	-003.544	
-001.639	-000.041	-001.546	000.053	-003.536	
-001.639	-000.041	-001.546	000.053	-003.797	
-001.639	-000.041	-001.546	000.053	-004.188	
-001.639	-000.041	-001.146	000.053	-004.035	
-001.639	-000.041	-001.146	000.222	-003.804	
-001.639	-000.041	-001.146	000.222	-003.737	
-001.639	-000.041	-001.146	000.222	-004.032	
-001.639	-000.041	-000.804	000.222	-004.153	
-001.639	-000.041	-000.804	-000.031	-004.293	
-001.639	-000.041	-000.804	-000.031	-004.369	
-001.639	-000.041	-000.804	-000.031	-004.339	
-001.639	-000.041	-000.610	-000.031	-004.857	
-001.639	-000.041	-000.610	000.560	-005.207	
-001.639	-000.041	-000.610	000.560	-005.151	
-001.639	-000.041	-000.610	000.560	-004.687	
-001.639	-000.041	-000.317	000.560	-003.970	
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
-001.639	-000.041	000.201	000.137	-002.483	
-001.639	-000.041	000.185	000.137	-003.479	
-001.639	-000.041	000.185	000.137	-003.633	
-001.639	-000.041	000.185	000.137	-003.776	
-001.639	-000.041	000.216	000.307	-004.036	
-001.639	-000.041	000.216	000.307	-004.117	
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
