phong1990/fufo-innovation/Document/04.Design/FUFO_FUFO/Filter/Sample_Data/TestAltitude-08-17-2012/TestAltitude 10h40.txt

-001.639	-000.041	000.000	000.000	-000.505	
-001.639	-000.041	000.000	000.000	-000.500	
-001.639	-000.041	000.000	000.000	-000.492	
-001.639	-000.041	-000.142	-000.570	-000.487	
-001.639	-000.041	-000.142	-000.570	-000.483	
-001.639	-000.041	-000.142	-000.570	-000.484	
-001.639	-000.041	-000.249	-000.570	-000.481	
-001.639	-000.041	-000.249	002.885	-000.478	
-001.639	-000.041	-000.249	002.885	-000.472	
-001.639	-000.041	-000.249	002.885	-000.464	
-001.639	-000.041	000.765	003.812	-000.459	
-001.639	-000.041	000.765	003.812	-000.459	
-001.639	-000.041	000.765	003.812	-000.451	
-001.639	-000.041	001.527	003.812	-000.449	
-001.639	-000.041	001.527	003.812	-000.441	
-001.639	-000.041	001.527	003.812	-000.439	
-001.639	-000.041	001.066	-000.317	-000.435	
-001.639	-000.041	001.066	-000.317	-000.420	
-001.639	-000.041	001.066	-000.317	-000.415	
-001.639	-000.041	000.805	000.021	-000.408	
-001.639	-000.041	000.805	000.021	-000.404	
-001.639	-000.041	000.805	000.021	-000.398	
-001.639	-000.041	000.671	000.272	-000.396	
-001.639	-000.041	000.671	000.272	-000.396	
-001.639	-000.041	000.671	000.272	-000.392	
-001.639	-000.041	000.509	000.021	-000.389	
-001.639	-000.041	000.509	000.021	-000.384	
-001.639	-000.041	000.509	000.021	-000.378	
-001.639	-000.041	000.471	000.356	-000.369	
-001.639	-000.041	000.471	000.356	-000.361	
-001.639	-000.041	000.471	000.356	-000.359	
-001.639	-000.041	000.442	000.356	-000.353	
-001.639	-000.041	000.442	000.356	-000.347	
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
-001.639	-000.041	000.567	000.187	-002.193	
-001.639	-000.041	000.567	000.187	-002.388	
-001.639	-000.041	000.493	000.272	-002.578	
-001.639	-000.041	000.493	000.272	-002.753	
-001.639	-000.041	000.493	000.272	-002.908	
-001.639	-000.041	000.543	000.694	-003.048	
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
