phong1990/fufo-innovation/Document/04.Design/FUFO_FUFO/Filter/Sample_Data/TestSetpoint/TestSetpoint 20h43.txt

-001.619	-000.159	000.000	000.000	000.500	
-001.619	-000.159	000.000	000.000	000.500	
-001.619	-000.159	000.000	000.000	000.500	
-001.619	-000.159	000.012	000.012	000.500	
-001.619	-000.159	000.012	000.012	000.500	
-001.619	-000.159	000.012	000.012	000.500	
-001.619	-000.159	-000.465	-000.465	000.500	
-001.619	-000.159	-000.465	002.034	000.500	
-001.619	-000.159	-000.465	002.034	000.500	
-001.619	-000.159	-000.465	002.034	000.500	
-001.619	-000.159	002.623	002.623	000.500	
-001.619	-000.159	002.623	002.623	000.500	
-001.619	-000.159	002.623	002.623	000.500	
-001.619	-000.159	002.623	002.623	000.500	
-001.619	-000.159	002.623	002.623	000.500	
-001.619	-000.159	002.623	002.623	000.500	
-001.619	-000.159	-000.912	-000.912	000.500	
-001.619	-000.159	-000.912	-000.912	000.500	
-001.619	-000.159	-000.912	-000.912	000.500	
-001.619	-000.159	-000.912	-000.912	000.500	
-001.619	-000.159	-000.912	-000.407	000.500	
-001.619	-000.159	-000.912	-000.407	000.500	
-001.619	-000.159	-000.912	-000.407	000.500	
-001.619	-000.159	-000.407	-000.407	000.500	
-001.619	-000.159	-000.407	-000.745	000.500	
-001.619	-000.159	-000.407	-000.745	000.500	
-001.619	-000.159	-000.407	-000.745	000.500	
-001.619	-000.159	-000.745	-000.745	000.500	
-001.619	-000.159	-000.745	-000.491	000.500	
-001.619	-000.159	-000.745	-000.491	000.500	
-001.619	-000.159	-000.745	-000.491	000.500	
-001.619	-000.159	-000.491	-000.491	000.500	
-001.619	-000.159	-000.491	-000.238	000.500	
-001.619	-000.159	-000.491	-000.238	000.500	
-001.619	-000.159	-000.491	-000.238	000.500	
-001.619	-000.159	-000.238	-000.238	000.500	
-001.619	-000.159	-000.238	-000.238	000.500	
-001.619	-000.159	-000.238	-000.238	000.500	
-001.619	-000.159	-000.238	-000.238	000.500	
-001.619	-000.159	-000.238	-000.912	000.500	
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
