phong1990/fufo-innovation/Document/04.Design/FUFO_FUFO/Filter/Sample_Data/TestSetpoint/TestSetpoint 20h29.txt

-001.539	-000.079	000.000	001.133	000.450	
-001.539	-000.079	000.000	001.040	000.450	
-001.539	-000.079	000.000	000.959	000.450	
-001.539	-000.079	-000.315	000.893	000.450	
-001.539	-000.079	-000.315	000.778	000.450	
-001.539	-000.079	-000.315	000.593	000.450	
-001.539	-000.079	-000.400	000.583	000.450	
-001.539	-000.079	-000.400	000.656	000.450	
-001.539	-000.079	-000.400	000.699	000.450	
-001.539	-000.079	-000.231	000.551	000.450	
-001.539	-000.079	-000.231	000.356	000.450	
-001.539	-000.079	-000.231	000.435	000.450	
-001.539	-000.079	-000.231	000.485	000.450	
-001.539	-000.079	-000.231	000.504	000.450	
-001.539	-000.079	-000.231	000.339	000.450	
-001.539	-000.079	-000.315	000.144	000.450	
-001.539	-000.079	-000.315	000.179	000.450	
-001.539	-000.079	-000.315	000.242	000.450	
-001.539	-000.079	000.273	000.281	000.450	
-001.539	-000.079	000.273	000.159	000.450	
-001.539	-000.079	000.273	-000.028	000.450	
-001.539	-000.079	000.188	-000.141	000.450	
-001.539	-000.079	000.188	-000.039	000.450	
-001.539	-000.079	000.188	000.022	000.450	
-001.539	-000.079	000.439	000.037	000.450	
-001.539	-000.079	000.439	-000.118	000.450	
-001.539	-000.079	000.439	-000.298	000.450	
-001.539	-000.079	000.862	-000.316	000.450	
-001.539	-000.079	000.862	-000.234	000.450	
-001.539	-000.079	000.862	-000.183	000.450	
-001.539	-000.079	000.862	-000.153	000.450	
-001.539	-000.079	000.862	-000.275	000.450	
-001.539	-000.079	000.862	-000.454	000.450	
-001.539	-000.079	-000.064	-000.466	000.450	
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
-001.539	-000.079	000.524	-001.538	000.450	
-001.539	-000.079	000.524	-001.445	000.450	
-001.539	-000.079	000.524	-001.362	000.450	
-001.539	-000.079	000.524	-001.362	000.450	
-001.539	-000.079	000.524	-001.498	000.450	
-001.539	-000.079	000.524	-001.628	000.450	
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
