phong1990/fufo-innovation/Document/04.Design/FUFO_FUFO/Filter/Sample_Data/TestAltitude-08-16-2012/TestAz 13h46.txt

-023.384	
-023.488	
-022.964	
-023.698	
-023.908	
-023.593	
-023.279	
-023.698	
-023.488	
-023.279	
-023.279	
-023.488	
-023.488	
-023.384	
-023.384	
-023.593	
-023.384	
-023.069	
-023.384	
-023.908	
-023.279	
-023.069	
-023.384	
-023.488	
-023.384	
-023.488	
-023.174	
-023.279	
-023.279	
-023.488	
-023.593	
-023.593	
-023.279	
-023.593	
-023.384	
-023.384	
-023.174	
-024.223	
-023.174	
-022.440	
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
