phong1990/fufo-innovation/Document/04.Design/FUFO_FUFO/Filter/Sample_Data/TestAltitude/TestAltitude10h47.txt

000.000	000.000	000.000	
-000.292	000.003	000.166	
008.616	000.015	000.403	
008.532	000.034	000.625	
008.532	000.061	000.836	
-000.208	000.095	001.034	
-000.039	000.137	001.220	
000.042	000.187	001.395	
000.380	000.245	001.563	
000.547	000.310	001.719	
000.547	000.383	001.866	
000.211	000.464	002.005	
000.631	000.552	002.134	
000.631	000.648	002.258	
000.631	000.752	002.372	
001.052	000.863	002.480	
001.052	000.982	002.583	
000.547	001.109	002.680	
000.631	001.243	002.770	
000.716	001.385	002.855	
000.462	001.535	002.936	
000.547	001.692	003.013	
000.547	001.857	003.085	
000.211	002.030	003.152	
000.042	002.210	003.214	
000.462	002.398	003.275	
000.631	002.594	003.331	
000.296	002.798	003.384	
000.296	003.009	003.434	
000.631	003.228	003.481	
000.296	003.454	003.526	
000.380	003.688	003.568	
000.380	003.930	003.608	
000.547	004.180	003.646	
000.547	004.437	003.681	
-000.123	004.702	003.714	
000.211	004.975	003.746	
000.631	005.255	003.776	
000.716	005.543	003.804	
000.211	005.839	003.829	
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
000.631	dd570006.435	006.244	
000.462	jd570018.836	006.245	
000.631	jd570031.245	006.246	
000.631	rd570043.661	006.247	
000.631	jd570056.086	006.249	
000.547	jd570068.518	006.250	
000.882	nd570080.957	006.250	
000.882	pd570093.405	006.251	
000.631	dd570105.859	006.253	
000.882	jd570118.322	006.253	
000.882	rd570130.793	006.255	
000.631	jd570143.271	006.257	
000.631	rd570155.757	006.259	
000.716	jd570168.250	006.261	
000.716	dd570180.751	006.263	
000.547	jd570193.261	006.265	
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
001.052	jd592685.192	008.448	
001.221	hd592710.828	008.449	
001.221	jd592736.468	008.450	
001.221	hd592762.120	008.450	
001.052	dd592787.780	008.452	
000.967	jd592813.444	008.453	
001.221	dd592839.120	008.455	
001.305	dd592864.804	008.456	
001.305	dd592890.492	008.458
