phong1990/fufo-innovation/Document/04.Design/FUFO_FUFO/Filter/Sample_Data/TestAltitude/TestAltitude8h59.txt

000.000	000.000	000.000	
-000.531	-000.000	-000.024	
002.998	-000.002	-000.059	
002.998	-000.005	-000.093	
002.998	-000.009	-000.123	
-000.531	-000.014	-000.152	
-000.531	-000.020	-000.178	
-000.531	-000.027	-000.205	
000.139	-000.036	-000.230	
000.560	-000.045	-000.253	
000.560	-000.056	-000.274	
000.058	-000.068	-000.294	
-000.111	-000.081	-000.313	
000.393	-000.095	-000.331	
-000.026	-000.110	-000.349	
-000.026	-000.127	-000.366	
-000.026	-000.144	-000.382	
-000.866	-000.163	-000.396	
-000.446	-000.183	-000.410	
-000.277	-000.204	-000.422	
-000.111	-000.226	-000.434	
-000.531	-000.249	-000.442	
-000.531	-000.273	-000.453	
-001.035	-000.299	-000.463	
-000.615	-000.325	-000.472	
-000.615	-000.353	-000.481	
-000.446	-000.382	-000.491	
-000.362	-000.412	-000.499	
-000.362	-000.443	-000.506	
-000.866	-000.475	-000.513	
-000.277	-000.509	-000.519	
-000.362	-000.543	-000.526	
-000.277	-000.579	-000.533	
-000.362	-000.616	-000.538	
-000.362	-000.654	-000.545	
-000.531	-000.693	-000.549	
-000.362	-000.733	-000.554	
-000.111	-000.775	-000.557	
-000.195	-000.817	-000.561	
-000.195	-000.861	-000.566	
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
000.393	-jd570004.600	-001.443	
000.644	-jd570009.325	-001.445	
000.813	-dd570014.054	-001.445	
000.729	-dd570018.782	-001.444	
000.980	-dd570023.513	-001.443	
000.980	-dd570028.244	-001.441	
000.139	-dd570032.976	-001.440	
000.729	-dd570037.710	-001.440	
000.729	-dd570042.444	-001.439	
000.478	-dd570047.181	-001.441	
000.980	-dd570051.918	-001.440	
000.980	-jd570056.655	-001.440	
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
000.058	-jd575973.680	-001.619	
000.224	-rd575979.681	-001.620	
-000.111	-jd575985.684	-001.621	
-000.111	-jd575991.687	-001.620	
-000.111	-jd575997.692	-001.621	
000.393	-pd576003.698	-001.623	
-000.026	-jd576009.705	-001.623	
-000.195	-jd576015.714	-001.624	
-000.195	-jd576021.723	-001.623
