phong1990/fufo-innovation/Document/04.Design/FUFO_FUFO/Filter/Sample_Data/TestAltitude/TestAltitude21h50.txt

-000.929	-000.190	000.000	000.509	-000.132	
-000.929	-000.190	000.000	000.508	-000.134	
-000.929	-000.190	000.000	000.508	-000.137	
-000.929	-000.190	000.000	000.507	-000.138	
-000.929	-000.190	000.001	000.506	-000.140	
-000.929	-000.190	000.001	000.504	-000.142	
-000.929	-000.190	000.001	000.503	-000.144	
-000.929	-000.190	000.001	000.502	-000.145	
-000.929	-000.190	000.001	000.501	-000.148	
-000.929	-000.190	000.001	000.501	-000.150	
-000.929	-000.190	000.001	000.500	-000.152	
-000.929	-000.190	000.001	000.501	-000.154	
-000.929	-000.190	000.001	000.500	-000.156	
-000.929	-000.190	000.002	000.500	-000.159	
-000.929	-000.190	000.002	000.501	-000.160	
-000.929	-000.190	000.002	000.501	-000.162	
-000.929	-000.190	000.002	000.500	-000.164	
-000.929	-000.190	000.002	000.498	-000.165	
-000.929	-000.190	000.002	000.497	-000.167	
-000.929	-000.190	000.002	000.496	-000.168	
-000.929	-000.190	000.002	000.495	-000.171	
-000.929	-000.190	000.002	000.495	-000.173	
-000.929	-000.190	000.002	000.495	-000.174	
-000.929	-000.190	000.002	000.494	-000.176	
-000.929	-000.190	000.002	000.494	-000.178	
-000.929	-000.190	000.002	000.493	-000.179	
-000.929	-000.190	000.002	000.492	-000.181	
-000.929	-000.190	000.002	000.491	-000.182	
-000.929	-000.190	000.002	000.490	-000.183	
-000.929	-000.190	000.003	000.490	-000.184	
-000.929	-000.190	000.003	000.489	-000.185	
-000.929	-000.190	000.003	000.488	-000.186	
-000.929	-000.190	000.003	000.488	-000.187	
-000.929	-000.190	000.002	000.487	-000.188	
-000.929	-000.190	000.003	000.487	-000.188	
-000.929	-000.190	000.002	000.486	-000.190	
-000.929	-000.190	000.003	000.486	-000.189	
-000.929	-000.190	000.003	000.486	-000.190	
-000.929	-000.190	000.003	000.485	-000.191	
-000.929	-000.190	000.003	000.484	-000.192	
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
