phong1990/fufo-innovation/Document/04.Design/FUFO_FUFO/Filter/Sample_Data/TestSetpoint/TestSetpoint 11h22.txt

0	0	0	0.011	-0.018
0	0	0	0.01	-0.016
0	0	0	0.01	-0.016
0	0	-0.007	0.01	-0.016
0	0	-0.007	0.009	-0.016
0	0	-0.007	0.009	-0.016
0	0	0.144	0.008	-0.016
0	0	0.144	0.007	-0.016
0	0	0.144	0.006	-0.016
0	0	0.297	0.005	-0.016
0	0	0.297	0.005	-0.015
0	0	0.297	0.006	-0.015
0	0	0.447	0.006	-0.015
0	0	0.447	0.007	-0.014
0	0	0.447	0.007	-0.014
0	0	0.411	0.007	-0.014
0	0	0.411	0.007	-0.014
0	0	0.411	0.006	-0.014
0	0	0.377	0.006	-0.014
0	0	0.377	0.005	-0.013
0	0	0.377	0.005	-0.013
0	0	0.342	0.005	-0.013
0	0	0.342	0.005	-0.012
0	0	0.342	0.005	-0.012
0	0	0.313	0.005	-0.011
0	0	0.313	0.005	-0.011
0	0	0.313	0.004	-0.011
0	0	0.283	0.004	-0.011
0	0	0.283	0.004	-0.011
0	0	0.283	0.003	-0.011
0	0	0.254	0.004	-0.011
0	0	0.254	0.005	-0.01
0	0	0.254	0.005	-0.01
0	0	0.225	0.005	-0.01
0	0	0.225	0.005	-0.01
0	0	0.225	0.005	-0.009
0	0	0.2	0.004	-0.01
0	0	0.2	0.004	-0.01
0	0	0.2	0.003	-0.009
0	0	0.172	0.003	-0.009
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
