phong1990/fufo-innovation/Document/04.Design/FUFO_FUFO/Filter/Sample_Data/TestAltitude/TestAltitude20h15.txt

-000.197,000.012,-000.000	
-000.197,000.012,-000.000	
-000.197,000.012,-000.000	
-000.197,000.012,-000.004	
-000.197,000.012,-000.004	
-000.197,000.012,-000.004	
-000.197,000.012,-000.103	
-000.197,000.012,-000.103	
-000.197,000.012,-000.103	
-000.197,000.012,-000.194	
-000.197,000.012,-000.194	
-000.197,000.012,-000.194	
-000.197,000.012,-000.282	
-000.197,000.012,-000.282	
-000.197,000.012,-000.282	
-000.197,000.012,-000.298	
-000.197,000.012,-000.298	
-000.197,000.012,-000.298	
-000.197,000.012,-000.314	
-000.197,000.012,-000.314	
-000.197,000.012,-000.314	
-000.197,000.012,-000.326	
-000.197,000.012,-000.326	
-000.197,000.012,-000.326	
-000.197,000.012,-000.339	
-000.197,000.012,-000.339	
-000.197,000.012,-000.339	
-000.197,000.012,-000.353	
-000.197,000.012,-000.353	
-000.197,000.012,-000.353	
-000.197,000.012,-000.366	
-000.197,000.012,-000.366	
-000.197,000.012,-000.366	
-000.197,000.012,-000.373	
-000.197,000.012,-000.373	
-000.197,000.012,-000.373	
-000.197,000.012,-000.378	
-000.197,000.012,-000.378	
-000.197,000.012,-000.378	
-000.197,000.012,-000.383	
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
GG-000.197,000.012,-001.210
