phong1990/fufo-innovation/Document/04.Design/FUFO_FUFO/Filter/Sample_Data/TestAltitude/TestAltitude20h07.txt

-000.197,000.012,-000.000	
-000.197,000.012,-000.000	
-000.197,000.012,-000.000	
-000.197,000.012,000.001	
-000.197,000.012,000.001	
-000.197,000.012,000.001	
-000.197,000.012,-000.045	
-000.197,000.012,-000.045	
-000.197,000.012,-000.045	
-000.197,000.012,-000.090	
-000.197,000.012,-000.090	
-000.197,000.012,-000.090	
-000.197,000.012,-000.133	
-000.197,000.012,-000.133	
-000.197,000.012,-000.133	
-000.197,000.012,-000.121	
-000.197,000.012,-000.121	
-000.197,000.012,-000.121	
-000.197,000.012,-000.107	
-000.197,000.012,-000.107	
-000.197,000.012,-000.107	
-000.197,000.012,-000.093	
-000.197,000.012,-000.093	
-000.197,000.012,-000.093	
-000.197,000.012,-000.073	
-000.197,000.012,-000.073	
-000.197,000.012,-000.073	
-000.197,000.012,-000.050	
-000.197,000.012,-000.050	
-000.197,000.012,-000.050	
-000.197,000.012,-000.027	
-000.197,000.012,-000.027	
-000.197,000.012,-000.027	
-000.197,000.012,-000.017	
-000.197,000.012,-000.017	
-000.197,000.012,-000.017	
-000.197,000.012,-000.011	
-000.197,000.012,-000.011	
-000.197,000.012,-000.011	
-000.197,000.012,000.003	
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
GG-000.197,000.012,000.835	
-000.197,000.012,-000.000	
-000.197,000.012,-000.000	
-000.197,000.012,-000.000	
-000.197,000.012,-000.004	
-000.197,000.012,-000.004	
-000.197,000.012,-000.004	
-000.197,000.012,000.030	
-000.197,000.012,000.030	
-000.197,000.012,000.030	
-000.197,000.012,000.066	
-000.197,000.012,000.066	
-000.197,000.012,000.066	
-000.197,000.012,000.101	
-000.197,000.012,000.101	
-000.197,000.012,000.101	
-000.197,000.012,000.091	
-000.197,000.012,000.091	
-000.197,000.012,000.091	
-000.197,000.012,000.092	
-000.197,000.012,000.092	
-000.197,000.012,000.092	
-000.197,000.012,000.103	
-000.197,000.012,000.103	
-000.197,000.012,000.103	
-000.197,000.012,000.115	
-000.197,000.012,000.115	
-000.197,000.012,000.115	
-000.197,000.012,000.121	
-000.197,000.012,000.121	
-000.197,000.012,000.121	
-000.197,000.012,000.126	
-000.197,000.012,000.126	
-000.197,000.012,000.126	
-000.197,000.012,000.123	
-000.197,000.012,000.123	
-000.197,000.012,000.123	
-000.197,000.012,000.115	
-000.197,000.012,000.115	
-000.197,000.012,000.115	
-000.197,000.012,000.113	
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
