phong1990/fufo-innovation/Document/04.Design/FUFO_FUFO/Filter/Sample_Data/TestAltitude/TestAltitude14h14.txt

-000.247,000.012,-000.016	
-000.247,000.012,-000.016	
-000.247,000.012,-000.016	
-000.247,000.012,-000.032	
-000.247,000.012,-000.032	
-000.247,000.012,-000.032	
-000.247,000.012,-000.045	
-000.247,000.012,-000.045	
-000.247,000.012,-000.045	
-000.247,000.012,-000.061	
-000.247,000.012,-000.061	
-000.247,000.012,-000.061	
-000.247,000.012,-000.076	
-000.247,000.012,-000.076	
-000.247,000.012,-000.076	
-000.247,000.012,-000.095	
-000.247,000.012,-000.095	
-000.247,000.012,-000.095	
-000.247,000.012,-000.104	
-000.247,000.012,-000.104	
-000.247,000.012,-000.104	
-000.247,000.012,-000.114	
-000.247,000.012,-000.114	
-000.247,000.012,-000.114	
-000.247,000.012,-000.125	
-000.247,000.012,-000.125	
-000.247,000.012,-000.125	
-000.247,000.012,-000.130	
-000.247,000.012,-000.130	
-000.247,000.012,-000.130	
-000.247,000.012,-000.136	
-000.247,000.012,-000.136	
-000.247,000.012,-000.136	
-000.247,000.012,-000.140	
-000.247,000.012,-000.140	
-000.247,000.012,-000.140	
-000.247,000.012,-000.142	
-000.247,000.012,-000.142	
-000.247,000.012,-000.142	
-000.247,000.012,-000.144	
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
