phong1990/fufo-innovation/Document/04.Design/FUFO_FUFO/Filter/Sample_Data/TestPID-08-13-2012/TestPID17h30.txt

000.005	000.000	000.500	
000.005	000.000	000.500	
000.006	000.000	000.500	
000.005	000.000	000.500	
000.005	000.000	000.500	
000.004	000.000	000.500	
000.004	000.000	000.500	
000.004	000.000	000.500	
000.004	000.000	000.500	
000.003	000.000	000.500	
000.003	000.000	000.500	
000.002	000.000	000.500	
000.002	000.000	000.500	
000.002	000.000	000.500	
000.002	000.000	000.500	
000.001	000.000	000.500	
000.000	000.000	000.500	
000.000	000.000	000.500	
000.000	000.000	000.500	
000.000	000.000	000.500	
000.000	000.000	000.500	
000.000	000.000	000.500	
-000.000	000.000	000.500	
-000.000	000.000	000.500	
-000.000	000.000	000.500	
000.000	000.000	000.500	
000.000	000.000	000.500	
000.000	000.000	000.500	
000.000	000.000	000.500	
-000.000	000.000	000.500	
-000.000	000.000	000.500	
000.000	000.000	000.500	
000.000	000.000	000.500	
-000.000	000.000	000.500	
-000.000	000.000	000.500	
-000.001	000.000	000.500	
-000.000	000.000	000.500	
-000.001	000.000	000.500	
-000.001	000.000	000.500	
-000.002	000.000	000.500	
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
