phong1990/fufo-innovation/Document/04.Design/FUFO_FUFO/Filter/Sample_Data/TestPID-08-13-2012/TestPD12h00.txt

-000.028	000.000	001.050	
-000.028	000.000	001.050	
-000.028	000.000	001.050	
-000.028	000.000	001.050	
-000.029	000.000	001.050	
-000.029	000.000	001.050	
-000.030	000.000	001.050	
-000.029	000.000	001.050	
-000.029	000.000	001.050	
-000.028	000.000	001.050	
-000.026	000.000	001.050	
-000.025	000.000	001.050	
-000.024	000.000	001.050	
-000.024	000.000	001.050	
-000.023	000.000	001.050	
-000.022	000.000	001.050	
-000.021	000.000	001.050	
-000.019	000.000	001.050	
-000.019	000.000	001.050	
-000.019	000.000	001.050	
-000.018	000.000	001.050	
-000.017	000.000	001.050	
-000.018	000.000	001.050	
-000.018	000.000	001.050	
-000.018	000.000	001.050	
-000.018	000.000	001.050	
-000.019	000.000	001.050	
-000.020	000.000	001.050	
-000.020	000.000	001.050	
-000.021	000.000	001.050	
-000.021	000.000	001.050	
-000.020	000.000	001.050	
-000.020	000.000	001.050	
-000.019	000.000	001.050	
-000.019	000.000	001.050	
-000.018	000.000	001.050	
-000.018	000.000	001.050	
-000.018	000.000	001.050	
-000.017	000.000	001.050	
-000.017	000.000	001.050	
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
