phong1990/fufo-innovation/Document/04.Design/FUFO_FUFO/Filter/Sample_Data/TestPID-08-13-2012/TestPD11h42.txt

000.001	000.000	000.000	
000.001	000.000	000.000	
000.001	000.000	000.000	
000.000	000.000	000.000	
000.000	000.000	000.000	
000.001	000.000	000.000	
000.000	000.000	000.000	
000.000	000.000	000.000	
000.000	000.000	000.000	
000.001	000.000	000.000	
000.001	000.000	000.000	
000.000	000.000	000.000	
000.000	000.000	000.000	
000.001	000.000	000.000	
000.001	000.000	000.000	
000.000	000.000	000.000	
000.000	000.000	000.000	
000.000	000.000	000.000	
000.000	000.000	000.000	
000.000	000.000	000.000	
000.000	000.000	000.000	
000.000	000.000	000.000	
000.000	000.000	000.000	
000.000	000.000	000.000	
000.000	000.000	000.000	
000.000	000.000	000.000	
000.000	000.000	000.000	
000.000	000.000	000.000	
000.000	000.000	000.000	
-000.000	000.000	000.000	
-000.000	000.000	000.000	
000.000	000.000	000.000	
000.000	000.000	000.000	
000.000	000.000	000.000	
-000.000	000.000	000.000	
-000.000	000.000	000.000	
000.000	000.000	000.000	
000.000	000.000	000.000	
000.000	000.000	000.000	
000.000	000.000	000.000	
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
