phong1990/fufo-innovation/Document/04.Design/FUFO_FUFO/Filter/Sample_Data/TestPID-08-13-2012/testD10h56.txt

013.728	000.000	000.500	
013.680	000.000	000.500	
013.088	000.000	000.500	
012.555	000.000	000.500	
011.944	000.000	000.500	
011.704	000.000	000.500	
011.717	000.000	000.500	
011.727	000.000	000.500	
011.503	000.000	000.500	
010.910	000.000	000.500	
010.245	000.000	000.500	
009.850	000.000	000.500	
009.788	000.000	000.500	
009.656	000.000	000.500	
009.084	000.000	000.500	
008.427	000.000	000.500	
007.930	000.000	000.500	
007.766	000.000	000.500	
008.036	000.000	000.500	
008.354	000.000	000.500	
008.225	000.000	000.500	
007.598	000.000	000.500	
006.788	000.000	000.500	
006.068	000.000	000.500	
006.002	000.000	000.500	
006.261	000.000	000.500	
006.540	000.000	000.500	
006.416	000.000	000.500	
005.910	000.000	000.500	
005.248	000.000	000.500	
004.774	000.000	000.500	
004.692	000.000	000.500	
004.608	000.000	000.500	
004.762	000.000	000.500	
004.710	000.000	000.500	
004.159	000.000	000.500	
003.397	000.000	000.500	
003.017	000.000	000.500	
003.072	000.000	000.500	
003.179	000.000	000.500	
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
