phong1990/fufo-innovation/Document/04.Design/FUFO_FUFO/Filter/Sample_Data/TestPID-08-12/testPID 15h00.txt

-005.323	000.000	001.000	
-005.465	000.000	001.000	
-005.274	000.000	001.000	
-005.225	000.000	001.000	
-005.262	000.000	001.000	
-005.187	000.000	001.000	
-005.083	000.000	001.000	
-004.961	000.000	001.000	
-004.980	000.000	001.000	
-004.636	000.000	001.000	
-004.461	000.000	001.000	
-003.969	000.000	001.000	
-003.621	000.000	001.000	
-003.387	000.000	001.000	
-003.025	000.000	001.000	
-002.826	000.000	001.000	
-002.521	000.000	001.000	
-002.280	000.000	001.000	
-002.144	000.000	001.000	
-002.173	000.000	001.000	
-002.412	000.000	001.000	
-002.582	000.000	001.000	
-002.741	000.000	001.000	
-002.881	000.000	001.000	
-003.050	000.000	001.000	
-003.130	000.000	001.000	
-003.244	000.000	001.000	
-003.118	000.000	001.000	
-003.269	000.000	001.000	
-003.099	000.000	001.000	
-002.833	000.000	001.000	
-002.567	000.000	001.000	
-002.437	000.000	001.000	
-002.180	000.000	001.000	
-002.009	000.000	001.000	
-001.752	000.000	001.000	
-001.599	000.000	001.000	
-001.475	000.000	001.000	
-001.374	000.000	001.000	
-001.389	000.000	001.000	
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
