phong1990/fufo-innovation/Document/04.Design/FUFO_FUFO/Filter/Sample_Data/TestPID-08-12/testD 11h50.txt

-003.326	000.000	000.000	
-003.311	000.000	000.000	
-003.086	000.000	000.000	
-003.184	000.000	000.000	
-003.164	000.000	000.000	
-003.048	000.000	000.000	
-003.131	000.000	000.000	
-003.200	000.000	000.000	
-003.287	000.000	000.000	
-003.303	000.000	000.000	
-003.071	000.000	000.000	
-003.074	000.000	000.000	
-003.130	000.000	000.000	
-002.921	000.000	000.000	
-002.948	000.000	000.000	
-002.845	000.000	000.000	
-002.675	000.000	000.000	
-002.712	000.000	000.000	
-002.522	000.000	000.000	
-002.320	000.000	000.000	
-002.432	000.000	000.000	
-002.261	000.000	000.000	
-002.295	000.000	000.000	
-002.334	000.000	000.000	
-002.116	000.000	000.000	
-002.038	000.000	000.000	
-001.933	000.000	000.000	
-001.765	000.000	000.000	
-001.711	000.000	000.000	
-001.649	000.000	000.000	
-001.452	000.000	000.000	
-001.388	000.000	000.000	
-001.202	000.000	000.000	
-001.144	000.000	000.000	
-001.148	000.000	000.000	
-001.031	000.000	000.000	
-001.019	000.000	000.000	
-000.903	000.000	000.000	
-000.709	000.000	000.000	
-000.774	000.000	000.000	
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
