phong1990/fufo-innovation/Document/04.Design/FUFO_FUFO/Filter/Sample_Data/7-28-2012/status16h40(test setpoint).txt

-000.002	000.000	000.000	
-000.002	000.000	000.000	
-000.002	000.000	000.000	
-000.003	-000.200	-000.400	
-000.003	-000.200	-000.400	
-000.004	-000.200	-000.400	
-000.005	-000.200	-000.400	
-000.005	-000.200	-000.400	
-000.006	-000.200	-000.400	
-000.006	-000.200	-000.400	
-000.006	-000.200	-000.400	
-000.006	-000.200	-000.400	
-000.006	-000.200	-000.400	
-000.005	-000.200	-000.400	
-000.005	-000.200	-000.400	
-000.004	-000.200	-000.400	
-000.004	-000.200	-000.400	
-000.003	-000.200	-000.400	
-000.003	-000.200	-000.400	
-000.003	-000.200	-000.400	
-000.003	-000.200	-000.400	
-000.003	-000.200	-000.400	
-000.003	-000.200	-000.400	
-000.003	-000.200	-000.400	
-000.003	-000.200	-000.400	
-000.003	-000.200	-000.400	
-000.004	-000.200	-000.400	
-000.004	-000.200	-000.400	
-000.004	-000.200	-000.400	
-000.005	-000.200	-000.400	
-000.005	-000.200	-000.400	
-000.005	-000.200	-000.400	
-000.005	-000.200	-000.400	
-000.005	-000.200	-000.400	
-000.004	-000.200	-000.400	
-000.004	-000.200	-000.400	
-000.004	-000.200	-000.400	
-000.004	-000.200	-000.400	
-000.004	-000.200	-000.400	
-000.003	-000.200	-000.400	
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
