phong1990/fufo-innovation/Document/04.Design/FUFO_FUFO/Filter/Sample_Data/7-18-2012/testPID, tang Kd.txt

000.022	012.080	012.960	000.037	
000.021	012.038	013.002	000.037	
000.021	012.036	013.004	000.037	
000.021	012.036	013.004	000.037	
000.021	012.036	013.004	000.037	
000.022	012.036	013.004	000.037	
000.022	012.036	013.004	000.037	
000.022	012.038	013.002	000.037	
000.022	012.042	012.998	000.037	
000.023	012.050	012.990	000.037	
000.023	012.056	012.984	000.037	
000.024	012.062	012.978	000.037	
000.025	012.062	012.978	000.037	
000.026	012.064	012.976	000.037	
000.027	012.068	012.972	000.037	
000.028	012.072	012.968	000.037	
000.029	012.074	012.966	000.037	
000.030	012.076	012.964	000.037	
000.030	012.074	012.966	000.037	
000.030	012.072	012.968	000.037	
000.030	012.074	012.966	000.037	
000.030	012.064	012.976	000.037	
000.030	012.060	012.980	000.037	
000.030	012.054	012.986	000.037	
000.030	012.048	012.992	000.037	
000.029	012.044	012.996	000.037	
000.029	012.042	012.998	000.037	
000.029	012.038	013.002	000.037	
000.028	012.034	013.006	000.037	
000.027	012.034	013.006	000.037	
000.026	012.032	013.008	000.037	
000.025	012.030	013.010	000.037	
000.023	012.032	013.008	000.037	
000.022	012.040	013.000	000.037	
000.020	012.044	012.996	000.037	
000.019	012.048	012.992	000.037	
000.018	012.048	012.992	000.037	
000.017	012.052	012.988	000.037	
000.017	012.052	012.988	000.037	
000.016	012.056	012.984	000.037	
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

-000.005	012.056	012.984	000.036	
-000.006	012.062	012.978	000.036	
-000.007	012.062	012.978	000.036	
-000.007	012.064	012.976	000.036	
-000.008	012.070	012.970	000.036	
-000.009	012.066	012.974	000.036	
-000.009	012.074	012.966	000.036	
-000.010	012.066	012.974	000.036	
-000.010	012.072	012.968	000.036	
-000.010	012.072	012.968	000.036	
-000.010	012.064	012.976	000.036	
-000.009	012.056	012.984	000.036	
-000.009	012.050	012.990	000.036	
-000.008	012.044	012.996	000.036	
-000.007	012.038	013.002	000.036	
-000.006	012.032	013.008	000.036	
-000.005	012.024	013.016	000.036	
-000.004	012.018	013.022	000.036	
-000.003	012.012	013.028	000.036	
-000.003	012.008	013.032	000.036	
-000.002	012.008	013.032	000.036	
-000.002	012.006	013.034	000.036	
-000.001	012.000	013.040	000.036	
-000.000	011.998	013.042	000.036	
-000.000	012.000	013.040	000.036	
000.000	012.000	013.040	000.036	
000.001	012.000	013.040	000.036	
000.002	011.994	013.046	000.036	
000.002	012.000	013.040	000.036	
000.002	011.996	013.044	000.036	
000.003	012.000	013.040	000.036	
000.003	012.000	013.040	000.036	
000.003	011.998	013.042	000.036	
000.003	012.002	013.038	000.036	
000.003	012.008	013.032	000.036	
000.003	012.008	013.032	000.036	
000.003	012.002	013.038	000.036	
000.002	012.004	013.036	000.036	
000.002	012.012	013.028	000.036	
000.001	012.012	013.028	000.036	
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
