phong1990/fufo-innovation/Document/04.Design/FUFO_FUFO/Filter/Sample_Data/7-18-2012/testKp(2.5-2.8)- 16h55p.txt

000.001;
000.002	011.680	012.600	000.025	
000.002	011.670	012.610	000.025	
000.001	011.668	012.612	000.025	
000.000	011.672	012.608	000.025	
-000.000	011.680	012.600	000.025	
-000.001	011.684	012.596	000.025	
-000.002	011.688	012.592	000.025	
-000.003	011.692	012.588	000.025	
-000.004	011.696	012.584	000.025	
-000.004	011.700	012.580	000.025	
-000.003	011.700	012.580	000.025	
-000.002	011.698	012.582	000.025	
-000.001	011.694	012.586	000.025	
-000.000	011.688	012.592	000.025	
000.000	011.682	012.598	000.025	
000.001	011.678	012.602	000.025	
000.003	011.672	012.608	000.025	
000.004	011.666	012.614	000.025	
000.005	011.658	012.622	000.025	
000.006	011.654	012.626	000.025	
000.006	011.650	012.630	000.025	
000.006	011.650	012.630	000.025	
000.006	011.650	012.630	000.025	
000.006	011.650	012.630	000.025	
000.006	011.650	012.630	000.025	
000.006	011.650	012.630	000.025	
000.006	011.650	012.630	000.025	
000.006	011.650	012.630	000.025	
000.006	011.650	012.630	000.025	
000.006	011.648	012.632	000.025	
000.007	011.646	012.634	000.025	
000.008	011.644	012.636	000.025	
000.008	011.640	012.640	000.025	
000.009	011.636	012.644	000.025	
000.010	011.632	012.648	000.025	
000.011	011.628	012.652	000.025	
000.012	011.622	012.658	000.025	
000.013	011.618	012.662	000.025	
000.013	011.614	012.666	000.025	
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
