phong1990/fufo-innovation/Document/05.Test Case/UT/FUFO_Project_UnitTest_FUFO_v1.0.xls

Sheet: For summary
Number of pages | 5
Total | 25 | 25 | 0 | 0 | 25 | 100%
 | Number of checkitems
Sheet name |  | Normal | Abnormal | Boundary | Number of tested checkitems | Tested rate
FUFO_Main() | 9 | 9 | 0 | 0 | 9 | 100%
FUFO_initTMR2(void) | 1 | 1 | 0 | 0 | 1 | 100%
FUFO_initTMR3(void) | 1 | 1 | 0 | 0 | 1 | 100%
FUFO__attribute__ | 1 | 1 | 0 | 0 | 1 | 100%
FUFO_calculate | 11 | 11 | 0 | 0 | 11 | 100%
FUFO_coordinate | 2 | 2 | 0 | 0 | 2 | 100%

Sheet: FUFO_Main()
Matrix checklist |  |  | Title |  |  |  |  | int main(void)
Check condition/Confirmation content |  | Check ID | UT01-001 | UT01-002 | UT01-003 | UT01-004 | UT01-005 | UT01-006 | UT01-007 | UT01-008 | UT01-009
Check condition | Function int main(void) được gọi
 | Fake FUFO state for test:
 |  | 0 | o
 |  | 1 |  | o
 |  | 2 |  |  | o
 |  | 3 |  |  |  | o
 |  | 4 |  |  |  |  | o
 |  | 5 |  |  |  |  |  | o
 |  | 6 |  |  |  |  |  |  | o
 |  | 7 |  |  |  |  |  |  |  | o
 |  | 10 |  |  |  |  |  |  |  |  | o
Confirmation content | Setup FUFO to | Start | o
 |  | Waiting_for_connection |  | o
 |  | Verify |  |  | o
 |  | Pending |  |  |  | o
 |  | Setup |  |  |  |  | o
 |  | Ready |  |  |  |  |  | o
 |  | Hovering |  |  |  |  |  |  | o
 |  | Landing |  |  |  |  |  |  |  | o
 |  |  |  |  |  |  |  |  |  |  | o
 | Put Character to LCD | "Welcome to FUFO" |  | o
 |  | "Wait for connect" |  | o
 |  | "Choose connect!" |  |  | o
 |  | "Press Start " |  |  |  | o |  | o
 |  | "Press Up!" |  |  |  |  |  |  | o
 | Finish method |  | o | o | o | o | o | o | o | o | o
Normal(N) / Abnormal(E) / Boundary(L) |  |  | N | N | N | N | N | N | N | N | N
Confirmation date |  | On desk | 2012-08-10 | 2012-08-10 | 2012-08-10 | 2012-08-10 | 2012-08-10 | 2012-08-10 | 2012-08-10 | 2012-08-10 | 2012-08-10
 |  | Machine
Note |  |  | Creator |  |  |  |  | YenTT |  |  |  | Approver | PhongVM
 |  |  | Create date |  |  |  |  | 2012-08-05 |  |  |  | Approval date | 2012-08-10
 |  |  |  |  |  |  |  |  |  |  |  | Sheet number | 1 | 5

Sheet: FUFO_initTMR2(void)
Matrix checklist |  |  | Title | initTMR2(void)
Check condition/Confirmation content |  | Check ID | UT01-010
Check condition | No condition |  | o
Confirmation content | Check this function was call |  | o
Normal(N) / Abnormal(E) / Boundary(L) |  |  | N
Confirmation date |  | On desk | 2012-08-10
 |  | Machine
Note |  |  | Creator | YenTT | Approver | PhongVM
 |  |  | Create date | 2012-08-05 | Approval date | 2012-08-10
 |  |  |  |  | Sheet number | 2 | 5

Sheet: FUFO_initTMR3(void)
Matrix checklist |  |  | Title | initTMR3(void)
Check condition/Confirmation content |  | Check ID | UT01-010
Check condition | No condition |  | o
Confirmation content | Check this function was call |  | o
Normal(N) / Abnormal(E) / Boundary(L) |  |  | N
Confirmation date |  | On desk | 2012-08-10
 |  | Machine
Note |  |  | Creator | YenTT | Approver | PhongVM
 |  |  | Create date | 2012-08-05 | Approval date | 2012-08-10
 |  |  |  |  | Sheet number | 2 | 5

Sheet: FUFO__attribute__
Matrix checklist |  |  | Title | void __attribute__((__interrupt__ , auto_psv)) _T2Interrupt (void)
Check condition/Confirmation content |  | Check ID | UT01-011
Check condition | Confirm User input any value |  | o
Confirmation content | Set atribute for FUFO |  | o
Normal(N) / Abnormal(E) / Boundary(L) |  |  | N
Confirmation date |  | On desk | 2012-08-10
 |  | Machine
Note |  |  | Creator | YenTT | Approver | PhongVM
 |  |  | Create date | 2012-08-05 | Approval date | 2012-08-10
 |  |  |  |  | Sheet number | 4 | 5

Sheet: FUFO_calculate
Matrix checklist |  |  | Title |  |  |  |  | FUFO_calculate
Check condition/Confirmation content |  | Check ID | UT01-001 | UT01-002 | UT01-003 | UT01-004 | UT01-005 | UT01-006 | UT01-007 | UT01-008 | UT01-009
Check condition | Function int main(void) được gọi
 | Fake FUFO state for test:
 |  | 0 | o
 |  | 1 |  | o
 |  | 2 |  |  | o
 |  | 3 |  |  |  | o
 |  | 4 |  |  |  |  | o
 |  | 5 |  |  |  |  |  | o
 |  | 6 |  |  |  |  |  |  | o
 |  | 7 |  |  |  |  |  |  |  | o
 |  | 10 |  |  |  |  |  |  |  |  | o
Confirmation content | Setup FUFO to | Start | o
 |  | Waiting_for_connection |  | o
 |  | Verify |  |  | o
 |  | Pending |  |  |  | o
 |  | Setup |  |  |  |  | o
 |  | Ready |  |  |  |  |  | o
 |  | Hovering |  |  |  |  |  |  | o
 |  | Landing |  |  |  |  |  |  |  | o
 |  |  |  |  |  |  |  |  |  |  | o
 | Put Character to LCD | "Welcome to FUFO" |  | o
 |  | "Wait for connect" |  | o
 |  | "Choose connect!" |  |  | o
 |  | "Press Start " |  |  |  | o |  | o
 |  | "Press Up!" |  |  |  |  |  |  | o
 | Finish method |  | o | o | o | o | o | o | o | o | o
Normal(N) / Abnormal(E) / Boundary(L) |  |  | N | N | N | N | N | N | N | N | N
Confirmation date |  | On desk | 2012-08-10 | 2012-08-10 | 2012-08-10 | 2012-08-10 | 2012-08-10 | 2012-08-10 | 2012-08-10 | 2012-08-10 | 2012-08-10
 |  | Machine
Note |  |  | Creator |  |  |  |  | YenTT |  |  |  | Approver | PhongVM
 |  |  | Create date |  |  |  |  | 2012-08-05 |  |  |  | Approval date | 2012-08-10
 |  |  |  |  |  |  |  |  |  |  |  | Sheet number | 1 | 5

Sheet: FUFO_coordinate
Matrix checklist |  |  | Title |  |  |  |  | FUFO_coordinate
Check condition/Confirmation content |  | Check ID | UT01-001 | UT01-002 | UT01-003 | UT01-004 | UT01-005 | UT01-006 | UT01-007 | UT01-008 | UT01-009
Check condition | Function int main(void) được gọi
 | Fake FUFO state for test:
 |  | 0 | o
 |  | 1 |  | o
 |  | 2 |  |  | o
 |  | 3 |  |  |  | o
 |  | 4 |  |  |  |  | o
 |  | 5 |  |  |  |  |  | o
 |  | 6 |  |  |  |  |  |  | o
 |  | 7 |  |  |  |  |  |  |  | o
 |  | 10 |  |  |  |  |  |  |  |  | o
Confirmation content | Setup FUFO to | Start | o
 |  | Waiting_for_connection |  | o
 |  | Verify |  |  | o
 |  | Pending |  |  |  | o
 |  | Setup |  |  |  |  | o
 |  | Ready |  |  |  |  |  | o
 |  | Hovering |  |  |  |  |  |  | o
 |  | Landing |  |  |  |  |  |  |  | o
 |  |  |  |  |  |  |  |  |  |  | o
 | Put Character to LCD | "Welcome to FUFO" |  | o
 |  | "Wait for connect" |  | o
 |  | "Choose connect!" |  |  | o
 |  | "Press Start " |  |  |  | o |  | o
 |  | "Press Up!" |  |  |  |  |  |  | o
 | Finish method |  | o | o | o | o | o | o | o | o | o
Normal(N) / Abnormal(E) / Boundary(L) |  |  | N | N | N | N | N | N | N | N | N
Confirmation date |  | On desk | 2012-08-10 | 2012-08-10 | 2012-08-10 | 2012-08-10 | 2012-08-10 | 2012-08-10 | 2012-08-10 | 2012-08-10 | 2012-08-10
 |  | Machine
Note |  |  | Creator |  |  |  |  | YenTT |  |  |  | Approver | PhongVM
 |  |  | Create date |  |  |  |  | 2012-08-05 |  |  |  | Approval date | 2012-08-10
 |  |  |  |  |  |  |  |  |  |  |  | Sheet number | 1 | 5
