phong1990/fufo-innovation/Document/02.Template/FUFO_Issue_list_Template.xls

Sheet: Issue
 | Issue list
No. | Tiêu đề | Priority | Start date | Deadline | PIC | Nội dung | Ngày kết thúc | Status | Chú ý
1 | Issue 1 | A | 2010-10-19 | 2011-01-07 | Phongvm | Understanding: Video bị sai về kích thước yêu cầu. Problem: Hiểu thiếu mất yêu cầu này của khách hàng. Solution: sử dụng direct3d để viết custom allocator & presenter cho VMR9 | 2011-01-14 | Not Start
2 |  |  |  |  |  |  |  | Not Start
3 |  |  |  |  |  |  |  | Not Start
4 |  |  |  |  |  |  |  | Not Start
5 |  |  |  |  |  |  |  | Not Start
6 |  |  |  |  |  |  |  | Not Start
7 |  |  |  |  |  |  |  | Not Start
8 |  |  |  |  |  |  |  | Not Start
9 |  |  |  |  |  |  |  | Not Start
10 |  |  |  |  |  |  |  | Not Start
11 |  |  |  |  |  |  |  | Not Start
12 |  |  |  |  |  |  |  | Not Start
13 |  |  |  |  |  |  |  | Not Start
14 |  |  |  |  |  |  |  | Not Start
15 |  |  |  |  |  |  |  | Not Start
16 |  |  |  |  |  |  |  | Not Start
17 |  |  |  |  |  |  |  | Not Start
18 |  |  |  |  |  |  |  | Not Start
19 |  |  |  |  |  |  |  | Not Start
20 |  |  |  |  |  |  |  | Not Start
21 |  |  |  |  |  |  |  | Not Start
22 |  |  |  |  |  |  |  | Not Start
23 |  |  |  |  |  |  |  | Not Start
24 |  |  |  |  |  |  |  | Not Start
25 |  |  |  |  |  |  |  | Not Start
26 |  |  |  |  |  |  |  | Not Start
27 |  |  |  |  |  |  |  | Not Start
28 |  |  |  |  |  |  |  | Not Start
29 |  |  |  |  |  |  |  | Not Start
30 |  |  |  |  |  |  |  | Not Start
31 |  |  |  |  |  |  |  | Not Start
32 |  |  |  |  |  |  |  | Not Start
33 |  |  |  |  |  |  |  | Not Start
34 |  |  |  |  |  |  |  | Not Start
35 |  |  |  |  |  |  |  | Not Start
36 |  |  |  |  |  |  |  | Not Start
37 |  |  |  |  |  |  |  | Not Start
38 |  |  |  |  |  |  |  | Not Start
39 |  |  |  |  |  |  |  | Not Start
40 |  |  |  |  |  |  |  | Not Start
41 |  |  |  |  |  |  |  | Not Start
42 |  |  |  |  |  |  |  | Not Start
43 |  |  |  |  |  |  |  | Not Start
44 |  |  |  |  |  |  |  | Not Start
45 |  |  |  |  |  |  |  | Not Start
46 |  |  |  |  |  |  |  | Not Start
47 |  |  |  |  |  |  |  | Not Start
48 |  |  |  |  |  |  |  | Not Start
49 |  |  |  |  |  |  |  | Not Start
50 |  |  |  |  |  |  |  | Not Start
51 |  |  |  |  |  |  |  | Not Start
52 |  |  |  |  |  |  |  | Not Start
53 |  |  |  |  |  |  |  | Not Start
54 |  |  |  |  |  |  |  | Not Start
55 |  |  |  |  |  |  |  | Not Start
56 |  |  |  |  |  |  |  | Not Start

Sheet: Issue_JP
 | 課題管理表
No | 概要 | 優先度 | 開始日 | 期限 | PIC | 状況 | 終了年月日 | ステータス | 備考
1 | ウィンドウを広げてマルチスクリーンにまたがって表示させると、 1つのスクリーン(ウィンドウが最も面積を占めているスクリーン)に しか映像が出ず、残りのスクリーンには黒しか出ない | A | 2010-10-19 | 2011-01-07 | PhongVM TungNS | ・ウィンドウを広げてマルチスクリーンにまたがって表示させる機能を完了しました。 ・画像をより明らかに表示する目的にして設定を修正するためにプロトタイプしています。 対策：direct3dを使ってVMR9向けのcustom allocator & presenterを書きました。 | 2011-01-14 | Completed
2 | ショートカットのアイコンへのYUVファイルドラッグアンドドロップができない(起動後の画面へのドラッグアンドドロップは可能です) | A | 2010-10-19 | 2010-10-21 | PhongVM TungNS | 理解内容：ご指摘が分かりました。 問題：本要件が漏れてしまいました。 対策：コマンドラインからパスを取得しました。 | 2010-10-21 | Completed
3 | 再生中、Magを1/2や1/4などにしてウィンドウサイズを変更すると、 Mag=1相当の画像に変化してしまう | A | 2010-10-19 | 2010-10-21 | PhongVM TungNS | 理解内容：ご指摘が分かりました。 問題：このデモ版（１つの映像しか再生できない）では、このバグを検出していません。 対策：最新のデモ版（複数の映像を再生できた）では、ウィンドウサイズを変更する時、ズームの率を変更せず、そのままにして、本バグに対応しました。さらに、試験しました。 | 2010-10-19 | Completed
4 | RPTonで先頭に戻ると、Magに関係なく、画像サイズがウィンドウサイズにあわせられてしまう。（この画像サイズのウィンドウサイズフィット機能は不要です） | A | 2010-10-19 | 2010-10-21 | PhongVM TungNS | 理解内容：ご指摘が分かりました。 問題：このデモ版（１つの映像しか再生できない）では、このバグを検出していません。 対策：最新のデモ版（複数の映像を再生できた）では、リピートの時、ズームの率を変更せず、そのままにして、本バグに対応しました。さらに、試験しました。 | 2010-10-19 | Completed
5 | またRPTonで先頭に戻るときはタイムラグが出ないように(今は一瞬止まります) | A | 2010-10-19 | 2010-11-25 | PhongVM TungNS | 理解内容：ご指摘が分かりました。 ＝＝＞10/25にこの問題の確認を含むIIG2_VPS_QA Management Sheet.xlsファイルを送って確認をお願いしました。 Q&Aの回答を待っています。 対策：各問題の対応方向を調査したところ、この問題の対応方向を見つけました。それは再度再生するたびにグラフをビルドしないようにする方法です。 現在、この問題に対応できました。 | 2010-11-09 | Completed | この問題に対応しなくてもかまわないとNTT様に確認して頂きました。
6 | 上記プレイボタンや、スライドバーがときどき機能しなくなる(いろいろ操作しているとこうなります)。Get last frame, Get next frameのボタンが、逆の動作をしたこともありました。 | A | 2010-10-19 | 2010-12-10 | PhongVM | 理解内容：ご指摘が分かりました。 原因：マルチスレッドを使っているので、get next frame、又はget previous frameの関数を呼び出す時にそれぞれのフレームの連番を制御ことが難しいです。 対策：get next frame、又はget previous frameの関数を呼び出すたびに、ポイントされているフレームの連番をチェックします。フレームの連番が正しくない場合、正しい連番があるフレームにシークしました。 | 2010-12-10 | Completed
7 | 画像の表示位置をかえていた場合、copy to clipboardしたのち左上に戻ってしまう | A | 2010-10-19 | 2010-10-21 | PhongVM TungNS | 理解内容：ご指摘が分かりました。 問題：このデモ版（１つの映像しか再生できない）ではこのバグを検出していません。 対策：最新のデモ版（複数の映像を再生できた）では、copy to clipboardした後に映像の位置をそのままにして、本バグに対応しました。 | 2010-10-19 | Completed
8 | "YUV Property Setting"のダイアログで、実際と異なるサイズを 選びOKすると動作がとまることがある（正しいサイズを選んでも とまることがありました） | A | 2010-10-19 | 2010-03-01 | PhongVM TungNS | 理解内容：ご指摘が分かりました。 問題:このデモ版（１つの映像しか再生できない）ではこのバグを検出していません。 対策：最新のデモ版（複数の映像を再生できた）では、OKボタンクリックイベントをキャプチャーする時の処理を変更して、本バグに対応しました。 |  | Completed
9 | copy to clipboardしたのち、Paintへのペーストはできるが、 PowerPointにはペーストができないので、これを可能に していただけるでしょうか。 | A | 2010-10-19 | 2010-10-21 | TungNS | 理解内容：ご指摘が分かりました。 問題：copy to clipboardの時に、割り当てられたリソースが不足しています。 対策：copy to clipboardの時に、リソースを十分に割り当てました。 | 2010-10-20 | Completed
10 | 左下の「|<<」のようなアイコンのバルーンチップが"Stop"と なっていますが、これは"Rewind"にしてください。 | A | 2010-10-19 | 2010-10-21 | PhongVM | 理解内容：ご指摘が分かりました。 対策：tooltipを更新しました。 | 2010-10-20 | Completed
11 | 同じく、「||」のアイコン(Pause)ですが、もし可能でしたら 停止中は「＞」、再生中は「||」と表示される(再生・停止の トグル動作)ようにできるでしょうか。 この場合、左から7番目のボタン「＞」はなくなります。 | A | 2010-10-19 | 2010-11-04 | PhongVM TungNS | 理解内容：ご指摘が分かりました。 ＝＝＞10/25にこの問題の確認を含むIIG2_VPS_QA Management Sheet.xlsファイルを送って確認をお願いしました。 Q&Aの回答を待っています。(Q&Aの回答を受け取りました。) | 2010-11-04 | Completed | この問題に対応しなくてもかまわないとNTT様に確認して頂きました。
12 | 画像をオープンし"YUV Property Setting"のダイアログを出すと 同時に、Auto Detectを行っていただけますでしょうか。 | A | 2010-10-19 | 2010-10-20 | TungNS | 理解内容：ご指摘が分かりました。 対策：プレビューダイアログを開く時、Autodetect関数を呼び出すコマンドを追加しました。 | 2010-10-20 | Completed
13 | このダイアログにて、 o サイズが確定するまではOKのボタンはdeactivateして いただけますでしょうか。 o またサイズやformat,depthを選択した際、Preview画面 を自動で表示しますので、Previewボタンは不要かと思います。 | A | 2010-10-19 | 2010-11-04 | PhongVM TungNS | 理解内容：ご指摘が分かりました。 ＝＝＞10/25にこの問題の確認を含むIIG2_VPS_QA Management Sheet.xlsファイルを送って確認をお願いしました。 Q&Aの回答を待っています。(Q&Aの回答を受け取りました。) | 2010-11-04 | Completed | 本項目は、NTT様のご指摘により変更されて、項目17に更新されました。
14 | 画像拡大時、補間したような模様が見える。 拡大時は補間せず、画素の繰り返しとしてください。 a b c d を二倍拡大すると a a b b a a b b c c d d c c d d となるようなイメージです。4倍も同様です。 1/2, 1/4の縮小のときは、"平均"でお願いいたします。 | A | 2010-10-19 | 2011-03-01 | PhongVM TungNS | 理解内容：ご指摘が分かりました。 ＝＝＞検討中 結論：弊社の使ったYUV からRGBへの変換用公式が御社のご送付したサンプルの公式と異なっています。現在、そのサンプルの公式を使ったところ、VPSプログラムは本サンプルと同様に表示されました。最新のデモ版（表示の色問題に対応された）を送付させて頂きます。bilinear interpolationからnearest neighbor interpolationにズーム用アルゴリズムを変更することが不要だと考えております。ご確認頂くようお願いします。 Q&A:VMR9向けのcustom allocator & presenterを書いた後、 画像がNearest Neighbor Interpolationに従って拡大されたと確認しました。 ご確認頂く様お願い致します。 | 2011-01-14 | Completed
15 | HLSLに関する検討 | A | 2010-10-19 | 2011-03-01 | PhongVM TungNS | 理解内容：不明点があるので、10/25にHLSLに関する確認を含むIIG2_VPS_QA Management Sheet.xlsファイルを送って確認をお願いしました。 Q&Aの回答を待っています。(Q&Aの回答を受け取りました。) |  | Pending
16 | PreviewボタンをSizeのエリア(Pre-define＋Customなどを含む)に移動して、不要の時に無効化するようにします。 | A | 2010-11-04 | 2010-11-09 | PhongVM TungNS | 理解内容：ご要求が分かりました。 対応できました。 | 2010-11-09 | Completed
17 | 上下の矢印キーで16xまで拡大することに対応します。 | A | 2010-11-04 | 2010-12-31 | PhongVM TungNS | 理解内容：ご要求が分かりました。これから対応します。 | 2010-12-23 | Completed
18 | RPTonで映像をplay backwardすると、映像を最後ー＞最初の順番で連続的に再生できるようにします。 | A | 2010-11-04 | 2010-11-24 | PhongVM TungNS | 理解内容：ご要求が分かりました。これから対応します。 対策：play backward用イベントを1つ追加し、ソースフィルターでのファイルの読み込み方法を修正しました。 | 2010-11-24 | Completed
19 | ＃18と同様に、RPTonで映像に対してget next frameとget last frameを実施すると連続的に実施できるようにします。 | A | 2010-11-04 | 2010-11-24 | PhongVM TungNS | 理解内容：ご要求が分かりました。これから対応します。 対策：それぞれのフレームの再生を有効・無効する機能をVPSに追加しました。 | 2010-11-24 | Completed
20 | 映像がstop、又はpauseされている最中に、別のプログラムをVPSの上に重なってオープンすると、画像がdrawされていません。 | A | 2010-11-04 | 2010-11-09 | PhongVM TungNS | 理解内容：ご指摘が分かりました。 対策：映像がstop、又はpauseされている状態の画像をdrawしました。 | 2010-11-12 | Completed
21 | 映像の最初までplay backwardした後、play forwardできなくなりました。この現象に関連するエラーもたくさん出ました。 | A | 2010-11-04 | 2010-11-24 | PhongVM TungNS | 理解内容：ご指摘が分かりました。 判断：映像の最初までplay backwardする時の計算が間違っている可能性があります。 対策：ファイルを読み込む時の計算を修正しました。 | 2010-11-24 | Completed
22 | 容量の大きい映像をたくさん再生した場合、ズームの時に、プログラムが停止することがよく発生しました。 | A | 2010-11-04 | 2010-12-22 | PhongVM TungNS | 理解内容：ご指摘が分かりました。 原因：コンピュータの動作が遅くなった時にスレッドとミューテックスは安定的に動いていません。 対策：FillFrameIntoBufferスレッドにある不要なautolock 変数を１件削除しました。 | 2010-12-08 | Completed
23 | 画像の色がおかしい(実際の画像より赤い) | A | 2010-11-04 | 2010-11-09 | PhongVM TungNS | 理解内容：ご指摘が分かりました。 原因：弊社の使ったアルゴリズムがNTT様のと異なっています。 対策：NTT様のアルゴリズムを使いました。 | 2010-11-09 | Completed
24 | プレビュー画像がプログラムのフレームの外で表示されることがあります。 | A | 2010-11-04 | 2010-11-25 | PhongVM TungNS | 理解内容：ご指摘が分かりました。 対策方向：プレビュー画像用バウンダリーを作成する必要があります。 対策：プレビュー画像用バウンダリーを作成しました。 | 2010-11-25 | Completed
25 | １つの映像を再生している時に、Fileー＞Openを選択して、cancelを選択すると、再生中の映像はそのまま保存されず、削除されてしまいました。 | A | 2010-11-04 | 2010-11-25 | PhongVM TungNS | 理解内容：ごが分かりました。 原因：デフォールトは、Fileー＞Openを選択すると再生中の映像が全て削除されます。 ＝＝＞上記のようなプロセスを変更する必要があります。 対策：原因分で示したプロセスを変更しました。 | 2010-11-25 | Completed
26 | 映像の再生が終わったとたん、フル画面表示のモードが終わってしまいました。 | A | 2010-11-04 | 2010-11-25 | PhongVM TungNS | 理解内容：ご指摘が分かりました。 対策方向：フル画面表示の機能の設定を変更する必要があります。 対策：フル画面表示の機能を修正しました | 2010-11-25 | Completed
27 | フル画面で表示される画像はボーダーがあります。 | A | 2010-11-04 | 2010-12-08 | PhongVM TungNS | 理解内容：ご指摘が分かりました。 原因：ズームの公式を流通しているためです。 対策：フル画面で再生する時のボーダーを計算しました。 | 2010-11-14 | Completed
28 | "YUV Property Setting"のダイアログでPre-Defineを選択して、Autodetectを押下すると、Pre-DefineとCustomの両方も選択されてしまいました。 | A | 2010-11-04 | 2010-11-09 | PhongVM TungNS | 理解内容：ご指摘が分かりました。 対策：Pre-Defineの動作を修正しました。 | 2010-11-15 | Completed
29 | フレームレートを変更した後、RPTonで映像を再生すると、2回目からフレームレートは30Hzに戻ってしまいました。 | A | 2010-11-04 | 2010-11-09 | PhongVM TungNS | 理解内容：ご指摘が分かりました。 原因：再度再生の時に、変更済みのフレームレートの値を保存しませんでした。 対策：再度再生の時に、変更済みのフレームレートの値を保存しました。 | 2010-11-16 | Completed
30 | 画像をドラッグした後、再度再生した時に、画像はドラッグの前の位置に戻ってしまいました。 | A | 2010-11-04 | 2010-11-25 | PhongVM TungNS | 理解内容：ご指摘が分かりました。 原因：再度再生の時に、画像の位置の値を保存しませんでした。 対策：再度再生の時に、画像の位置の値を保存しました。 | 2010-11-23 | Completed
31 | 容量の大きい映像を最初の画面より大きい画面で再生すると、映像が滑らかに再生されなませんでした。 | A | 2010-11-04 | 2010-12-22 | PhongVM TungNS | 理解内容：ご指摘が分かりました。 原因：VMR-9のためです。 ＝＞対応しました。 | 2011-02-25 | Completed
32 | VPSをインストールした時に作成されたショートカットに映像をドラッグして映像を開くことができていないが、アプリケーション（C:\ProgramFiles\VPS\VPS.exe）と他のショートカット(VPS.exeで作成された)では上記の操作ができました。 | A | 2010-11-04 | 2010-12-06 | PhongVM TungNS | 理解内容：ご指摘が分かりました。 原因：Window Installer の設定に関するエラーのためです。 対策：Orca（setup .msiフォルダの修正用ツール）をダウンロードして、インストールしました。Orcaでsetup .msiファイルをオープンして、プロパティでDISABLEADVTSHORTCUTSの行を追加しました。そして、この行の値を１に設定した後、インストールの次のステップを実施しました。 | 2010-12-09 | Completed
33 | 容量の大きい映像の再生速度がリアルタイムになりません。 | A | 2010-11-04 | 2011-03-01 | PhongVM TungNS | 理解内容：ご指摘が分かりました。 | 2010-02-25 | Completed
34 | 容量の大きい映像をたくさん再生した時、プログラムが停止されてしまったことがあります。 | A | 2010-11-04 | 2010-12-25 | PhongVM TungNS | 理解内容：原因がまだ不明で、調査しています 原因：＃２２と同様です。 対策：＃２２と同様です。 | 2010-12-08 | Completed
35 | 任意の映像の再生を複数回で繰り返した時、映像の画像、色などがおかしいことがあります。 | A | 2010-11-04 | 2010-11-27 | PhongVM TungNS | 原因：VPSのファイルの読み込みの管理がよくないためです。 対策：＃21の問題を修正した後、この問題は出ませんでした。 | 2010-11-26 | Completed
36 | 容量の大きい映像をたくさん再生して、「Stop」ボタンを押下した時、プログラムが停止されてしまったことが多い。 | A | 2010-11-04 | 2010-12-25 | PhongVM TungNS | 理解内容：原因がまだ不明で、調査しています 原因：＃２２と同様です。 対策：＃２２と同様です。 | 2010-12-08 | Completed
37 | 複数のWindowsプラットフォームをサポートしていません。 | A | 2010-11-04 | 2011-03-01 | PhongVM TungNS | Windows XP 32bit、Windows XP 64bit、Windows Vista 32bit、Windows Vista 64bit、Windows 7 32bit、Windows 7 64bitに対応するようにしています。 | 2010-02-20 | Completed
38 | 映像のファイルの最後で8 bits以上のYUVに対してget next frame、又はseekを実施すると、プログラムが停止されてしまいました（映像ファイルの最初でもこのような問題が発生しています） | A | 2010-11-04 | 2011-03-01 | PhongVM TungNS | 原因：マルチスレッドの使用に関するエラーのためです。 対策：8 bits以上のYUVに対して操作を実施した時にdeadlockをかけた場合に対応しました。 | 2010-12-02 | Completed
39 | 映像ファイルの最初と最後の所でreplay、stop、repeat、get next frame、get last frameなどを実施した時、プログラムの動作が安定していないことがあります。 | A | 2010-11-04 | 2010-12-03 | PhongVM TungNS | 原因：＃６が影響を与えたためです。 対策：＃６でのデータの読み込みと映像ファイルの最初と最後の所での操作を別々にしました | 2010-11-30 | Completed
40 | VPSを導入や更新する際、インストール・アンインストールが 必要なのは面倒です。 NTT様のご提案：スタンドアロンのexeだけを使う。 | A | 2010-12-06 | 2010-12-06 | PhongVM TungNS | 理解内容：ご指摘が分かりました。 対策：YUV_SOURCE.dllを登録しないようにしました。この.dllから直接にインスタンスを作成するようにしました。 | 2011-02-15 | Completed
41 | 映像を一時停止・停止している時に、画像をドラッグすると、プログラムの速度が遅くなる、あるいは現象（本ファイルのReferencesシートでの画像(Image01)を参照のこと）が発生する。 | A | 14/1/2011 | 2010-01-03 | PhongVM TungNS | 原因：Direct3D9のrendertargetの動作が遅すぎるためです。 対策：この問題をクローズすることを高村さんに確認して頂きましたので、この問題をクローズしました。 | 2011-02-11 | Completed
42 | ホットキーのメニューとプログラムのメニューあるが、実際では、全てのホットキーとメニューが動きません。（「Play speed」のホットキー、File -> Closeなど） | A | 2011-11-02 |  | PhongVM TungNS | 理解内容：ご指摘が分かりました。 対策：「Play speed」項目を削除しました。 | 2011-02-15 | Completed
43 | 複数のファイルをVPS.exeにドラッグする時、プログラムの動作がおかしくなっています。 | A | 2011-11-02 |  | PhongVM TungNS | 理解内容：ご指摘が分かりました。 原因：ドラッグした全てのファイルを取得してYUVファイルへのパスとして見なしたためです。 対策：ドラッグした複数のファイルの中、最初のファイルのみを開けるようにしました。 | 2011-02-15 | Completed
44 | VPSのバージョンを HelpのAbout VPSに表示していません。 | A | 2011-11-02 |  | PhongVM TungNS | 理解内容：ご指摘が分かりました。 対策：VPSのバージョンを HelpのAbout VPSに表示するようにしました。 | 2011-02-15 | Completed
45 | Speedのオプションに15Hzと24 Hzを追加するようにしてください。 | A | 2011-11-02 |  | PhongVM TungNS | 追加しました。 | 2011-02-15 | Completed
46 | マウスの位置によるズーム（マウスを使う時）と再生画面の中心にしてズーム（キーボードを使う時）の機能がありません。 | A | 2011-11-02 |  | PhongVM TungNS | 理解内容：ご指摘が分かりました。 ＝＞来年度で対応します。 |  | Pending
47 | 仮想コンピューターのWindow XPモードでVPSを動かすことが できていません。 | A | 2011-11-02 |  | PhongVM TungNS | 理解内容：ご指摘が分かりました。 ＝＞来年度で対応します。 |  | Pending
48 | 映像の最後まで再生した後、TrackbarのポインターがTrackbarの最初の位置に戻ります。 その時、最初の1.5秒でそのポインターをTrackbarでの任意位置まで移動しても、 ポインターの位置が変わりません。 | A | 2011-11-02 |  | PhongVM TungNS | 理解内容：ご指摘が分かりました。 対応しました。 | 2011-02-15 | Completed
49 | ある映像ファイルを選択した後、「file」→「close」を選択すると、その映像ファイルを終了する必要がある。 | A | 2011-11-02 |  | PhongVM TungNS | 理解内容：ご指摘が分かりました。 ＝＞来年度で対応します。 |  | Pending
50 | 映像を一時停止している時に、フレームレート変更のコンボボックスを使ってフレームレートを変更すると、画像がぎくしゃくしてしまいました。 | A | 15/2/2011 |  | PhongVM TungNS | 理解内容：ご指摘が分かりました。 原因：それぞれフレームの管理に関連するDirectShowの制限のためです。 対策：DirectShowからdirect Xに変更する必要があります。 |  | Pending
51 | 通常表示のモードからフル画面表示のモードに切り替えた時に映像がぎくしゃくしてしまいました。 上記の逆に実施した時も、同じ現象が発生しました。 | A | 15/2/2011 |  | PhongVM TungNS | 原因：＃50と同じ 対策：＃50と同じ |  | Pending
52 | 映像を一時停止・停止している時に、 通常表示のモードからフル画面表示のモードに切り替えることができません。 | A | 15/2/2011 |  | PhongVM TungNS | 原因：映像を一時停止・停止している時に通常表示のモードからフル画面表示のモードに切り替えるための対策を見付けられていません。 |  | Pending
53 | 映像を最後まで再生した時に、メニューを開いたが、メニュー項目を１つも選択しなくて、 メニューの状態をそのままにした場合、映像が最後の箇所で一時停止されてしまいました。 メニュー以外の箇所でマウスをクリックして、メニューの表示を終了した時、映像が正常に引き続き再生されました。 | A | 15/2/2011 |  | PhongVM TungNS | 原因：windowのメッセージループと映像のメッセージループが同一のスレッドで存在するためです。 対策：windowのメッセージループと映像のメッセージループがそれぞれ別々のスレッドで存在するようにする必要があります。 |  | Pending
54 | 複数の異なる映像ファイル（以下の特徴がある）を再生した時、以下のような現象がよく発生しました。 ・映像ファイルの特徴点：少なくとも、大きいサイズ（1920x1280など）の映像と小さいサイズ（176x144など）の映像を含む。 さらに、小さい映像のほうが大きい映像よりフレーム数が多い。 ・現象：TrackbarのポインターがTrackbarの最後まで行っても、大きい映像がまだ再生されています。 | A | 15/2/2011 |  | PhongVM TungNS | 原因：大きい映像の実際再生速度が小さい映像の比べてより遅いためです。 対策：全映像の実際再生速度を計算して、一番遅い速度（15フレーム/秒など）がある映像を見付けます。この映像速度に従い、全映像の速度を制限するようにします。この映像速度より速い速度を無効化します。 |  | Pending
55 | get next frame、またはget last frameを実施する時に、フレームが飛んでしまいました。 | A | 2011-11-02 |  | PhongVM TungNS | 原因：＃50と同じ 対策：＃50と同じ |  | Pending
56 | NTT様からご提供頂いた委託内容のファイルには「画像ウィンドウで右クリックして「クリップボードに画像情報コピー」ができること」を記載していますが、 この要件の通りに実装していないことを発見したばかりです。 | A | 15/2/2011 |  | PhongVM TungNS | 理解内容：ご指摘が分かりました。 ＝＞来年度で対応します。 |  | Pending
