phong1990/fufo-innovation/Document/04.Design/FUFO_FUFO/00.Circuit/PCB & SCH.PDF

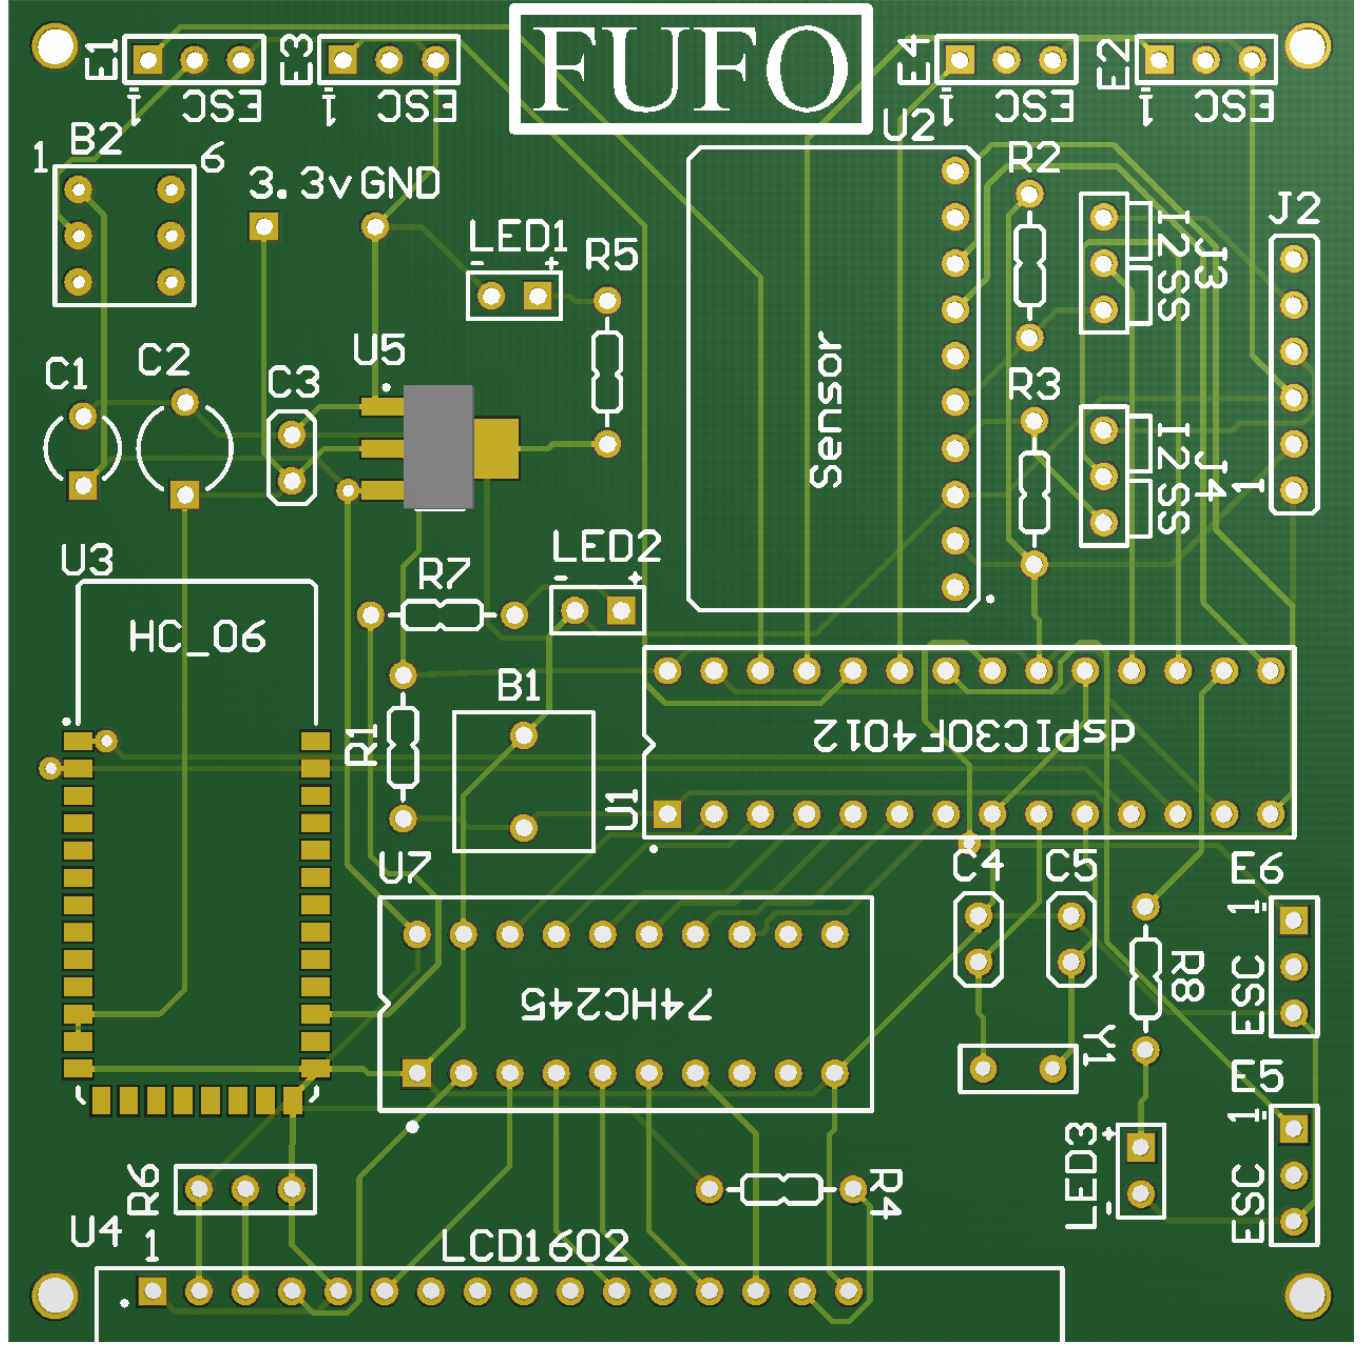
[picture p155: page 1]

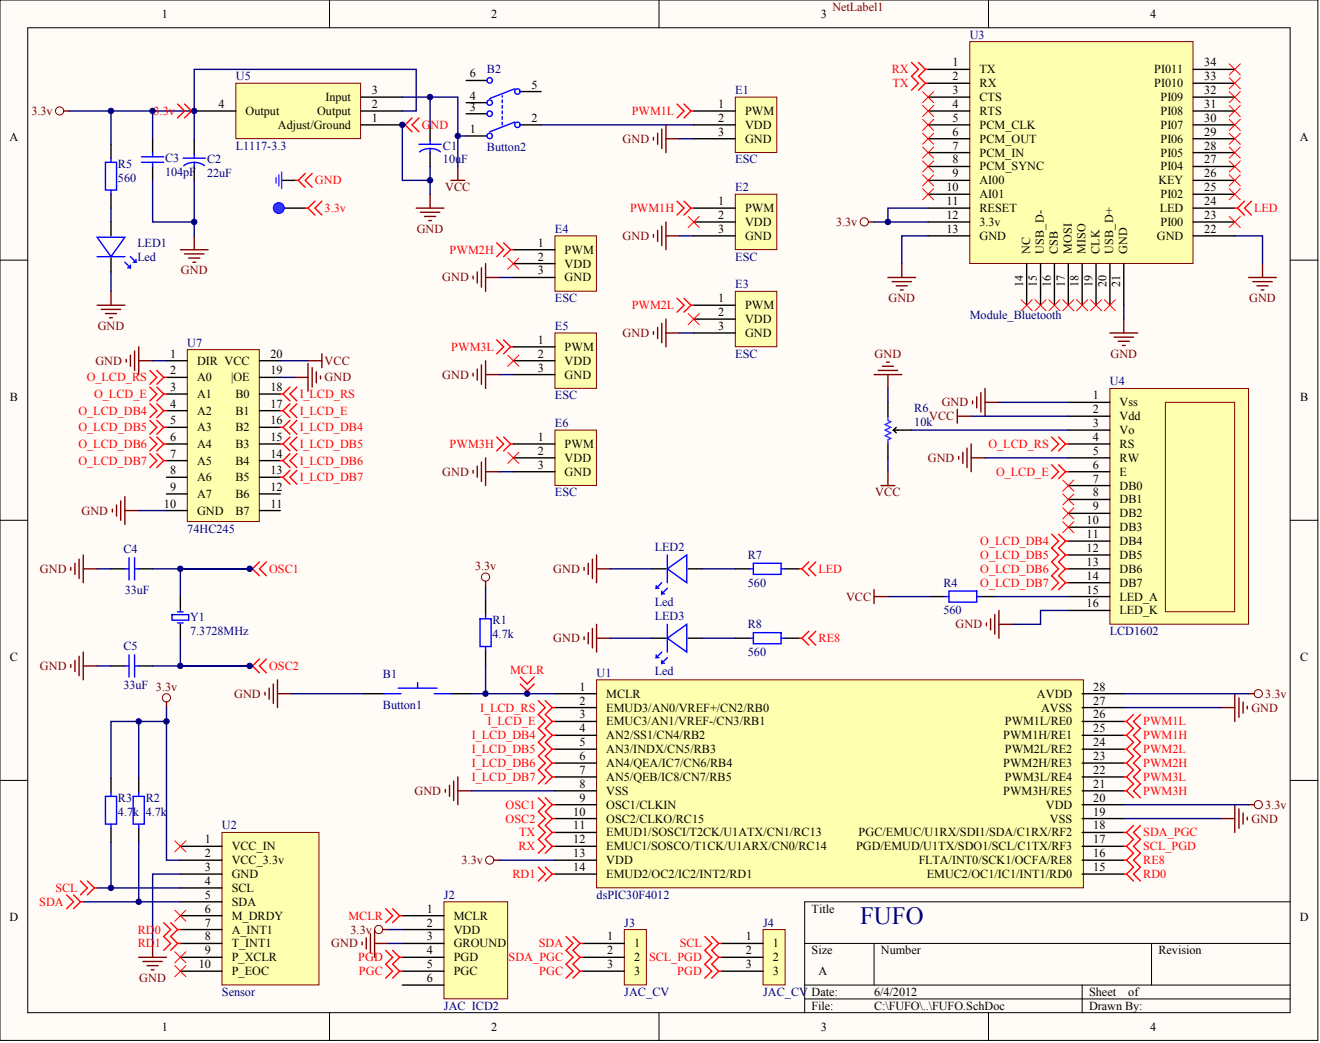
[picture p156: page 2]

SCL 4 SDA 5

M_DRDY 6
