phong1990/fufo-innovation/Document/04.Design/FUFO_FUFO/00.Circuit/FUFO.pdf

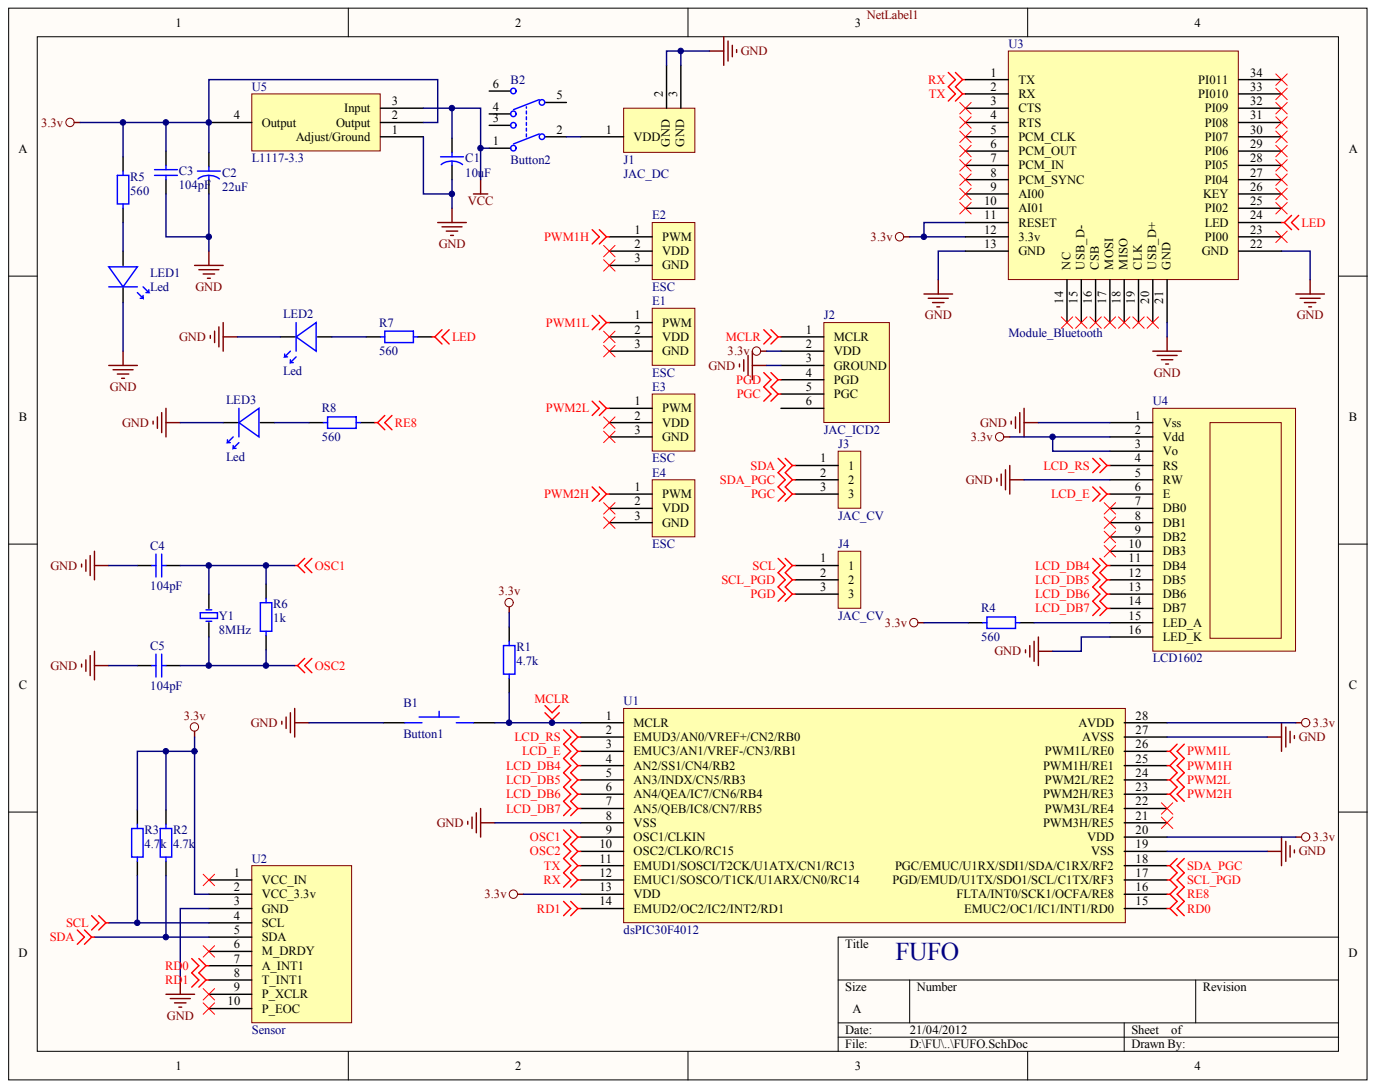
[picture p157: page 1]

Vss 1
