phong1990/fufo-innovation/Document/04.Design/FUFO_FUFO/00.Circuit/FUFOpcb.pdf

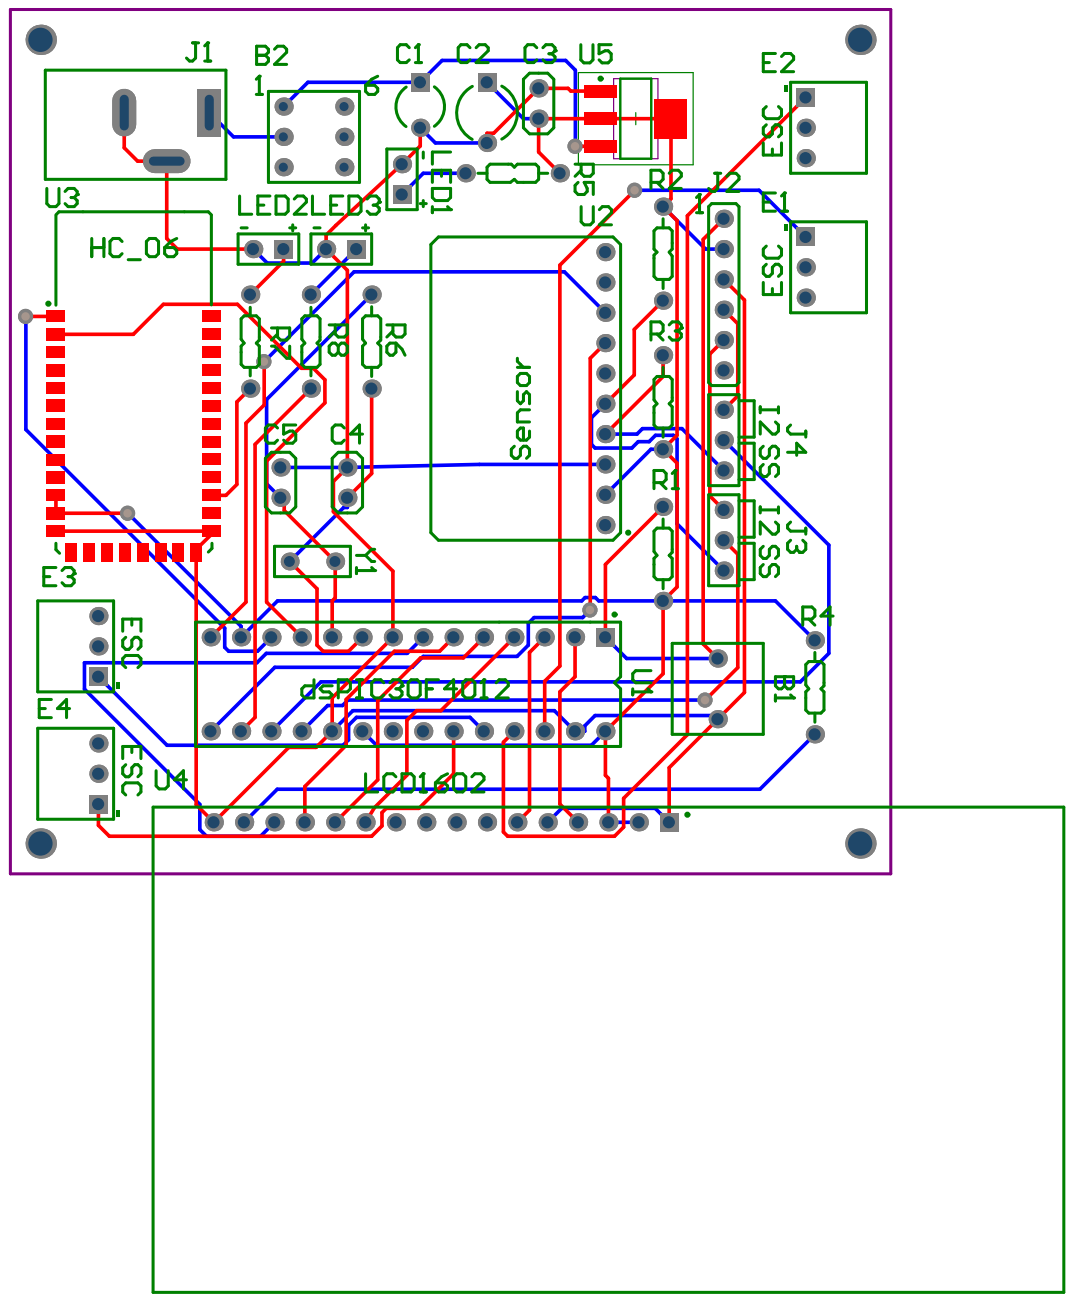
[picture p158: page 1]
