phong1990/fufo-innovation/(list of files, drawings)

Other design files:
Document/04.Design/FUFO_FUFO/00.Circuit/DC_5v_to_3v3.DSN
Document/04.Design/FUFO_FUFO/00.Circuit/FUFO.PcbDoc
Document/04.Design/FUFO_FUFO/00.Circuit/FUFO.PcbLib
Document/04.Design/FUFO_FUFO/00.Circuit/FUFO.PrjPCB
Document/04.Design/FUFO_FUFO/00.Circuit/FUFO.SchDoc
Document/04.Design/FUFO_FUFO/00.Circuit/FUFO.SchLib
Other/01.Datasheet/RS232_485_dsPIC30.SchDoc
