phong1990/fufo-innovation/SourceCode/FUFO tich hop code HMC/PWM/pwmControl.c

#include "../FUFO.h"

int PR4_value;
int periodValue;
int initDCValue;
int a = 1000;
int PWM_per_thrust = 40;

void initPWMPort(void){
	PWM_LAT = 0;
	PWM_TRIS = 0;
}
 
void setPR4(int value){
	PR4_value = value;
}

int getPR4(void){
	return PR4_value;
}

void initPWM(void){
	periodValue = Fcy/(Fpwm*4);
	initDCValue = ((float)periodValue*Fpwm)/1000;
	PR4_value = initDCValue;
	initPWMPort();
	initPWMHardware();
	initPWMSoftware();
	_PTEN = 1;				// PWM time base is ON
	_RE5 = 1;
	T4CONbits.TON = 1;		//timer 4 on
}

void initPWMHardware(void){
	PTPER = periodValue - 1;
	PWMCON1 = 0x070F;			//1. Chinh mode Independent;  2. Chinh PWM chi ra o pin L, khong ra pin H;
	OVDCON = 0xFF00;			//Khong dung overdrive
	_PTSIDL = 0;			// PWM time base runs in CPU Idle mode
	_PTOPS = 0x0000;			// 1:1 Postscale
	_PTCKPS = 0b01;			// PWM time base input clock period is 16 Tcy  (1:16 prescale)
	_PTMOD = 0x00;			// PWM time base operates in a free running mode
	PDC1 = initDCValue*2;			//Khoi tao ESC1 chay o 1ms
	PDC2 = initDCValue*2;			//Khoi tao ESC3 chay o 1ms
	PDC3 = initDCValue*2;			//Khoi tao ESC5 chay o 1ms
	_PTEN = 0;				// PWM time base is OFF
}

void initPWMSoftware(void){
	IPC5bits.T4IP = 7;  	//highest priority interrupt
	T4CONbits.TCKPS = 0b01;	// timer 2 prescale = 8
	TMR4 = 0;
	PR4 = (PR4_value/2);		
	IFS1bits.T4IF = 0;		//interupt flag clear
    IEC1bits.T4IE = 1;  	//Enable Timer1 Interrupt Service Routine
	T4CONbits.TON = 0;		//timer 2 off
}

//void setPWM1(int Thrust1, int PID_Motor1, int motor1){
//	PDC1 = (initDCValue + Thrust1*PWM_per_thrust + PID_Motor1 + motor1)*2 + PWM_per_thrust*2;
//}
//
//void setPWM2(int Thrust2, int PID_Motor2, int motor2){
//	PDC2 = (initDCValue + Thrust2*PWM_per_thrust + PID_Motor2 + motor2)*2;
//}
//
//void setPWM3(int Thrust3, int PID_Motor3, int motor3){
//	PDC3 = (initDCValue + Thrust3*PWM_per_thrust + PID_Motor3 + motor3)*2 + PWM_per_thrust*2;
//}
//
//void setPWM4(int Thrust4, int PID_Motor4, int motor4){
//	//PR4_value = initDCValue + Thrust4*PWM_per_thrust + PID_Motor4 + motor4*20)/2;//+ PWM_per_thrust*7;
//	PR4_value = initDCValue + Thrust4*PWM_per_thrust + PID_Motor4 + motor4 + PWM_per_thrust*7;
//}

//void setPWM1(int Thrust1, int PID_Motor1, int motor1){
//	PDC1 = (initDCValue + Thrust1*PWM_per_thrust + PID_Motor1 + motor1)*2 + PWM_per_thrust*20*2;
//}
//
//void setPWM2(int Thrust2, int PID_Motor2, int motor2){
//	PDC2 = (initDCValue + Thrust2*PWM_per_thrust + PID_Motor2 + motor2)*2 + PWM_per_thrust*19*2;
//}
//
//void setPWM3(int Thrust3, int PID_Motor3, int motor3){
//	PDC3 = (initDCValue + Thrust3*PWM_per_thrust + PID_Motor3 + motor3)*2;
//}
//
//void setPWM4(int Thrust4, int PID_Motor4, int motor4){
//	//PR4_value = initDCValue + Thrust4*PWM_per_thrust + PID_Motor4 + motor4*20)/2;//+ PWM_per_thrust*7;
//	PR4_value = initDCValue + Thrust4*PWM_per_thrust + PID_Motor4 + motor4 + PWM_per_thrust*26;
//}

void setPWM1(int Thrust1, int PID_Motor1, int motor1){
	PDC1 = (initDCValue + Thrust1*PWM_per_thrust + PWM_per_thrust + PID_Motor1 + motor1)*2;
}

void setPWM2(int Thrust2, int PID_Motor2, int motor2){
	PDC2 = (initDCValue + Thrust2*PWM_per_thrust + PID_Motor2 + motor2)*2;
}

void setPWM3(int Thrust3, int PID_Motor3, int motor3){
	PDC3 = (initDCValue + Thrust3*PWM_per_thrust + PWM_per_thrust*12 + PID_Motor3 + motor3)*2;
}

void setPWM4(int Thrust4, int PID_Motor4, int motor4){
	//PR4_value = initDCValue + Thrust4*PWM_per_thrust + PID_Motor4 + motor4*20)/2;//+ PWM_per_thrust*7;
	PR4_value = initDCValue + Thrust4*PWM_per_thrust + PWM_per_thrust*7 + PID_Motor4 + motor4;
}

void __attribute__((__interrupt__ , auto_psv)) _T4Interrupt (void)
{
	TMR4 = 0;	
//	T4CONbits.TON = 0;	//timer 4 off
	if (PR4 == ((periodValue/2) - (PR4_value/2))){
		PR4 = (PR4_value/2);		// HIGH on 1 ms
		_RE5 = 1;
	}else{
		PR4 = (periodValue/2) - (PR4_value/2);		// LOW on 2.5 ms
		_RE5 = 0;
	}
//	T4CONbits.TON = 1;		//timer 4 on
	IFS1bits.T4IF = 0;	// clear interrupt flag manually
}
