phong1990/fufo-innovation/SourceCode/FUFO tich hop code HMC/PWM/pwmControl.h

#include "p30f4012.h"

#define	PWM_PORT	PORTE		//Cac tin hieu PWM nam o cong E
#define	PWM_TRIS	TRISE		//Thanh ghi 3 trang thai cho cac tin hieu PWM
#define	PWM_LAT		LATE		//Thanh ghi chot cac tin hieu PWM

void setPR4(int value);
int getPR4(void);
void initPWMPort(void);
void initPWM(void);
void initPWMHardware(void);
void initPWMSoftware(void);
void setPWM1(int Thrust1, int PID_Motor1, int motor1);
void setPWM2(int Thrust2, int PID_Motor2, int motor2);
void setPWM3(int Thrust3, int PID_Motor3, int motor3);
void setPWM4(int Thrust4, int PID_Motor4, int motor4);
