phong1990/fufo-innovation/SourceCode/FUFO tich hop code HMC/Filter/Filter.c

#include "../FUFO.h"


unsigned int idx100 = 0;
int R0x, R0y, R0z;
int xIntG, yIntG, zIntG;
int Rxm, Rym, Rzm;
float Rx, Ry, Rz;
float Ax, Ay, Az;
float phiAngle, thetaAngle;
unsigned int dataGyroArray[3], dataAccelArray[3];
unsigned char noticeError[] = "Errored";
float phiComp;
float thetaComp;
float psiHigh;
float altFinal = 0;
float AccZSum = 0;
float AzOld = 1;
float AccZSumSmooth = 0;  
int finishFlag = False;
float altFinalLPF = 0;
float vz_est = 0;
float h_est = 0;
//////////////////////////////////
float xScaled, yScaled, zScaled;
float xRaw, yRaw, zRaw; 
unsigned int dataMagnetoArray[3];
float heading = 0;
float declinationAngle = 0.0235619445;
float convertMagneto = 2.56;
float headingDegrees = 0;

void CalcFirstAngle(void){
	fufoGetAngleAccel();
	fufoGetAngleGyros();
	phiComp = k*(phiAngle + Ry*0.01) + (1 - k)*phiAngle; 			// this line of code is to make the angle which is calculated by gyroscope 
																				// become pessistant with the Zero point of the inertial frame, according to 
																				// the Accelerometer.
	thetaComp = k*(thetaAngle + Rx*0.01) + (1 - k)*thetaAngle;
}

void CompFilter(void){
	fufoGetAngleAccel();
	fufoGetAngleGyros();
	phiComp = k*(phiComp + Ry*0.01) + (1 - k)*phiAngle;
	thetaComp = k*(thetaComp + Rx*0.01) + (1 - k)*thetaAngle;
//	psiHigh = k*(psiHigh + Rz*0.01);
//	if(psiHigh > 360){
//		psiHigh = psiHigh - 360;
//	}
	setGyrosOutputR(Rx);
	setGyrosOutputP(Ry);
	setGyrosOutputY(Rz);
	setPhiAngle(phiComp);
	setThetaAngle(thetaComp);
//	setPsiAngle(psiHigh);	
}

void fufoGetRateAngle(void){
	if(idx100 < 100) {
		fufoReadGyro(dataGyroArray);
		if(dataGyroArray[0] < 32768) {
			xIntG += dataGyroArray[0];
		} else {
			xIntG += (dataGyroArray[0] - 65536 );
		}
		
		if(dataGyroArray[1] < 32768) {
			yIntG += dataGyroArray[1];
		} else {
			yIntG += (dataGyroArray[1] - 65536);
		}
		
		if(dataGyroArray[2] < 32768) {
			zIntG += dataGyroArray[2];
		} else {
			zIntG += (dataGyroArray[2] - 65536);
		}
		idx100++;

		if(idx100 == 100) {	
			R0x = (int)(xIntG/idx100);
			R0y = (int)(yIntG/idx100);
			R0z = (int)(zIntG/idx100);	
			idx100 = 0;
			CalcFirstAngle();
			finishFlag = True;	
		}		
	}
}

int calcRateAngle(void){
	return finishFlag;
}

void fufoGetAngleGyros(void){
	fufoReadGyro(dataGyroArray);
	if(dataGyroArray[0] < 32768) {
		Rxm = dataGyroArray[0];
	} else {
		Rxm = (dataGyroArray[0] - 65536 );
	}
	
	if(dataGyroArray[1] < 32768) {
		Rym = dataGyroArray[1];
	} else {
		Rym = (dataGyroArray[1] - 65536);
	}
	
	if(dataGyroArray[2] < 32768) {
		Rzm = dataGyroArray[2];
	} else {
		Rzm = (dataGyroArray[2] - 65536);
	}
	Rx = (float)(Rxm - R0x) * convertGyro;
	Ry = (float)(Rym - R0y) * convertGyro;
	Rz = (float)(Rzm - R0z) * convertGyro ;
}

void fufoGetAngleAccel(void){
	readAccel(dataAccelArray);
	
    if(dataAccelArray[0] < 4096) {
		Ax = (float)dataAccelArray[0]*convertAccel;	
	} else {
		Ax = ((float)dataAccelArray[0] - 8192)*convertAccel;
	}

	if(dataAccelArray[1] < 4096) {
		Ay = (float)dataAccelArray[1]*convertAccel;	
	} else {
		Ay = ((float)dataAccelArray[1] - 8192)*convertAccel;
	}

	if(dataAccelArray[2] < 4096) {
		Az = (float)dataAccelArray[2]*convertAccel;	
	} else {
		Az = ((float)dataAccelArray[2] - 8192)*convertAccel;
			
	}
	phiAngle = (180 / 3.1415926)*atan2(-Ax, sqrt(pow(Ay, 2) + pow(Az, 2)));

	thetaAngle = (180 / 3.1415926)*atan2(Ay, sqrt(pow(Az, 2) + 0.01 * pow(Ax, 2)));
}

float getAltitude(float baroAlt){	
	h_est = h_est + (h_est - baroAlt)*k_h_est;
	vz_est = vz_est + (h_est - baroAlt)*k_vz_est;
	return h_est;
}

void calcAltZ(void){
	h_est = h_est + vz_est*0.01;
	vz_est = vz_est + Az*9.8*0.01;
}

float fufoCalcAngleMag() {
	fufoReadMagneto(dataMagnetoArray);
	if(dataMagnetoArray[0] < 32768) {
			xRaw = dataMagnetoArray[0];
		} else {
			xRaw = (dataMagnetoArray[0] - 65536 );
		}
		
		if(dataMagnetoArray[1] < 32768) {
			yRaw = dataMagnetoArray[1];
		} else {
			yRaw = (dataMagnetoArray[1] - 65536);
		}
		
		if(dataMagnetoArray[2] < 32768) {
			zRaw = dataMagnetoArray[2];
		} else {
			zRaw = (dataMagnetoArray[2] - 65536);
		}

	xScaled = (float)(xRaw) * convertMagneto;
	yScaled = (float)(yRaw) * convertMagneto;
	zScaled = (float)(zRaw) * convertMagneto;

	if(xScaled  == 0) {
		if(yScaled > 0) {
			heading = 90;
		} else {
			heading = -90;
		}
	} else {
		heading = (180 / 3.1415926) * atan2(yScaled, -xScaled);
	}

//	} else if(xScaled > 0){
//		heading = (180 / 3.1415926) * atan2(yScaled, xScaled);
//	} else if(yScaled < 0) {
//		heading = 180 + (180 / 3.1415926) * atan2(yScaled, xScaled);
//	} else {
//		heading = -180 + (180 / 3.1415926) * atan2(yScaled, xScaled);
//	}
	
  	heading += (180 / 3.1415926) * declinationAngle;
//	if(heading < 0){
//		heading += 360;
//	}
//	if(heading > 360){
//		heading -= 360;
//	}
//
//	if(heading < 0) {
//		heading += 6.2831852;
//	} else if(heading > 6.2831852) {
//		heading -= 6.2831852;
//	}
    
	if(xScaled < 0){
		fufoSendCharUART('-');
	}
	fufoSendIntUART((int)(xScaled*10));
	fufoSendCharUART(',');

	if(yScaled < 0){
		fufoSendCharUART('-');
	}
	fufoSendIntUART((int)(yScaled*10));
	fufoSendCharUART(',');


	//headingDegrees = (180 / 3.1415926) * heading; 

   
	return heading;
}
