phong1990/fufo-innovation/SourceCode/FUFO tich hop code HMC/Bluetooth/Bluetooth.h

//Define Bluetooth module

#define ATMODE	"AT"
#define ATB1 	"AT+BAUD1"
#define ATB2 	"AT+BAUD2"
#define ATB3 	"AT+BAUD3"
#define ATB4 	"AT+BAUD4"
#define ATB5 	"AT+BAUD5"
#define ATB6 	"AT+BAUD6"
#define ATB7 	"AT+BAUD7"
#define ATB8 	"AT+BAUD8"
#define ATNAME 	"AT+NAMEFUFO"
#define ATPIN 	"AT+PIN1234"

void fufoInitBluetooth(unsigned char *s);
void testConnectBluetooth(unsigned char *receiOK);
