phong1990/fufo-innovation/SourceCode/FUFO tich hop code HMC/ADXL345_accel/ADXL345.c

//Definition ADXL345 accelerometer
#include "../FUFO.h"
//---------------- Constantes ------------------
// ADXL345  Registers
#define ADXL345_DEVID                   0x00    // R     Device ID 
#define ADXL345_THRESH_TAP              0x1D    // R/W   Tap threshold 
#define ADXL345_OFSX                    0x1E    // R/W   X-axis offset 
#define ADXL345_OFSY                    0x1F    // R/W   Y-axis offset 
#define ADXL345_OFSZ                    0x20    // R/W   Z-axis offset 
#define ADXL345_DUR                     0x21    // R/W   Tap duration 
#define ADXL345_LATENT                  0x22    // R/W   Tap latency 
#define ADXL345_WINDOW                  0x23    // R/W   Tap window
#define ADXL345_THRESH_ACT              0x24    // R/W   Activity threshold 
#define ADXL345_THRESH_INACT    		0x25    // R/W   Inactivity threshold 
#define ADXL345_TIME_INACT              0x26    // R/W   Inactivity time 
#define ADXL345_ACT_INACT_CTL   		0x27    // R/W   Axis enable control for activity and inactivity detection 
#define ADXL345_THRESH_FF               0x28    // R/W   Free-fall threshold 
#define ADXL345_TIME_FF                 0x29    // R/W   Free-fall time 
#define ADXL345_TAP_AXES                0x2A    // R/W   Axis control for single tap/double tap 
#define ADXL345_ACT_TAP_STATUS  		0x2B    // R     Source of single tap/double tap 
#define ADXL345_BW_RATE                 0x2C    // R/W   Data Rate and power mode control 
#define ADXL345_POWER_CTL               0x2D    // R/W   Power-saving features control 
#define ADXL345_INT_ENABLE              0x2E    // R/W   Interrupt enable control 
#define ADXL345_INT_MAP                 0x2F    // R/W   Interrupt mapping control 
#define ADXL345_INT_SOURCE              0x30    // R     Source of interrupts 
#define ADXL345_DATA_FORMAT             0x31    // R/W   Data format control 
#define ADXL345_DATAX0                  0x32    // R     X-Axis Data 0 
#define ADXL345_DATAX1                  0x33    // R     X-Axis Data 1 
#define ADXL345_DATAY0                  0x34    // R     Y-Axis Data 0 
#define ADXL345_DATAY1                  0x35    // R     Y-Axis Data 1 
#define ADXL345_DATAZ0                  0x36    // R     Z-Axis Data 0 
#define ADXL345_DATAZ1                  0x37    // R     Z-Axis Data 1 
#define ADXL345_FIFO_CTL                0x38    // R/W   FIFO control 
#define ADXL345_FIFO_STATUS             0x39    // R     FIFO status

//-------------------------Functions-----------------------
//Initialize Accelerometer
unsigned char initAccel(void) {
	unsigned char error = 0;
	error += fufoWriteByteI2C(ADXL345_I2C, ADXL345_DATA_FORMAT, 0x0B);
	error += fufoWriteByteI2C(ADXL345_I2C, ADXL345_POWER_CTL, 0x08);
	error += fufoWriteByteI2C(ADXL345_I2C, ADXL345_BW_RATE, 0x0A);
	return error;
}

//Read the values in an array of 3 integers accel_X, accel_Y, accel_Z.
//Return an error if it can not.
unsigned char readAccel(unsigned int *data) {
	unsigned char error = 0;
	unsigned char datatemp[6];
	error += fufoReadArrayI2C(ADXL345_I2C, ADXL345_DATAX0, datatemp, 6);
	*data = ((datatemp[1] << 8)  | datatemp[0]) & (0x1FFF); //X_Axis
	*(data+1) = ((datatemp[3] << 8) | datatemp[2]) & (0x1FFF); //Y_Axis
	*(data+2) = ((datatemp[5] << 8) | datatemp[4])  & (0x1FFF); //Z_Axis
//	unsigned char datatemp[1];
//	unsigned char datatemp1[1];
//	error += fufoReadByteI2C(ADXL345_I2C, ADXL345_DATAX0, datatemp);
//	error += fufoReadByteI2C(ADXL345_I2C, ADXL345_DATAX1, datatemp1);
//	*data = ((datatemp1[0] << 8)&(0x1FFF)) | datatemp[0];
//	error += fufoReadByteI2C(ADXL345_I2C, ADXL345_DATAY0, datatemp);
//	error += fufoReadByteI2C(ADXL345_I2C, ADXL345_DATAY1, datatemp1);
//	*(data + 1) = ((datatemp1[0] << 8)&(0x1FFF)) | datatemp[0];
//	error += fufoReadByteI2C(ADXL345_I2C, ADXL345_DATAZ0, datatemp);
//	error += fufoReadByteI2C(ADXL345_I2C, ADXL345_DATAZ1, datatemp1);
//	*(data + 2) = ((datatemp1[0] << 8)&(0x1FFF)) | datatemp[0];
	return error;
}
