phong1990/fufo-innovation/(commit log)

2012-02-01 Add team contact information in 00.Other folder
    [FUFO_Team_Contact_Info.xls]
2012-02-01 Update project scope
    [FUFO_Team_Contact_Info.xls]
2012-02-06 add checklist review cho SRS
    [FUFO_Checklist_SRS_Review.xls]
2012-02-09 update phan viec của phong ngay 7/2
    [FUFO_Issue_list_Template.xlsx, FUFO_Team_Contact_Info.xls]
2012-02-12 add new plan for vp prọject
2012-02-18 New Template
    [Template_Estimate WBS.xls]
2012-03-01 up Research Report about accelerometer and gyroscope.doc
2012-03-06 add file pdf của schematic kit dspic30f4012
2012-03-06 bo web va thay vao do la application
2012-03-06 add file schematic altium 2009 cua DSPIC30F4012
    [RS232_485_dsPIC30.SchDoc]
2012-03-11 UPLOAD Research Report about accelerometer and gyroscope 2
2012-03-13 add design cho regulator tu 5V ve 3.3V
    [DC_5v_to_3v3.DSN]
2012-03-17 Add research report on YUV frame of Android camera
2012-03-21 update schematic of L1117 5v to 3.3v
    [DC_5v_to_3v3.DSN]
2012-03-21 create schematic of FUFO
    [FUFO.PcbDoc, FUFO.PcbLib, FUFO.PrjPCB, FUFO.SchDoc, FUFO.SchLib]
2012-03-21 update schematic of FUFO
    [FUFO.PcbLib, FUFO.SchLib]
2012-03-23 update schematic of FUFO, create bluetooth, ESC .v.v.
    [FUFO.PcbLib, FUFO.SchLib]
2012-03-26 upload calculate baud-rate document
    [Calc BaudrateConfig.xlsx]
2012-03-26 update calc method of baudrate I2C
    [Calc BaudrateConfig.xlsx]
2012-03-26 update baudrate = 100000 bd/s of I2C
    [Calc BaudrateConfig.xlsx]
2012-03-26 update schematic of FUFO, create some component.
    [FUFO.PcbLib, FUFO.SchDoc, FUFO.SchLib]
2012-03-28 thiết kế mạch in
    [FUFO.PcbDoc, FUFO.PcbLib, FUFO.PrjPCB, FUFO.SchDoc, FUFO.SchLib]
2012-03-28 update baudrate error percent
    [Calc BaudrateConfig.xlsx]
2012-03-29 update sensor's datasheet
2012-03-30 update mạch in
    [FUFO.PcbDoc, FUFO.SchDoc]
2012-03-31 convert to MS Office 2003
    [Calc BaudrateConfig.xls, Calc BaudrateConfig.xlsx]
2012-04-05 Add source code demo for taking frame in Android Camera and convert it to JPEG
    [proguard.cfg]
2012-04-19 Add milestones
    [FUFO_Milestone.xls]
2012-04-21 êtsst
    [tét.xlsx]
2012-04-21 update schematic and pcb to pdf file
2012-04-22 code test PWM dùng independent
2012-04-23 modify code test PWM
2012-04-24 sample pwm servo
2012-04-26 test PWM use timer
2012-04-26 demo software PWM tren 1 timer
2012-04-26 update code su dung 2 timer lam PWM
2012-04-26 pwm sample using hardware
2012-04-26 document for ESC HW30A
2012-05-06 edit PCB
    [FUFO.PcbDoc, FUFO.PcbLib, FUFO.PrjPCB, FUFO.SchDoc, FUFO.SchLib]
2012-05-06 update file pdf Schematic and PCB
2012-05-06 Add FUFO ;))
    [FUFO.PcbDoc]
2012-05-07 update location FUFO
    [FUFO.PcbDoc]
2012-05-07 update PCD, hy vọng là bản cuối :(
    [FUFO.PcbDoc, FUFO.SchDoc]
2012-05-07 Add project source folder, package, first code control Command in AOC
    [proguard.cfg]
2012-05-07 update PCB
    [FUFO.PcbDoc]
2012-05-08 update code test de ngay mai test, co ca file hex de phong truong hop may hu.
2012-05-08 update code ADC
2012-05-09 add code test PWM by ADC
2012-05-09 update PCB & SCH.PDF
2012-05-10 add datasheet of ESC regulator (11.1v -> 5v)
2012-05-15 upload code MSSP (test accel and gyro)
2012-05-16 update code sensor
2012-05-16 upload project C30 code test sensor
2012-05-16 update code test sensor 3:20 am 17/05/2012
2012-05-17 update code test pwm
2012-05-19 bnag cach doc cac ky tu la tinh trong toan hoc va trong vat ly
2012-05-25 fix bug thread
2012-05-25 update code for get data from accel or gyro
2012-06-04 edit crystal
    [FUFO.PcbDoc]
2012-06-04 add requirement for frame design
2012-06-05 update code nhan du lieu tu android qua uart2
2012-06-05 Add code test 4 motor.
2012-06-05 Add FUFO control flowchart.
2012-06-06 add acceleromter and gyroscope reading in to the report
2012-06-06 adđ application note for accelerometer and gyroscope
2012-06-06 update FUFO's FlowChart
2012-06-07 update code for FUFO, complete method initPWM :D
    [Tinh tan so.xls]
2012-06-07 add complementary filter
2012-06-08 change the equations in Complimentary filter
2012-06-08 update cong thuc cua PID, phan D
2012-06-10 Update Frame Design project
    [FUFO_CarbonBar.skp, FUFO_Frame_CarbonBar.skp, FUFO_Frame_LandingGear.skp, FUFO_Frame_MotorMount.skp, FUFO_Frame_OngRen.skp, FUFO_Frame_S-1.skp, FUFO_Frame_S-2.skp, FUFO_Frame_S0.skp]
2012-06-11 update the final version of frame and components
    [FUFO_Frame_CarbonBar.skp, FUFO_Frame_LandingGear.skp, FUFO_Frame_MotorMount.skp, FUFO_Frame_S-1.skp, FUFO_Frame_S-2.skp, FUFO_Frame_S0.skp, FUFO_Frame_S1.skp, FUFO_Frame_S2.skp]
2012-06-11 them muc component cho autocad
    [FUFO_Frame_LandingGear.dwg, FUFO_Frame_MotorMount.dwg, FUFO_Frame_S-1.dwg, FUFO_Frame_S-2.dwg, FUFO_Frame_S0.dwg, FUFO_Frame_S1.dwg, FUFO_Frame_S1.skp, FUFO_Frame_S2.dwg]
2012-06-14 update final version
    [FUFO_CarbonBar.skp, FUFO_Frame_CarbonBar.skp, FUFO_Frame_S-1.dwg, FUFO_Frame_S-1.skp, FUFO_Frame_S0.dwg, FUFO_Frame_S0.skp, FUFO_Frame_S1.dwg, FUFO_Frame_S1.skp]
2012-06-22 update filter
    [FUFO_Frame_S-1.skp, FUFO_Frame_S-2.skp, FUFO_Frame_S0.skp]
2012-06-22 update cmct thread
2012-06-23 add lowpass filter and high pass filter
2012-06-23 add Magnetometer and Yaw angle calculation
2012-06-27 update code FSM for FUFO
    [Tinh tan so.xls]
2012-06-27 Commit Right Button
2012-06-27 Add left Button
2012-06-27 add Up and Down Buttons
2012-06-27 update code read data from sensor 64Mhz, long type
2012-06-27 Add rotate left and right button
2012-06-27 Add hover up and down buttons
2012-06-27 sample data 27/06/2012
2012-06-28 update code Sensor for FUFO
2012-06-29 Add Interface and text bar and change the appearance of some buttons
2012-07-03 update code test PID
2012-07-04 update code test PID, test roll angle.
2012-07-05 test pid 05/07
2012-07-09 update code set prescaler timer PWM 16
2012-07-09 upgrade Fcy with PLL8, prescaler timer PWM 1:16, send theta, PDC1 to android.
2012-07-12 code lay du lieu gyros accel cho Phong!
2012-07-13 update source code test PID: test roll(theta Angle)
2012-07-13 code test PID KpTheta = 0.6765; KdTheta = 2.8787; KiTheta = 0.7197;
2012-07-14 update code test PID P = 0.8824; I = 0.9467; D = 3.7869;
2012-07-18 add button acction for gui aoc v2
2012-07-18 test PID #define KpTheta 0.9 #define KdTheta 0.2097 #define KiTheta 0.9656
2012-07-21 high pass filter
2012-07-23 code test PID p = 9, d = 3
2012-07-26 update PID plot for theta
2012-07-28 test PID goc Phi o muc 60 roi 50, xuat du lieu : Phi, Theta, PWM motor 2.
2012-07-28 Add minimize and exit buttons
2012-07-29 bo set point, PID gần như là ok :)
2012-07-29 Update version 2 of FUFO's Frame
    [Battery_Pack.skp, Fiber_Bar.skp, Full_Perspective.skp, Layer1.skp, Surface_Stabilizer.skp]
2012-08-10 góc Pitch, cột đầu là góc trả ra bởi acce, cột 2 là vận tốc góc trả ra bởi Gyros, Hung nhân sẵn cho 1000 rồi.
2012-08-12 code test PID co du lieu PID moi, test sang chu nhat dang sau truong. thay doi 1 chut ve instruction.
2012-08-13 update for test PID
2012-08-13 code test I, dek bi gi het!
    [Tinh tan so.xls]
2012-08-14 data for PID 14-08-2012
2012-08-14 Filter altitude matlab
2012-08-14 dk motor 3 eo cmn dc
2012-08-15 lan test cuoi cung trong ngay, PID, setpoint on dinh.
2012-08-16 code test PID, setpoint, on dinh.
2012-08-16 Test PID va setpoint OK :D
2012-08-17 New Test Case
    [FUFO_TestCase_Final.xls]
2012-08-17 update tai lieu de in
2012-08-17 update code control manual
    [Tinh tan so.xls]
2012-08-22 Bản Presetation Final
2012-08-22 update code magneto
2012-08-24 Bản demo
    [Report&Bug List.xls]
2012-08-24 update magnetometer
2012-08-24 code tich hop HMC, doi while trong I2C = if
    [Tinh tan so.xls]
2012-08-26 update bản mới nhất
2012-08-27 Version final nhóe!
    [FUFO_Buglist_V1.0.xlsx, FUFO_TestReport_Total.xls]
2012-08-27 Update UT
    [FUFO_Project_UnitTest_AOC_v1.0.xls, FUFO_Project_UnitTest_AOP_v1.0.xls, FUFO_Project_UnitTest_FUFO_v1.0.xls]
